leofernandesc/Open-source-sram-memory-compiler/docs/relatorio_validacao_bitcell_6t_sky130.md

# Relatório de desenvolvimento e validação da bitcell SRAM 6T

## Escopo

Este documento registra o desenvolvimento da célula SRAM 6T single-port para SKY130A, incluindo a preparação dos esquemáticos, a criação do testbench hierárquico no Xschem, os testes manuais em ngspice e a automação da varredura de leitura.

O relatório separa resultados executados daqueles que continuam pendentes. A presença de um resultado PASS neste documento não substitui netlist final, caracterização completa, DRC, LVS ou validação do layout.

## Ambiente utilizado

Os testes foram executados no container:

~~~text
isaiassh/unic-cass-tools:1.1.0
~~~

Configuração usada:

~~~text
PDK=sky130A
PDK_ROOT=/opt/pdks
ngspice=44.2
~~~

O projeto foi montado no container em:

~~~text
/home/designer/shared
~~~

O PDK SKY130A usado nos decks está em:

~~~text
/opt/pdks/sky130A
~~~

Biblioteca de modelos:

~~~text
/opt/pdks/sky130A/libs.tech/combined/continuous/sky130.lib.spice
~~~

## 1. Topologia definida

A bitcell possui uma porta de leitura/escrita e seis transistores:

- dois inversores CMOS cruzados, formando o biestável;
- dois NMOS de acesso conectados a BL e BLB;
- uma linha de palavra WL comum aos transistores de acesso;
- nós internos complementares Q e QB;
- alimentação VDD e VSS.

O contrato externo da bitcell é:

~~~text
BL BLB WL VDD VSS
~~~

O sizing de projeto definido inicialmente foi:

| Dispositivos | Função | W (um) | L (um) |
|---|---|---:|---:|
| PMOS pull-up | restauração lógica | 0,21 | 0,15 |
| NMOS pull-down | estabilidade de leitura | 0,42 | 0,15 |
| NMOS de acesso | leitura e escrita | 0,30 | 0,15 |

As razões previstas são:

~~~text
beta  = Wpull-down / Waccess = 0,42 / 0,30 = 1,40
gamma = Wpull-up   / Waccess = 0,21 / 0,30 = 0,70
~~~

Esses valores são requisitos de projeto. Eles ainda não foram validados no modelo contínuo usado nos testes, porque o runtime não encontrou bins válidos para W=0,21 um e W=0,30 um na forma de instância utilizada.

## 2. Captura manual dos esquemáticos

### Esquemático da bitcell 6T no Xschem

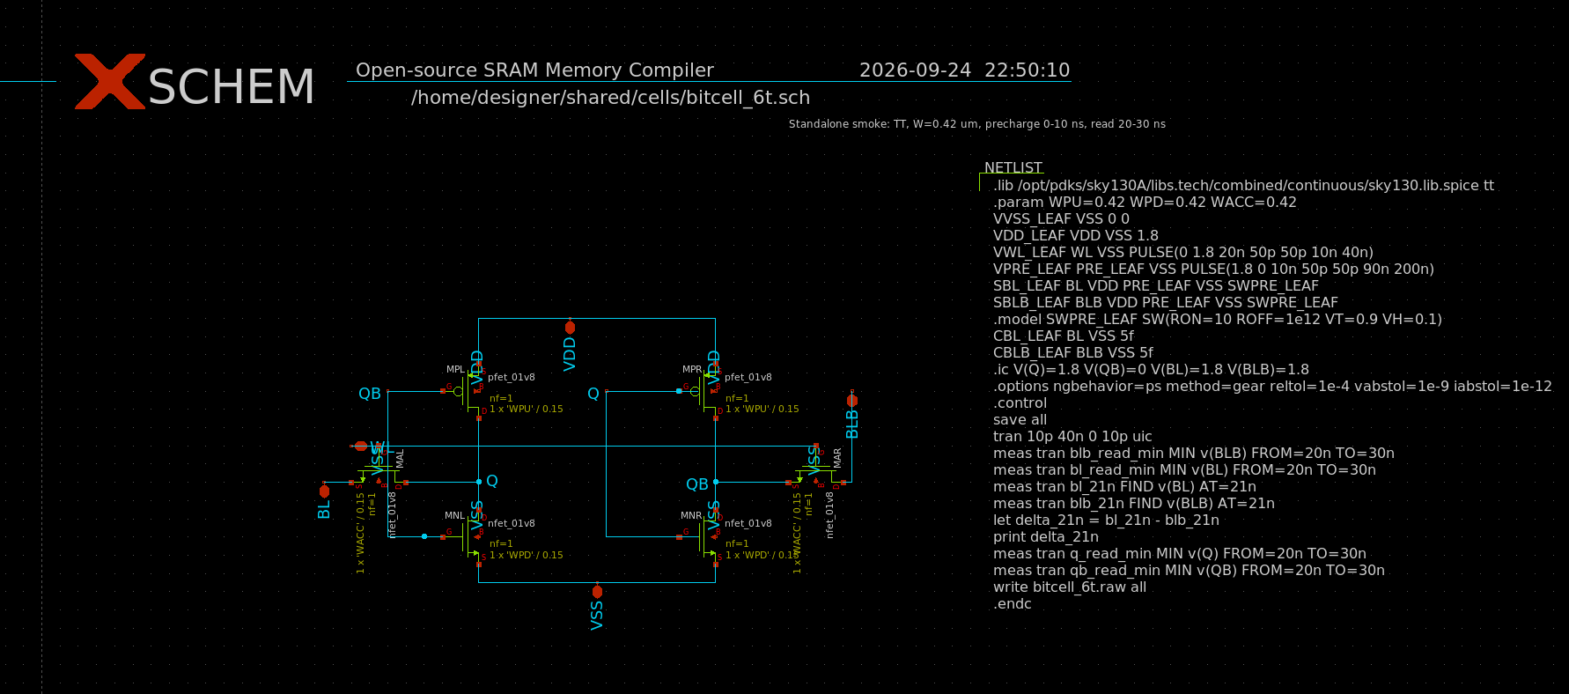
[picture p2: docs/assets/bitcell_6t_xschem.png]
Esquemático da bitcell SRAM 6T no Xschem


*Figura 1. Captura do esquemático da bitcell SRAM 6T com os nós Q, QB, BL, BLB, WL, VDD e VSS.*

### Testbench hierárquico de leitura no Xschem

Foi criado um símbolo hierárquico para a bitcell e um testbench visual de
leitura com a seguinte estrutura:

~~~text
sims/bitcell_6t/tb_bitcell_6t_read.sch
└── cells/bitcell_6t/bitcell_6t.sym
    └── cells/bitcell_6t/bitcell_6t.sch
~~~

O testbench contém a instância `XBITCELL`, fontes de `VDD`, `WL` e `PRE`,
chaves ideais de pré-carga em `BL` e `BLB`, capacitores de 5 fF nas bitlines e
um bloco de controle com as medições de leitura. A sequência representada é:

- pré-carga desligada após 10 ns;
- leitura com `WL` ativo de 20 ns a 30 ns;
- observação de `BL`, `BLB` e `Q`.

Testbench hierárquico da bitcell SRAM 6T no Xschem

*Figura 2. Testbench hierárquico de leitura com a bitcell, pré-carga, capacitâncias de bitline e bloco de controle SKY130A.*

Arquivos criados:

~~~text
cells/bitcell_6t/bitcell_6t.sym
sims/bitcell_6t/tb_bitcell_6t_read.sch
~~~

A geração e a simulação do netlist hierárquico foram verificadas no corner
`tt`. O símbolo expande a interface `VDD BL BLB VSS WL` e permite passar
`WPU`, `WPD` e `WACC`. A instância do testbench usa 0,42 µm nos seis
transistores; os valores alvo continuam como padrões do símbolo e ainda não
foram validados no conjunto de modelos contínuos instalado.

Foram preparados os seguintes arquivos em cells/:

| Arquivo | Função | Estado |
|---|---|---|
| cells/bitcell_6t/bitcell_6t.sch | bitcell SRAM 6T | netlist hierárquico e simulação `tt` verificados com sizing provisório |
| cells/sense_amp/sense_amp.sch | voltage-latch sense amplifier | rascunho estrutural |
| cells/precharge/precharge.sch | pré-carga e equalização | rascunho estrutural |
| cells/wordline_driver/wl_driver.sch | driver de WL | rascunho estrutural |
| cells/write_driver/write_driver.sch | driver diferencial de escrita | rascunho estrutural |
| cells/README.md | contrato de pinos | documentado |

Os nomes de sinais foram padronizados como:

~~~text
BL BLB WL SCLK PRECH DATA DATA_B WE VDD VSS SA_OUT SA_OUTB
~~~

O sense_amp foi definido como um latch diferencial habilitado por SCLK. Os
símbolos das células periféricas ainda dependem de inspeção de conectividade
e validação elétrica próprias.

## 3. Preparação do ambiente gráfico

Inicialmente foi tentado o modo VNC. A porta 80 já estava ocupada pelo container esafe-traefik, causando:

~~~text
Bind for :::80 failed: port is already allocated
~~~

O problema foi contornado usando portas alternativas durante a tentativa VNC:

~~~text
WEBSERVER_PORT=8081
VNC_PORT=5902
JUPYTER_PORT=8889
~~~

Em seguida foi escolhido o modo local, sem VNC, com DISPLAY=:0 e o socket X11 do host:

~~~bash
make \
  SHARED_DIR=/home/danilo_cunha/projetos/ueletronica/projeto-sram/Open-source-sram-memory-compiler \
  PDK=sky130A \
  DOCKER_TAG=1.1.0 \
  start
~~~

Dentro do container, o Xschem foi aberto com:

~~~bash
cd /home/designer/shared
export PDK=sky130A
export PDK_ROOT=/opt/pdks
xschem cells/bitcell_6t/bitcell_6t.sch
~~~

## 4. Dificuldades com o netlist e a simulação Xschem

Ao tentar simular diretamente bitcell_6t.sch, o Xschem gerou instâncias como:

~~~text
XMP1 ... sky130_fd_pr__pfet_01v8
~~~

O ngspice reportou:

~~~text
Unknown subckt: xmp1 ... sky130_fd_pr__pfet_01v8
~~~

Os símbolos `sky130_fd_pr` geram instâncias `X`. Ao netlistar a folha
isoladamente, a biblioteca contínua não estava incluída e o ngspice não
reconhecia `sky130_fd_pr__pfet_01v8` e `sky130_fd_pr__nfet_01v8`. Foi incluído
em `bitcell_6t.sch` um bloco `netlist.sym` marcado `only_toplevel=true`, com a
biblioteca SKY130A `tt` e parâmetros provisórios de 0,42 µm. Assim, o modelo
fica disponível ao netlist isolado; dentro da hierarquia esse bloco é omitido,
pois o testbench já carrega a biblioteca e fornece os parâmetros da instância.

A bitcell continua sendo uma leaf cell. Para que o botão **Simulate** também
seja útil quando `bitcell_6t.sch` estiver aberta diretamente, o bloco top-level
foi ampliado com um smoke test local: fontes de VDD, WL e PRE, duas chaves de
pré-carga, cargas de 5 fF, condições iniciais e análise transitória. Todo esse
conteúdo usa `only_toplevel=true`, portanto não entra no subcircuito quando a
bitcell é instanciada por outro esquemático.

Os avisos sobre arquivos OSDI ausentes, como `psp103_nqs.osdi`, são distintos
da falha `Unknown subckt`; eles não impedem essa simulação com a biblioteca
contínua.

### 4.1 Tentativa de simulação da bitcell isolada

O erro observado foi:

~~~text
Error: unknown subckt: xmpl q qb vdd vdd sky130_fd_pr__pfet_01v8 ...
~~~

O netlist gerado referenciava subcircuitos SKY130 sem carregar a biblioteca e
usava parâmetros de sizing sem valores no contexto top-level. O primeiro
ajuste carregou `sky130.lib.spice tt` e definiu
`WPU=WPD=WACC=0.42 µm`. Isso removeu `unknown subckt`, mas revelou a mensagem:

~~~text
Warning: No job (tran, ac, op etc.) defined:
run simulation not started
~~~

Essa segunda mensagem não indicava falha de modelo. Ela mostrava que a folha
não possuía uma análise. O bloco foi então convertido em `STANDALONE_TEST`,
com estímulos equivalentes aos do testbench hierárquico e o comando
`tran 10p 40n 0 10p uic`.

A simulação isolada passou a produzir:

~~~text
No. of Data Rows : 4038
blb_read_min = 3.727678e-08 V
bl_read_min  = 1.799997 V
bl_21n       = 1.835385 V
blb_21n      = 3.727678e-08 V
delta_21n    = 1.835385 V
q_read_min   = 1.778301 V
qb_read_min  = 3.060375e-08 V
binary raw file "bitcell_6t.raw"
~~~

Esse smoke test valida a leitura de Q=1/QB=0 no corner `tt`, com 5 fF e
sizing uniforme de 0,42 µm. Ele não substitui o sweep de corners, estados e
capacitâncias executado pelo deck externo.

### 4.2 Simulação hierárquica de leitura

O testbench hierárquico permite inspecionar as conexões e executar a leitura
no Xschem. A expansão foi confirmada com:

~~~spice
XBITCELL VDD BL BLB GND WL bitcell_6t WPU=0.42 WPD=0.42 WACC=0.42
.subckt bitcell_6t VDD BL BLB VSS WL WPU=0.21 WPD=0.42 WACC=0.30
~~~

O erro `could not find a valid modelname` ocorria porque as larguras alvo de
0,21 e 0,30 µm não selecionam bins válidos dos modelos contínuos instalados.
Com a instância provisória de 0,42 µm, `.lib .../sky130.lib.spice tt` e
condições iniciais nos nós `xbitcell.Q`/`xbitcell.QB`, o netlist hierárquico
foi simulado pelo ngspice sem esse erro. A diferença em 21 ns foi
`1,835385 V`; o mínimo de Q durante a leitura foi `1,778301 V`. O deck
externo produziu `1,83618 V` e `1,773700 V`, respectivamente. A pequena
diferença reflete detalhes distintos de parasitas das instâncias.

## 5. Testes manuais sem automação

### 5.1 Testbench manual de retenção, leitura inicial e escrita

Arquivo:

~~~text
sims/bitcell_6t/tb_bitcell_6t.spice
~~~

Execução:

~~~bash
cd /home/designer/shared/sims/bitcell_6t
ngspice -n -b tb_bitcell_6t.spice | tee tb_bitcell_6t_tt.log
~~~

Resultado obtido:

~~~text
q_hold              = 1.800000e+00
qb_hold             = 3.777216e-08
bl_read             = 1.800000e+00
blb_read            = 1.800000e+00
q_read_min          = 1.799998e+00
q_after_write       = 3.769092e-08
qb_after_write      = 1.800000e+00
ngspice-44.2 done
~~~

Interpretação:

| Verificação | Resultado |
|---|---|
| retenção de Q=1, QB=0 | passou |
| escrita para Q=0, QB=1 | passou |
| execução do ngspice | passou |
| diferencial real de leitura | não validado neste deck |

A leitura não foi validada nesse primeiro deck porque BL e BLB estavam presas a fontes ideais de 1,8 V.

Esse deck também usou, por limitação do modelo contínuo, o sizing provisório:

~~~text
WPU=WPD=WACC=0,42 um
~~~

### 5.2 Testbench manual de leitura com bitlines capacitivas

Arquivo:

~~~text
sims/bitcell_6t/tb_bitcell_6t_read.spice
~~~

O segundo deck acrescentou:

- chaves controladas para pré-carga;
- capacitâncias em BL e BLB;
- liberação das bitlines durante WL;
- medição de BLB mínimo para o estado Q=1, QB=0;
- medição de BL mínimo para o estado inverso Q=0, QB=1;
- medição do nó armazenado em nível alto para verificar read disturb.

Execução manual:

~~~bash
cd /home/designer/shared/sims/bitcell_6t
ngspice -n -b tb_bitcell_6t_read.spice | tee tb_bitcell_6t_read_5f.log
~~~

Para CBL=CBLB=5 fF, após corrigir o período de `PRE`, o resultado foi:

~~~text
bl_pre              = 1.800000 V
blb_pre             = 1.800000 V
bl_21n              = 1.836183 V
blb_21n             = 0.000000046 V
delta_21n           = 1.83618 V
q_read_min          = 1.773700 V
~~~

Na versão anterior, `PRE` voltava ao nível alto em 20 ns, junto com `WL`.
Por isso, o diferencial de `1,08432 mV` em 29 ns e a queda máxima de
`0,8468485 V` não mediam a leitura com a pré-carga desligada. Esses
resultados foram substituídos. A medição de `blb_read_min` continua útil para
acompanhar a descarga completa, mas o critério automatizado usa a diferença
entre `BL` e `BLB` em 21 ns:

~~~spice
.meas tran bl_21n FIND V(bl) AT=21n
.meas tran blb_21n FIND V(blb) AT=21n
.meas tran blb_read_min MIN V(blb) FROM=20n TO=30n
~~~

Uma diretiva .meas deve estar dentro do arquivo SPICE. Ela não pode ser digitada diretamente no Bash.

## 6. Automação da varredura

Foi criado o script:

~~~text
sims/bitcell_6t/run_bitcell_read_sweep.py
~~~

O script:

1. lê tb_bitcell_6t_read.spice como template;
2. troca a capacitância de BL e BLB;
3. testa os estados Q=1/QB=0 e Q=0/QB=1;
4. troca automaticamente o corner do .lib;
5. executa o ngspice em arquivos temporários;
6. extrai BL/BLB em 21 ns, os mínimos das bitlines e os mínimos de Q/QB;
7. calcula o diferencial em 21 ns com a polaridade esperada para cada estado;
8. verifica o nó armazenado em nível alto;
9. salva o resultado em CSV;
10. retorna código diferente de zero se algum caso falhar.

Critérios usados pelo script:

~~~text
delta_21n >= 50 mV
nó armazenado em nível alto >= 0,9 V
~~~

O segundo critério é selecionado corretamente para cada estado. Quando Q=0, Q próximo de zero é esperado; nesse caso, o script verifica QB.

### 6.1 Execução padrão

~~~bash
cd /home/designer/shared/sims/bitcell_6t
python3 run_bitcell_read_sweep.py
~~~

Essa execução usa o corner padrão tt e quatro capacitâncias:

~~~text
5 fF, 10 fF, 20 fF e 50 fF
~~~

### 6.2 Execução em todos os corners

~~~bash
python3 run_bitcell_read_sweep.py --corners tt ff ss fs sf
~~~

Essa execução cobre:

~~~text
5 corners × 4 capacitâncias × 2 estados = 40 simulações
~~~

Relatório gerado:

~~~text
sims/bitcell_6t/bitcell_read_sweep.csv
~~~

## 7. Resultado automatizado nos corners SKY130A

Todos os 40 casos executados retornaram PASS com os critérios provisórios do script.

O menor diferencial em 21 ns foi:

| Corner | Capacitância | Estado | Bitline descarregada | delta_21n |
|---|---:|---:|---|---:|
| ss | 50 fF | Q=1 ou Q=0 | BLB ou BL | 1,4258955 V |

Menores diferenciais por corner em 50 fF:

| Corner | delta_21n mínimo |
|---|---:|
| tt | 1,6381313 V |
| ff | 1,7337567 V |
| ss | 1,4258955 V |
| fs | 1,4886067 V |
| sf | 1,7171562 V |

Esses resultados mostram margem acima do critério automatizado de 50 mV para o modelo e o sizing provisório usados.

## 8. Limitações e interpretação dos resultados

Os resultados não constituem sign-off da bitcell. Permanecem as seguintes limitações:

1. O teste automatizado usa WPU=WPD=WACC=0,42 um, não o sizing alvo WPU=0,21 um, WPD=0,42 um e WACC=0,30 um.
2. O modelo contínuo disponível rejeitou os bins necessários para os valores menores de largura na forma de instância usada.
3. O critério automatizado usa `delta_21n >= 50 mV`. A janela de detecção real do sense amplifier e a capacitância de uma coluna completa ainda precisam ser definidos.
4. O testbench hierárquico foi validado no corner `tt` e estado Q=1/QB=0; o sweep de cinco corners e dois estados usa o deck externo.
5. sense_amp, precharge, wl_driver e write_driver ainda não possuem testbenches elétricos aprovados.
6. Não foram executados SNM de retenção, SNM de leitura, write margin, leakage, Monte Carlo de mismatch, DRC, LVS ou extração parasitária.
7. A bitline foi representada por um modelo simples de chave e capacitor. Esse modelo ainda não representa a coluna completa, a resistência dos drivers, o sense amplifier ou a distribuição real de parasitas.

## 9. Estado atual

| Item | Estado |
|---|---|
| topologia 6T | definida |
| contrato de pinos | definido |
| captura inicial Xschem | netlist e conectividade verificados |
| smoke isolado da bitcell | simulação `tt`, 4038 pontos e arquivo RAW gerado |
| retenção manual | passou no sizing provisório |
| escrita manual | passou no sizing provisório |
| leitura com bitlines ideais | não conclusiva |
| leitura com bitlines capacitivas | passou com critério de 50 mV |
| sweep de capacitância | automatizado |
| corners tt/ff/ss/fs/sf | 40 casos executados, todos PASS no critério de 50 mV |
| símbolo hierárquico da bitcell | criado e expandido no netlist Xschem |
| testbench hierárquico de leitura | simulado em `tt`; deck externo usado para sweep |
| sizing alvo 0,21/0,42/0,30 um | pendente |
| sense amplifier | pendente |
| drivers e pré-carga | pendentes |
| SNM, write margin e leakage | pendentes |
| layout, DRC e LVS | pendentes |

## 10. Próximos testes

A sequência recomendada é:

1. Obter modelos válidos para o sizing alvo e reexecutar a varredura.
2. Definir o instante de habilitação do sense amplifier e a carga real da coluna.
3. Automatizar retenção e escrita nos cinco corners.
4. Testar o precharge com equalização e desligamento correto.
5. Testar o write_driver com DATA, DATA_B e WE.
6. Testar o wl_driver, medindo amplitude e atraso de WL.
7. Criar o testbench do sense_amp com diferenças de entrada de 5 mV a 20 mV.
8. Integrar a sequência precharge -> write -> hold -> read -> SCLK.
9. Medir SNM, write margin, leakage e variação Monte Carlo.
10. Só depois iniciar layout, DRC, LVS e extração parasitária.
