leofernandesc/Open-source-sram-memory-compiler/layout/row_decoder/reports/lvs_connectivity.txt

Magic 8.3 revision 684 - Compiled on Thu Oct  8 05:07:09 PM CEST 2026.
Starting magic under Tcl interpreter
Using the terminal as the console.
Using NULL graphics device.
Processing system .magicrc file
Switching to WIRING tool.
Switching to NETLIST tool.
Switching to PICK tool.
Switching to BOX tool.
Sourcing design .magicrc for technology sky130A ...
2 Magic internal units = 1 Lambda
Input style sky130(): scaleFactor=2, multiplier=2
The following types are not handled by extraction and will be treated as non-electrical types:
    ubm
Scaled tech values by 2 / 1 to match internal grid scaling
Loading sky130A Device Generator Menu ...
Using technology "sky130A", version 1.0.493-0-g0fe599b
Cell row_decoder_flat read from current working directory
Extracting row_decoder_flat into row_decoder_flat.ext:
Processing row_decoder_flat
exttospice finished.
