leofernandesc/Open-source-sram-memory-compiler/docs/row_decoder_sizing.md

# Dynamic row decoder sizing record

Current-source update (2026-10-07): **B7 is now retained** after a complete
264-case qualification and finer numerical comparisons. The B0--B6 tables
below remain historical experiments. Use the
[current characterization record](row_decoder_contract_characterization.md)
for the 29-MOS buffered source, measured costs and remaining limits, and the
[Person 3 Phase 1 plan](person3_phase1_remaining_tasks.md) for subsequent work.

Status: sizing in progress. The measurements below define the loaded reference
candidate; they do not establish final transistor sizes or PVT robustness.

The [whole-circuit review and sizing campaign](row_decoder_sizing_plan.md)
extends this record. The repaired runner reproduces B5 timing and its output
logic passes, but its output-NMOS VGS screen detects dynamic-node peaks above
the published 1.95 V model envelope under the original 50 ps clock. Gear 10 ps,
Gear 5 ps, and trapezoidal 5 ps runs all report 16/16 excursions, so the finding
is not specific to the tested integration method or timestep. Historical
72/72 PASS entries below refer to sampled output voltages, not this envelope
check. Clock/model-envelope closure now precedes final sizing.

The current schematic is corrective candidate **B6**. Its measured precharge
and address-inverter widths remove the observed upper excursions under the
tested conditions. See [the feedthrough investigation](row_decoder_feedthrough_fix.md)
for cause isolation, alternatives, terminal extrema and PVT experiments.

## Baseline setup

| Item | Value |
|---|---|
| Candidate | `B0` — uniform baseline |
| Schematic | `cells/row_decoder/row_decoder.sch` |
| Testbench | `sims/row_decoder/tb_row_decoder_sizing.sch` |
| Process/model | SKY130A, TT |
| Supply/temperature | 1.80 V, 27 °C |
| Tools | Xschem 3.4.6, ngspice 44.2 |
| Wordline load | One 17.4 fF capacitor from each `WL` output to GND |
| Load implementation | Four hierarchical instances of `cells/wordline_driver/wl_driver.sch` |
| Decoder sizing | All 25 MOS: W=1.00 µm, L=0.15 µm, nf=1, mult=1 |
| Wordline driver sizing | Stage 1 W=0.42 µm; stage 2 W=0.84 µm; L=0.15 µm |

The 17.4 fF capacitor is the current pre-layout estimate for one complete
wordline. It is attached to each wordline-driver output; the decoder output
drives the input devices of that driver. The separate 50 fF stress load has not
been run in this decoder sizing series.

The copied testbench preserves the original functional bench. Its current
generated node mapping is `net5`=WL0, `net6`=WL1, `net7`=WL2, and `net8`=WL3.
The sizing bench was netlisted after correcting the WL1 output connection; all
four decoder outputs now feed distinct drivers and all four WL outputs have
separate loads.

## Measurement definitions

- Evaluation level checks: sample DEC and WL outputs at 15, 35, 55, and 75 ns
  for addresses 00, 01, 10, and 11.
- Precharge level checks: sample DEC and WL outputs at 5, 25, 45, 65, and 85 ns.
- Screening limits: selected output >= 0.9 VDD (1.62 V); inactive output <=
  0.1 VDD (0.18 V). These limits are used by this screen and are not numeric
  limits stated in the technical specification.
- Evaluation delay: PCLK rising through 0.5 VDD to the selected DEC or WL output
  rising through 0.5 VDD.
- Precharge delay: PCLK falling through 0.5 VDD to the selected DEC or WL output
  falling below 0.1 VDD.

Each run contains 36 DEC voltage samples and 36 WL voltage samples. Rise and
precharge delays are measured for each selected row. Keep these definitions and
the same input stimulus for every candidate.

## Candidate comparison

| Candidate | W address inverter | W precharge PFET | W evaluation NMOS | W footer NMOS | W output inverter P/N | Load | DEC eval max | WL eval max | DEC precharge max | WL precharge max | Voltage checks |
|---|---:|---:|---:|---:|---:|---:|---:|---:|---:|---:|---|
| B0 | 1.00 µm | 1.00 µm | 1.00 µm | 1.00 µm | 1.00 / 1.00 µm | 17.4 fF | 93.30 ps | 272.65 ps | 119.55 ps | 295.94 ps | 72/72 PASS |
| B1 | 1.00 µm | 1.00 µm | 1.50 µm | 1.00 µm | 1.00 / 1.00 µm | 17.4 fF | 95.04 ps | 274.60 ps | 151.92 ps | 326.98 ps | 72/72 PASS |
| B2 | 1.00 µm | 1.00 µm | 1.00 µm | 1.50 µm | 1.00 / 1.00 µm | 17.4 fF | 84.56 ps | 263.50 ps | 123.18 ps | 298.50 ps | 72/72 PASS |
| B3 | 1.00 µm | 1.00 µm | 1.00 µm | 1.25 µm | 1.00 / 1.00 µm | 17.4 fF | 87.93 ps | 267.03 ps | 121.60 ps | 297.23 ps | 72/72 PASS |
| B4 | 1.00 µm | 1.00 µm | 1.00 µm | 0.75 µm | 1.00 / 1.00 µm | 17.4 fF | 102.59 ps | 282.46 ps | 118.54 ps | 294.75 ps | 72/72 PASS |
| B5 | 1.00 µm | 1.00 µm | 1.00 µm | 0.50 µm | 1.00 / 1.00 µm | 17.4 fF | 121.92 ps | 302.94 ps | 117.35 ps | 292.90 ps | 72/72 PASS |
| B6 | 0.42 µm | 0.42 µm | 1.00 µm | 0.50 µm | 1.00 / 1.00 µm | 17.4 fF | 121.36 ps | 302.04 ps | 240.05 ps | 413.64 ps | 72/72 PASS; upper VGS screen PASS |

B6 is measured with Gear 5 ps; B0–B5 historical timing uses the original
10 ps reference. The feedthrough report compares B5 and B6 at the same 5 ps
setting. Its 54-condition B6 campaign is separate from the historical TT-only
footer experiments. B6 is a corrective baseline, not a final optimum.

All channels are L=0.15 µm for B0. Group membership is:

- Address inverters: M1–M4.
- Precharge PFETs: M5, M11, M16, M21.
- Evaluation NMOS network: M6, M7, M12, M13, M17, M18, M22, M23.
- Shared footer: M8.
- DEC output inverters: M9/M10, M14/M15, M19/M20, M24/M25 (PMOS/NMOS).

## B0 measured results

| Metric | Result |
|---|---:|
| Evaluation samples passing | 32/32 (16 DEC + 16 WL) |
| Precharge samples passing | 40/40 (20 DEC + 20 WL) |
| Selected DEC and WL levels | 1.800 V at all sample points |
| Largest absolute deselected DEC sample | 0.994 µV |
| Largest absolute deselected WL sample | 0.292 µV |
| Largest absolute DEC precharge sample | 0.434 µV |
| Largest absolute WL precharge sample | 0.292 µV |
| DEC evaluation delay range | 88.74–93.30 ps |
| WL evaluation delay range | 268.01–272.65 ps |
| DEC precharge delay range | 117.90–119.55 ps |
| WL precharge delay range | 293.70–295.94 ps |

## B1 measured results

B1 changes only the evaluation-network NMOS widths (M6, M7, M12, M13, M17,
M18, M22, and M23) from 1.00 µm to 1.50 µm. The shared footer M8 and all other
devices remain at B0 widths. Xschem generated the updated hierarchy without
structural errors; the generated SPICE netlist was checked to contain W=1.50 µm
on all eight changed devices. ngspice completed with return code 0.

| Metric | Result |
|---|---:|
| Evaluation samples passing | 32/32 (16 DEC + 16 WL) |
| Precharge samples passing | 40/40 (20 DEC + 20 WL) |
| Selected DEC and WL levels | 1.800 V at all sample points |
| Largest absolute deselected DEC sample | 1.311 µV |
| Largest absolute deselected WL sample | 0.291 µV |
| Largest absolute DEC precharge sample | 0.486 µV |
| Largest absolute WL precharge sample | 0.291 µV |
| DEC evaluation delay range | 90.44–95.04 ps |
| WL evaluation delay range | 270.03–274.60 ps |
| DEC precharge delay range | 147.97–151.92 ps |
| WL precharge delay range | 323.50–326.98 ps |

Relative to B0, B1's maximum measured delays increased by 1.74 ps for DEC
evaluation, 1.95 ps for WL evaluation, 32.37 ps for DEC precharge, and 31.04 ps
for WL precharge. Thus B1 passes the same nominal voltage screen but does not
improve the measured timing for this load. The larger evaluation devices add
capacitance to the dynamic nodes; that is a plausible contributor to the slower
precharge and is an engineering interpretation of the measurements, not a
separately isolated capacitance measurement.

## B2 measured results

B2 returns the eight evaluation-network NMOS devices to 1.00 µm and changes
only the shared footer M8 from 1.00 µm to 1.50 µm. Xschem generated the current
schematic hierarchy without structural errors; the generated netlist was checked
to contain the intended widths. ngspice completed with return code 0.

| Metric | Result |
|---|---:|
| Evaluation samples passing | 32/32 (16 DEC + 16 WL) |
| Precharge samples passing | 40/40 (20 DEC + 20 WL) |
| Selected DEC and WL levels | 1.800 V at all sample points |
| Largest absolute deselected DEC sample | 0.995 µV |
| Largest absolute deselected WL sample | 0.291 µV |
| Largest absolute DEC precharge sample | 0.439 µV |
| Largest absolute WL precharge sample | 0.291 µV |
| DEC evaluation delay range | 79.44–84.56 ps |
| WL evaluation delay range | 258.32–263.50 ps |
| DEC precharge delay range | 120.23–123.18 ps |
| WL precharge delay range | 296.28–298.50 ps |

Relative to B0, B2's maximum evaluation delays decreased by 8.74 ps for DEC
and 9.15 ps for WL. Its maximum precharge delays increased by 3.63 ps for DEC
and 2.56 ps for WL. B2 therefore improves evaluation timing in this nominal
loaded screen while slightly slowing precharge; both phases still pass the
screening voltage limits.

## B3 measured results

B3 changes only the shared footer M8 from 1.50 µm in B2 to 1.25 µm; all other
devices remain at B0 widths. The Xschem-generated netlist confirmed M8 at
W=1.25 µm and the eight evaluation-network NMOS devices at W=1.00 µm. Xschem
and ngspice completed without errors.

| Metric | Result |
|---|---:|
| Evaluation samples passing | 32/32 (16 DEC + 16 WL) |
| Precharge samples passing | 40/40 (20 DEC + 20 WL) |
| Selected DEC and WL levels | 1.800 V at all sample points |
| Largest absolute deselected DEC sample | 0.994 µV |
| Largest absolute deselected WL sample | 0.291 µV |
| Largest absolute DEC precharge sample | 0.436 µV |
| Largest absolute WL precharge sample | 0.291 µV |
| DEC evaluation delay range | 83.14–87.93 ps |
| WL evaluation delay range | 262.17–267.03 ps |
| DEC precharge delay range | 118.88–121.60 ps |
| WL precharge delay range | 295.15–297.23 ps |

Relative to B0, B3's maximum evaluation delays decreased by 5.37 ps for DEC
and 5.62 ps for WL. Its maximum precharge delays increased by 2.05 ps for DEC
and 1.29 ps for WL. B2 remains faster in evaluation, while B3 is slightly
faster in precharge.

## B4 measured results

B4 changes only the shared footer M8 from 1.00 µm in B0 to 0.75 µm; all other
devices remain at B0 widths. The Xschem-generated netlist confirmed the intended
widths, and Xschem and ngspice completed without errors.

| Metric | Result |
|---|---:|
| Evaluation samples passing | 32/32 (16 DEC + 16 WL) |
| Precharge samples passing | 40/40 (20 DEC + 20 WL) |
| Selected DEC and WL levels | 1.800 V at all sample points |
| Largest absolute deselected DEC sample | 0.994 µV |
| Largest absolute deselected WL sample | 0.291 µV |
| Largest absolute DEC precharge sample | 0.432 µV |
| Largest absolute WL precharge sample | 0.291 µV |
| DEC evaluation delay range | 98.62–102.59 ps |
| WL evaluation delay range | 278.41–282.46 ps |
| DEC precharge delay range | 116.66–118.54 ps |
| WL precharge delay range | 291.89–294.75 ps |

Relative to B0, B4's maximum evaluation delays increased by 9.29 ps for DEC
and 9.81 ps for WL, while maximum precharge delays decreased by 1.01 ps for
DEC and 1.19 ps for WL. B4 therefore trades evaluation speed for a small
precharge improvement.

## B5 measured results

B5 changes only the shared footer M8 from 0.75 µm in B4 to 0.50 µm; all other
devices remain at the B0 widths. The Xschem-generated netlist confirmed M8 at
W=0.50 µm and the eight evaluation-network NMOS devices at W=1.00 µm. The
loaded testbench contains the four wordline drivers and a 17.4 fF capacitor on
each wordline. Xschem and ngspice completed without errors.

| Metric | Result |
|---|---:|
| Evaluation samples passing | 32/32 (16 DEC + 16 WL) |
| Precharge samples passing | 40/40 (20 DEC + 20 WL) |
| Selected DEC and WL levels | 1.800 V at all sample points |
| Largest absolute deselected DEC sample | 0.995 µV |
| Largest absolute deselected WL sample | 0.291 µV |
| Largest absolute DEC precharge sample | 0.430 µV |
| Largest absolute WL precharge sample | 0.291 µV |
| DEC evaluation delay range | 118.60–121.92 ps |
| WL evaluation delay range | 299.58–302.94 ps |
| DEC precharge delay range | 114.53–117.35 ps |
| WL precharge delay range | 289.82–292.90 ps |

Relative to B0, B5's maximum evaluation delays increased by 28.62 ps for DEC
and 30.29 ps for WL, while maximum precharge delays decreased by 2.20 ps for
DEC and 3.04 ps for WL. Relative to B4, evaluation became 19.33 ps slower for
DEC and 20.48 ps slower for WL; precharge became 1.19 ps faster for DEC and
1.85 ps faster for WL. B5 passes the same nominal voltage screen and is the
fastest precharge candidate measured so far, with the slowest evaluation among
the tested footer widths. These results show a timing tradeoff; they do not
identify a single best width without a project-level priority between
evaluation and precharge.

## B6 corrective sizing results

B6 changes the four address-inverter and four precharge widths to 0.42 um,
while retaining M8 at 0.50 um and the other devices at 1.00 um. Fresh Xschem
netlisting matches the netlist used in its qualification campaign. At TT,
1.8 V, 27 C, 50 ps clock and 17.4 fF/WL, the loaded testbench passes 72/72
voltage samples and 252 non-model window/internal/timing checks. Maximum
output-NMOS VGS drops to 1.90111 V; there are no per-cycle upper excursions.
The bare decoder also passes all 36 voltage samples.

Relative to B5 with the same Gear 5 ps method, maximum WL evaluation changes
from 302.91 to 302.04 ps, while WL precharge completion increases from 292.39
to 413.64 ps. This longer recovery must be retained in the low-phase budget.
Mean VDD stimulus-cycle energy drops from 123.76 to 120.46 fJ; clock/address
source energy is excluded. Sum(W*L) drops from 3.675 to 2.979 um2, a channel
proxy rather than measured layout area.

## Interpretation and next work

B0 is a measured nominal-TT reference with the wordline drivers and estimated
wordline loads attached. B1 is functionally passing in the same nominal-TT
screen, but is slower than B0 in all four recorded maximum timing metrics. B2
is fastest in evaluation so far; reducing the footer toward B3, B4, and B5
trades evaluation speed for faster precharge. B5 is fastest in precharge so
far within that historical footer series. B0–B5 were measured at nominal TT
without the later terminal-envelope criteria. B6 adds a PVT/slew experiment;
none of these results establish decoder layout, DRC, LVS or extracted timing.

Continue with the address-history, captured-address setup and phase-duration
experiments from B6, retaining both timing and terminal-voltage checks. Further
family sizing, including a possible 0.42 um footer, must preserve the measured
voltage margins and precharge budget rather than ranking candidates only by
their evaluation delay.

Before selecting that combined candidate, follow the clock/model-envelope,
address-history, family/interactions, load, PVT and extracted-netlist campaign
in the linked review. At the historical B5 sizes, 250 ps clock edges pass the
tested upper-VGS screen while 50 ps edges do not; this diagnostic does not
approve a new macro clock-slew limit.

## 2026-10-07: expanded address-history qualification supersedes the sizing inference

The earlier B6 results remain measurements for their archived stimulus. They
do not qualify every address history: simultaneous two-bit changes with
Gear 1 ps and CHGTOL=1e-18 C expose an M2 VDS maximum of **1.974458 V**
at SS/1.8 V/-40 C. B6 remains the source schematic, not a final robust sizing.

Leonardo selected greater electrical margin and robustness as the decoder
selection priority. The implemented contract executor now measures all ordered
histories, address arrival, phase lengths, finite retention, edge asymmetry,
charge perturbations, signed external MOS terminal extrema and family
interactions. Failed comparisons are retained. The new
[characterization record](row_decoder_contract_characterization.md) contains
the current evidence, numerical-breakpoint investigation and reproducible
commands. Physical closure and full signed model-domain review remain open.
