leofernandesc/Open-source-sram-memory-compiler/docs/cwl_pre_layout_estimate.md

# Orçamento pré-layout da capacitância de wordline

Status em 05/10/2026: **baseline pré-layout congelada; G6 físico concluído e
G7/PEX aberto**. A bitcell e o `wl_driver` já possuem layout com Magic DRC `0`
e Netgen LVS único. Os valores deste documento permanecem como referência do
screening esquemático e **não** devem ser tratados como capacitâncias PEX.

Fonte dos resultados: documentação e CSVs importados da branch de Danilo
`feat/sram-6t-cell`, commit `8c16199`. Esses resultados não foram reexecutados
nesta branch.

Fonte dos resultados: documentação e CSVs importados da branch do Danilo
`feat/sram-6t-cell`, commit `8c16199`. Esses resultados não foram reexecutados
nesta branch.

Este documento fecha um bound de engenharia para a carga da wordline antes do
layout. O objetivo é substituir o antigo smoke arbitrário de `50 fF` por uma
carga derivada dos gates das oito bitcells da linha e de uma restrição física
de roteamento. O valor continua sendo pré-layout e deve ser substituído pelo
PEX no G7 após o fechamento físico G6.

## Capacitância dos gates de acesso

`sims/run_wordline_capacitance.py` mede por AC pequena-sinal a capacitância de
gate do NMOS de acesso da bitcell 6T, com `WACC=0,60 µm` e `WL=0`, nos cinco corners,
`1,62/1,80 V`, `-40/27/125 °C`, dois estados de Q e as duas orientações
source/drain.

- `120/120 PASS`;
- `Cgate,max = 0,541868469 fF`;
- pior ponto: `ff/1,80 V/-40 °C`, Q=0;
- uma linha de 8 bits contém 16 gates de acesso:
  `Cgate,row,max = 16 × 0,541868469 = 8,669895504 fF`.

No bench integrado, os dois gates da célula selecionada já estão presentes no
netlist. Logo, a parcela adicional das outras sete células é:

```text
Cgate,extra = 14 × 0,541868469
            = 7,586158566 fF
```

## Bound pré-layout do fio

Para schematic freeze, a WL é orçada em `metal1`, largura mínima `0,14 µm`,
com até `5,0 µm` de extensão horizontal por bit e oito bits por linha. O corner
de capacitância máxima do `sky130A.tech` fornece:

- `defaultareacap(metal1) = 35,7 aF/µm²`;
- `defaultperimeter(metal1) = 49,59 aF/µm`;
- `defaultsidewall(metal1) = 37,6 aF/µm`;
- `metal1 -> metal2 defaultoverlap = 313 aF/µm²`;
- dois vizinhos laterais;
- 16 cruzamentos M1–M2, pois a WL cruza `BL` e `BLB` dos oito bits;
- margem adicional de engenharia de 20%.

O bound é:

```text
Cwire_per_um = (35,7×0,14 + 2×49,59 + 2×37,6) aF/µm
             = 0,179378 fF/µm

Ccross_M1_M2 = 313×0,14×0,14 aF
             = 0,0061348 fF por cruzamento

CWL_wire = 1,20 × (40×0,179378 + 16×0,0061348)
          = 8,727932160 fF
```

## Bound e ponto de screening

```text
CWL,row,max = Cgate,row,max + CWL_wire
            = 8,669895504 + 8,727932160
            = 17,397827664 fF

CWL,extra,max = Cgate,extra + CWL_wire
              = 7,586158566 + 8,727932160
              = 16,314090726 fF
```

Os benches integrados usam a bitcell selecionada explicitamente. Por isso o
capacitor lumped adicional adotado é **17 fF**, acima do bound
`CWL,extra,max=16,314090726 fF`. O antigo smoke de `50 fF` continua válido
apenas como stress test conservador e não como estimativa física da linha.

O bound `CWL,row,max=17,397827664 fF` e o capacitor lumped adicional de `17 fF`
ficam preservados como baseline pré-layout. Com o layout das leafs já fechado
em G6 e a extração RC das leafs iniciada no G7, a etapa pendente é obter a carga
física representativa da wordline na integração de coluna/array e substituir a
baseline lumped pelo valor pós-layout correspondente. Em seguida, requalificar
slew, atraso, largura efetiva de WL e read-disturb. Se o PEX alterar o contrato
usado no screening, o gate de timing da WL deve ser reaberto.
