leofernandesc/Open-source-sram-memory-compiler/memory/memory-ip/run_state.md

run_id:      memory-ip_20260921_165204
design_name: sram_6t_cell
tool:        xschem
start_time:  2026-09-21T16:52:04-04:00
last_stage:  schematic_capture
