leofernandesc/Open-source-sram-memory-compiler/docs/assets/capture_to_pclk_margin.png

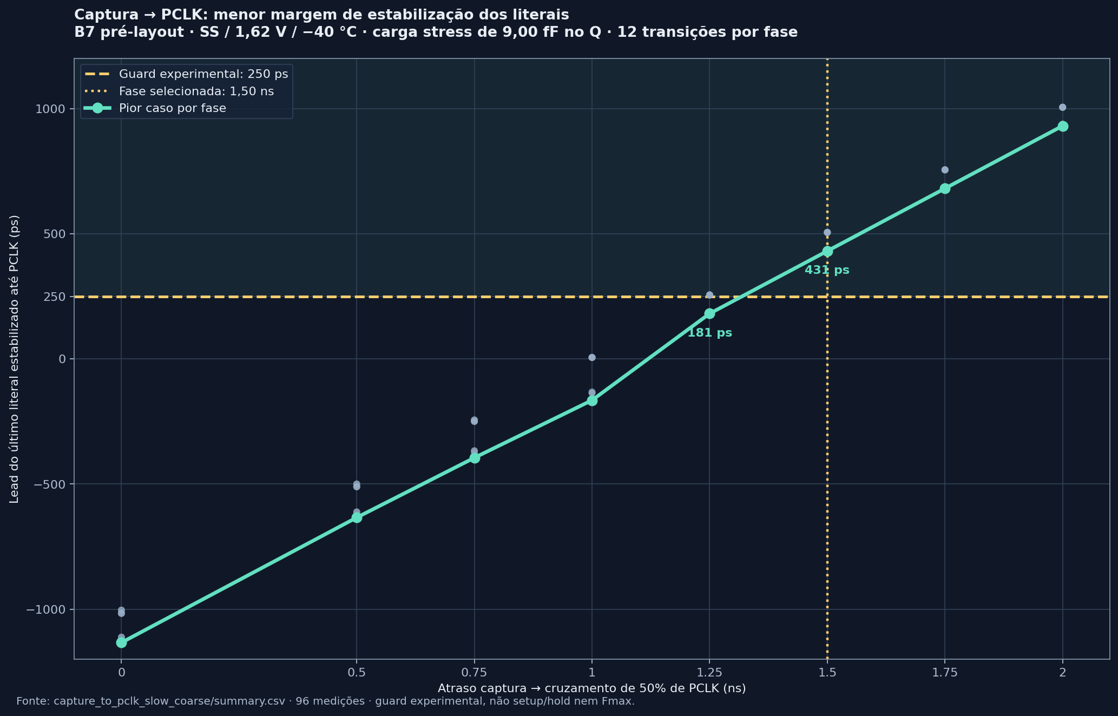
docs/assets/capture_to_pclk_margin.png
