leofernandesc/Open-source-sram-memory-compiler/docs/assets/row_decoder_b7.png

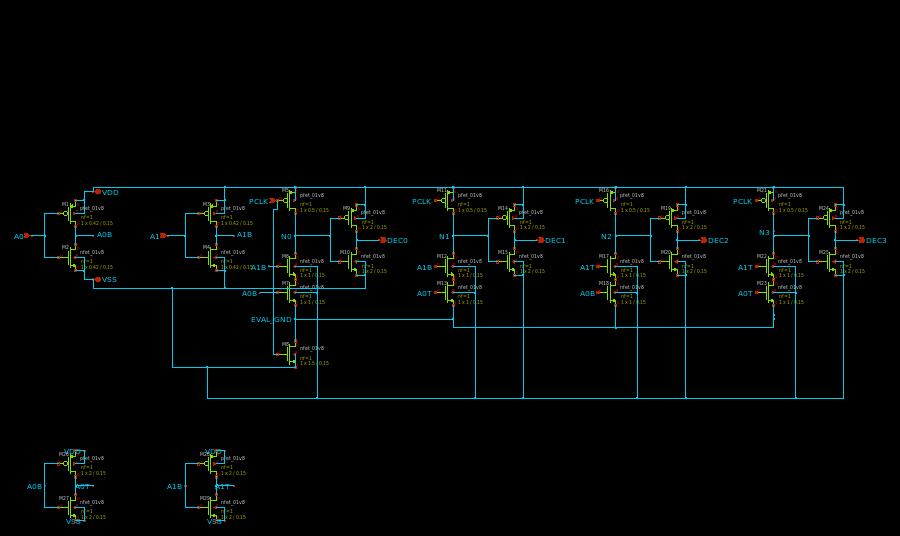
docs/assets/row_decoder_b7.png
