leofernandesc/Open-source-sram-memory-compiler/layout/row_decoder/reports/compaction/build.txt

Xschem MOS: 29 (12 PFET, 17 NFET)
Magic DRC hierarchical/top: 0
Magic DRC flattened: 0
Logs: /work/layout/row_decoder/reports
DRC PASS
Magic connectivity extraction: 29 MOS devices; no RC PEX requested
Netgen LVS: Circuits match uniquely
Logs: /work/layout/row_decoder/reports/lvs_extract.log and /work/layout/row_decoder/reports/lvs.log
RC PEX is stale/pending; no extresist was run.
