leofernandesc/Open-source-sram-memory-compiler/sims/row_decoder/results/row_decoder_pex_precharge_refinement_20261008/waveforms.pdf

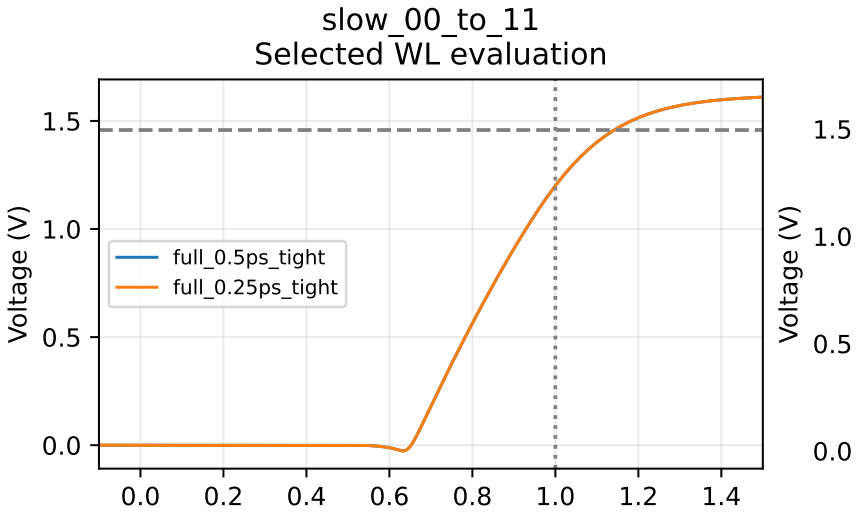
[picture p21: figure]
Voltage (V); slow_00_to_11 Selected WL evaluation; full_0.5ps_tight; full_0.25ps_tight

Time from PCLK 50% edge (ns)

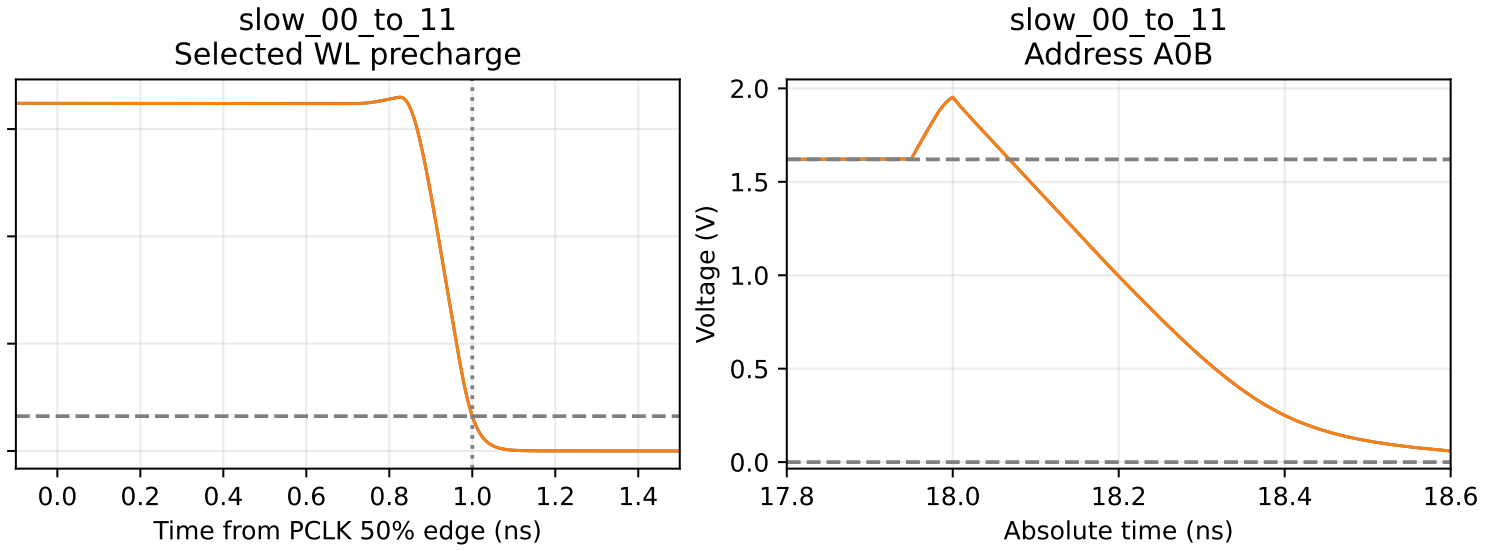
[picture p22: figure]
slow_00_to_11 Selected WL precharge; Absolute time (ns); Voltage (V); slow_00_to_11 Address A0B

Time from PCLK 50% edge (ns)

Existing decoder PEX: convergence and artificial R/C isolation No R / no C curves are diagnostic only; WL buffers remain schematic

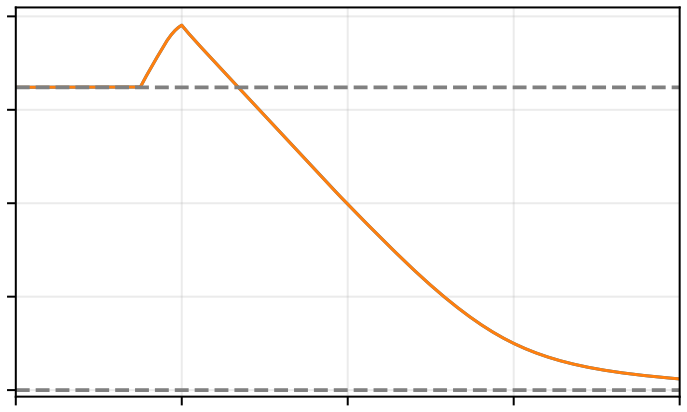
[picture p23: figure]
