leofernandesc/Open-source-sram-memory-compiler/layout/row_decoder/reports/closure_unit_tests.txt

.....................................
----------------------------------------------------------------------
Ran 37 tests in 0.267s

OK
