leofernandesc/Open-source-sram-memory-compiler/layout/row_decoder/reports/compaction/routing_provenance_tests.txt

test_local_tracks_are_finite_and_separate_on_shared_layers (test_compact_routing.CompactRoutingTests.test_local_tracks_are_finite_and_separate_on_shared_layers) ... ok
test_nine_public_pins_preserve_logical_interface (test_compact_routing.CompactRoutingTests.test_nine_public_pins_preserve_logical_interface) ... ok
test_shared_precharge_stack_columns_escape_to_different_nets (test_compact_routing.CompactRoutingTests.test_shared_precharge_stack_columns_escape_to_different_nets) ... ok
test_short_shared_via_islands_have_metal3_minimum_area (test_compact_routing.CompactRoutingTests.test_short_shared_via_islands_have_metal3_minimum_area) ... ok
test_changed_layout_is_rejected (test_compact_routing.ProvenanceTests.test_changed_layout_is_rejected) ... ok
test_changed_schematic_is_rejected (test_compact_routing.ProvenanceTests.test_changed_schematic_is_rejected) ... ok
test_drc_or_lvs_failure_prevents_binding (test_compact_routing.ProvenanceTests.test_drc_or_lvs_failure_prevents_binding) ... ok
test_eol_and_nonphysical_timestamp_changes_are_portable (test_compact_routing.ProvenanceTests.test_eol_and_nonphysical_timestamp_changes_are_portable) ... ok
test_lvs_only_never_qualifies_historical_pex (test_compact_routing.ProvenanceTests.test_lvs_only_never_qualifies_historical_pex) ... ok
test_replaced_pex_is_rejected (test_compact_routing.ProvenanceTests.test_replaced_pex_is_rejected) ... ok

----------------------------------------------------------------------
Ran 10 tests in 0.010s

OK
