leofernandesc/Open-source-sram-memory-compiler/sims/row_decoder/results/b5_review_tt_clock250_samples.csv

bench | candidate | corner | vdd_v | temperature_c | phase | address | sample_time_ns | output | voltage_v | expected_logic | criterion | result | xschem_returncode | xschem_structural_status | ngspice_returncode
sizing | B5_clock_diagnostic | tt | 1.8 | 27 | evaluate | 00 | 15 | DEC0 | 1.8 | 1 | 1.62 <= V <= 1.98 | PASS | 0 | PASS | 0
sizing | B5_clock_diagnostic | tt | 1.8 | 27 | evaluate | 00 | 15 | DEC1 | -7.327063e-07 | 0 | -0.18 <= V <= 0.18 | PASS | 0 | PASS | 0
sizing | B5_clock_diagnostic | tt | 1.8 | 27 | evaluate | 00 | 15 | DEC2 | 3.109817e-08 | 0 | -0.18 <= V <= 0.18 | PASS | 0 | PASS | 0
sizing | B5_clock_diagnostic | tt | 1.8 | 27 | evaluate | 00 | 15 | DEC3 | 3.12349e-08 | 0 | -0.18 <= V <= 0.18 | PASS | 0 | PASS | 0
sizing | B5_clock_diagnostic | tt | 1.8 | 27 | evaluate | 00 | 15 | WL0 | 1.8 | 1 | 1.62 <= V <= 1.98 | PASS | 0 | PASS | 0
sizing | B5_clock_diagnostic | tt | 1.8 | 27 | evaluate | 00 | 15 | WL1 | 2.914771e-07 | 0 | -0.18 <= V <= 0.18 | PASS | 0 | PASS | 0
sizing | B5_clock_diagnostic | tt | 1.8 | 27 | evaluate | 00 | 15 | WL2 | 2.914772e-07 | 0 | -0.18 <= V <= 0.18 | PASS | 0 | PASS | 0
sizing | B5_clock_diagnostic | tt | 1.8 | 27 | evaluate | 00 | 15 | WL3 | 2.914772e-07 | 0 | -0.18 <= V <= 0.18 | PASS | 0 | PASS | 0
sizing | B5_clock_diagnostic | tt | 1.8 | 27 | evaluate | 01 | 35 | DEC0 | -8.513844e-07 | 0 | -0.18 <= V <= 0.18 | PASS | 0 | PASS | 0
sizing | B5_clock_diagnostic | tt | 1.8 | 27 | evaluate | 01 | 35 | DEC1 | 1.8 | 1 | 1.62 <= V <= 1.98 | PASS | 0 | PASS | 0
sizing | B5_clock_diagnostic | tt | 1.8 | 27 | evaluate | 01 | 35 | DEC2 | 3.129161e-08 | 0 | -0.18 <= V <= 0.18 | PASS | 0 | PASS | 0
sizing | B5_clock_diagnostic | tt | 1.8 | 27 | evaluate | 01 | 35 | DEC3 | 3.109817e-08 | 0 | -0.18 <= V <= 0.18 | PASS | 0 | PASS | 0
sizing | B5_clock_diagnostic | tt | 1.8 | 27 | evaluate | 01 | 35 | WL0 | 2.914771e-07 | 0 | -0.18 <= V <= 0.18 | PASS | 0 | PASS | 0
sizing | B5_clock_diagnostic | tt | 1.8 | 27 | evaluate | 01 | 35 | WL1 | 1.8 | 1 | 1.62 <= V <= 1.98 | PASS | 0 | PASS | 0
sizing | B5_clock_diagnostic | tt | 1.8 | 27 | evaluate | 01 | 35 | WL2 | 2.914772e-07 | 0 | -0.18 <= V <= 0.18 | PASS | 0 | PASS | 0
sizing | B5_clock_diagnostic | tt | 1.8 | 27 | evaluate | 01 | 35 | WL3 | 2.914772e-07 | 0 | -0.18 <= V <= 0.18 | PASS | 0 | PASS | 0
sizing | B5_clock_diagnostic | tt | 1.8 | 27 | evaluate | 10 | 55 | DEC0 | 3.110621e-08 | 0 | -0.18 <= V <= 0.18 | PASS | 0 | PASS | 0
sizing | B5_clock_diagnostic | tt | 1.8 | 27 | evaluate | 10 | 55 | DEC1 | 3.129961e-08 | 0 | -0.18 <= V <= 0.18 | PASS | 0 | PASS | 0
sizing | B5_clock_diagnostic | tt | 1.8 | 27 | evaluate | 10 | 55 | DEC2 | 1.8 | 1 | 1.62 <= V <= 1.98 | PASS | 0 | PASS | 0
sizing | B5_clock_diagnostic | tt | 1.8 | 27 | evaluate | 10 | 55 | DEC3 | -8.417949e-07 | 0 | -0.18 <= V <= 0.18 | PASS | 0 | PASS | 0
sizing | B5_clock_diagnostic | tt | 1.8 | 27 | evaluate | 10 | 55 | WL0 | 2.914772e-07 | 0 | -0.18 <= V <= 0.18 | PASS | 0 | PASS | 0
sizing | B5_clock_diagnostic | tt | 1.8 | 27 | evaluate | 10 | 55 | WL1 | 2.914772e-07 | 0 | -0.18 <= V <= 0.18 | PASS | 0 | PASS | 0
sizing | B5_clock_diagnostic | tt | 1.8 | 27 | evaluate | 10 | 55 | WL2 | 1.8 | 1 | 1.62 <= V <= 1.98 | PASS | 0 | PASS | 0
sizing | B5_clock_diagnostic | tt | 1.8 | 27 | evaluate | 10 | 55 | WL3 | 2.914771e-07 | 0 | -0.18 <= V <= 0.18 | PASS | 0 | PASS | 0
sizing | B5_clock_diagnostic | tt | 1.8 | 27 | evaluate | 11 | 75 | DEC0 | 3.129862e-08 | 0 | -0.18 <= V <= 0.18 | PASS | 0 | PASS | 0
sizing | B5_clock_diagnostic | tt | 1.8 | 27 | evaluate | 11 | 75 | DEC1 | 3.11052e-08 | 0 | -0.18 <= V <= 0.18 | PASS | 0 | PASS | 0
sizing | B5_clock_diagnostic | tt | 1.8 | 27 | evaluate | 11 | 75 | DEC2 | -8.433072e-07 | 0 | -0.18 <= V <= 0.18 | PASS | 0 | PASS | 0
sizing | B5_clock_diagnostic | tt | 1.8 | 27 | evaluate | 11 | 75 | DEC3 | 1.8 | 1 | 1.62 <= V <= 1.98 | PASS | 0 | PASS | 0
sizing | B5_clock_diagnostic | tt | 1.8 | 27 | evaluate | 11 | 75 | WL0 | 2.914772e-07 | 0 | -0.18 <= V <= 0.18 | PASS | 0 | PASS | 0
sizing | B5_clock_diagnostic | tt | 1.8 | 27 | evaluate | 11 | 75 | WL1 | 2.914772e-07 | 0 | -0.18 <= V <= 0.18 | PASS | 0 | PASS | 0
sizing | B5_clock_diagnostic | tt | 1.8 | 27 | evaluate | 11 | 75 | WL2 | 2.914771e-07 | 0 | -0.18 <= V <= 0.18 | PASS | 0 | PASS | 0
sizing | B5_clock_diagnostic | tt | 1.8 | 27 | evaluate | 11 | 75 | WL3 | 1.8 | 1 | 1.62 <= V <= 1.98 | PASS | 0 | PASS | 0
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
sizing | B5_clock_diagnostic | tt | 1.8 | 27 | precharge | x | 65 | WL3 | 2.914772e-07 | 0 | -0.18 <= V <= 0.18 | PASS | 0 | PASS | 0
sizing | B5_clock_diagnostic | tt | 1.8 | 27 | precharge | x | 85 | DEC0 | 3.067219e-07 | 0 | -0.18 <= V <= 0.18 | PASS | 0 | PASS | 0
sizing | B5_clock_diagnostic | tt | 1.8 | 27 | precharge | x | 85 | DEC1 | 3.355159e-07 | 0 | -0.18 <= V <= 0.18 | PASS | 0 | PASS | 0
sizing | B5_clock_diagnostic | tt | 1.8 | 27 | precharge | x | 85 | DEC2 | 3.1174e-07 | 0 | -0.18 <= V <= 0.18 | PASS | 0 | PASS | 0
sizing | B5_clock_diagnostic | tt | 1.8 | 27 | precharge | x | 85 | DEC3 | 3.1174e-07 | 0 | -0.18 <= V <= 0.18 | PASS | 0 | PASS | 0
sizing | B5_clock_diagnostic | tt | 1.8 | 27 | precharge | x | 85 | WL0 | 2.914772e-07 | 0 | -0.18 <= V <= 0.18 | PASS | 0 | PASS | 0
sizing | B5_clock_diagnostic | tt | 1.8 | 27 | precharge | x | 85 | WL1 | 2.914772e-07 | 0 | -0.18 <= V <= 0.18 | PASS | 0 | PASS | 0
sizing | B5_clock_diagnostic | tt | 1.8 | 27 | precharge | x | 85 | WL2 | 2.914772e-07 | 0 | -0.18 <= V <= 0.18 | PASS | 0 | PASS | 0
sizing | B5_clock_diagnostic | tt | 1.8 | 27 | precharge | x | 85 | WL3 | 2.914772e-07 | 0 | -0.18 <= V <= 0.18 | PASS | 0 | PASS | 0
