leofernandesc/Open-source-sram-memory-compiler/sims/row_decoder/results/b5_review_tt_clock250_samples_metrics.csv

bench | candidate | corner | vdd_v | temperature_c | category | address | output | measurement | value | unit | low_limit | high_limit | result
sizing | B5_clock_diagnostic | tt | 1.8 | 27 | evaluate_window | 00 | DEC0 | win_00_dec0_min | 1.8 | V | 1.62 |  | PASS
sizing | B5_clock_diagnostic | tt | 1.8 | 27 | evaluate_window | 00 | DEC0 | win_00_dec0_max | 1.8 | V |  | 1.9800000000000002 | PASS
sizing | B5_clock_diagnostic | tt | 1.8 | 27 | evaluate_window | 00 | DEC1 | win_00_dec1_min | -7.086262e-05 | V | -0.18000000000000002 |  | PASS
sizing | B5_clock_diagnostic | tt | 1.8 | 27 | evaluate_window | 00 | DEC1 | win_00_dec1_max | 0.0007909013 | V |  | 0.18000000000000002 | PASS
sizing | B5_clock_diagnostic | tt | 1.8 | 27 | evaluate_window | 00 | DEC2 | win_00_dec2_min | -1.31037e-05 | V | -0.18000000000000002 |  | PASS
sizing | B5_clock_diagnostic | tt | 1.8 | 27 | evaluate_window | 00 | DEC2 | win_00_dec2_max | 0.0007858786 | V |  | 0.18000000000000002 | PASS
sizing | B5_clock_diagnostic | tt | 1.8 | 27 | evaluate_window | 00 | DEC3 | win_00_dec3_min | -1.321735e-05 | V | -0.18000000000000002 |  | PASS
sizing | B5_clock_diagnostic | tt | 1.8 | 27 | evaluate_window | 00 | DEC3 | win_00_dec3_max | 0.000785886 | V |  | 0.18000000000000002 | PASS
sizing | B5_clock_diagnostic | tt | 1.8 | 27 | evaluate_window | 00 | WL0 | win_00_wl0_min | 1.799652 | V | 1.62 |  | PASS
sizing | B5_clock_diagnostic | tt | 1.8 | 27 | evaluate_window | 00 | WL0 | win_00_wl0_max | 1.8 | V |  | 1.9800000000000002 | PASS
sizing | B5_clock_diagnostic | tt | 1.8 | 27 | evaluate_window | 00 | WL1 | win_00_wl1_min | -1.205696e-06 | V | -0.18000000000000002 |  | PASS
sizing | B5_clock_diagnostic | tt | 1.8 | 27 | evaluate_window | 00 | WL1 | win_00_wl1_max | 3.478671e-06 | V |  | 0.18000000000000002 | PASS
sizing | B5_clock_diagnostic | tt | 1.8 | 27 | evaluate_window | 00 | WL2 | win_00_wl2_min | -1.196516e-06 | V | -0.18000000000000002 |  | PASS
sizing | B5_clock_diagnostic | tt | 1.8 | 27 | evaluate_window | 00 | WL2 | win_00_wl2_max | 3.457378e-06 | V |  | 0.18000000000000002 | PASS
sizing | B5_clock_diagnostic | tt | 1.8 | 27 | evaluate_window | 00 | WL3 | win_00_wl3_min | -1.196532e-06 | V | -0.18000000000000002 |  | PASS
sizing | B5_clock_diagnostic | tt | 1.8 | 27 | evaluate_window | 00 | WL3 | win_00_wl3_max | 3.457408e-06 | V |  | 0.18000000000000002 | PASS
sizing | B5_clock_diagnostic | tt | 1.8 | 27 | crossing | 00 | PCLK | clk_0_rise | 1.0125e-08 | s | 9.999999e-09 | 1.0250001000000001e-08 | PASS
sizing | B5_clock_diagnostic | tt | 1.8 | 27 | crossing | 00 | DEC0 | t_00_dec0_rise10 | 1.02627e-08 | s | 1e-08 | 2.025e-08 | PASS
sizing | B5_clock_diagnostic | tt | 1.8 | 27 | crossing | 00 | DEC0 | t_00_dec0_rise50 | 1.0286e-08 | s | 1e-08 | 2.025e-08 | PASS
sizing | B5_clock_diagnostic | tt | 1.8 | 27 | crossing | 00 | DEC0 | t_00_dec0_rise90 | 1.0317e-08 | s | 1e-08 | 2.025e-08 | PASS
sizing | B5_clock_diagnostic | tt | 1.8 | 27 | evaluation_delay | 00 | DEC0 | delay_00_dec0_rise | 1.61005e-10 | s | 0 |  | PASS
sizing | B5_clock_diagnostic | tt | 1.8 | 27 | output_slew | 00 | DEC0 | slew_00_dec0_rise | 5.43936e-11 | s | 0 |  | PASS
sizing | B5_clock_diagnostic | tt | 1.8 | 27 | crossing | 00 | WL0 | t_00_wl0_rise10 | 1.03609e-08 | s | 1e-08 | 2.025e-08 | PASS
sizing | B5_clock_diagnostic | tt | 1.8 | 27 | crossing | 00 | WL0 | t_00_wl0_rise50 | 1.0467e-08 | s | 1e-08 | 2.025e-08 | PASS
sizing | B5_clock_diagnostic | tt | 1.8 | 27 | crossing | 00 | WL0 | t_00_wl0_rise90 | 1.06556e-08 | s | 1e-08 | 2.025e-08 | PASS
sizing | B5_clock_diagnostic | tt | 1.8 | 27 | evaluation_delay | 00 | WL0 | delay_00_wl0_rise | 3.42046e-10 | s | 0 |  | PASS
sizing | B5_clock_diagnostic | tt | 1.8 | 27 | output_slew | 00 | WL0 | slew_00_wl0_rise | 2.94718e-10 | s | 0 |  | PASS
sizing | B5_clock_diagnostic | tt | 1.8 | 27 | crossing | 00 | PCLK | clk_0_fall | 2.0375e-08 | s | 2.0249999e-08 | 2.0500001e-08 | PASS
sizing | B5_clock_diagnostic | tt | 1.8 | 27 | crossing | 00 | DEC0 | t_00_dec0_fall10 | 2.05385e-08 | s | 2.025e-08 | 3.0000000000000004e-08 | PASS
sizing | B5_clock_diagnostic | tt | 1.8 | 27 | crossing | 00 | DEC0 | t_00_dec0_fall50 | 2.05245e-08 | s | 2.025e-08 | 3.0000000000000004e-08 | PASS
sizing | B5_clock_diagnostic | tt | 1.8 | 27 | crossing | 00 | DEC0 | t_00_dec0_fall90 | 2.05095e-08 | s | 2.025e-08 | 3.0000000000000004e-08 | PASS
sizing | B5_clock_diagnostic | tt | 1.8 | 27 | precharge_delay | 00 | DEC0 | delay_00_dec0_fall | 1.63536e-10 | s | 0 |  | PASS
sizing | B5_clock_diagnostic | tt | 1.8 | 27 | output_slew | 00 | DEC0 | slew_00_dec0_fall | 2.90606e-11 | s | 0 |  | PASS
sizing | B5_clock_diagnostic | tt | 1.8 | 27 | crossing | 00 | WL0 | t_00_wl0_fall10 | 2.07141e-08 | s | 2.025e-08 | 3.0000000000000004e-08 | PASS
sizing | B5_clock_diagnostic | tt | 1.8 | 27 | crossing | 00 | WL0 | t_00_wl0_fall50 | 2.06575e-08 | s | 2.025e-08 | 3.0000000000000004e-08 | PASS
sizing | B5_clock_diagnostic | tt | 1.8 | 27 | crossing | 00 | WL0 | t_00_wl0_fall90 | 2.06073e-08 | s | 2.025e-08 | 3.0000000000000004e-08 | PASS
sizing | B5_clock_diagnostic | tt | 1.8 | 27 | precharge_delay | 00 | WL0 | delay_00_wl0_fall | 3.39097e-10 | s | 0 |  | PASS
sizing | B5_clock_diagnostic | tt | 1.8 | 27 | output_slew | 00 | WL0 | slew_00_wl0_fall | 1.06846e-10 | s | 0 |  | PASS
sizing | B5_clock_diagnostic | tt | 1.8 | 27 | dynamic_node_sample | 00 | N0 | internal_00_n0 | 1.364951e-06 | V |  |  | MEASURED
sizing | B5_clock_diagnostic | tt | 1.8 | 27 | output_nmos_vgs_upper | 00 | M10 | vgs_peak_00_m10 | 1.872144 | V |  | 1.95 | PASS
sizing | B5_clock_diagnostic | tt | 1.8 | 27 | dynamic_node_sample | 00 | N1 | internal_00_n1 | 1.891633 | V |  |  | MEASURED
sizing | B5_clock_diagnostic | tt | 1.8 | 27 | output_nmos_vgs_upper | 00 | M15 | vgs_peak_00_m15 | 1.897131 | V |  | 1.95 | PASS
sizing | B5_clock_diagnostic | tt | 1.8 | 27 | dynamic_node_min | 00 | N1 | internal_min_00_n1 | 1.79998 | V |  |  | MEASURED
sizing | B5_clock_diagnostic | tt | 1.8 | 27 | dynamic_node_sample | 00 | N2 | internal_00_n2 | 1.89764 | V |  |  | MEASURED
sizing | B5_clock_diagnostic | tt | 1.8 | 27 | output_nmos_vgs_upper | 00 | M20 | vgs_peak_00_m20 | 1.897719 | V |  | 1.95 | PASS
sizing | B5_clock_diagnostic | tt | 1.8 | 27 | dynamic_node_min | 00 | N2 | internal_min_00_n2 | 1.8 | V |  |  | MEASURED
sizing | B5_clock_diagnostic | tt | 1.8 | 27 | dynamic_node_sample | 00 | N3 | internal_00_n3 | 1.89754 | V |  |  | MEASURED
sizing | B5_clock_diagnostic | tt | 1.8 | 27 | output_nmos_vgs_upper | 00 | M25 | vgs_peak_00_m25 | 1.89764 | V |  | 1.95 | PASS
sizing | B5_clock_diagnostic | tt | 1.8 | 27 | dynamic_node_min | 00 | N3 | internal_min_00_n3 | 1.8 | V |  |  | MEASURED
sizing | B5_clock_diagnostic | tt | 1.8 | 27 | footer_voltage | 00 | EVAL_GND | footer_00 | 7.419171e-07 | V |  |  | MEASURED
sizing | B5_clock_diagnostic | tt | 1.8 | 27 | supply_charge | 00 |  | charge_00_evaluate | -5.15918e-14 | C |  |  | MEASURED
sizing | B5_clock_diagnostic | tt | 1.8 | 27 | supply_energy | 00 |  | energy_00_evaluate | 9.28652e-14 | J |  |  | MEASURED
sizing | B5_clock_diagnostic | tt | 1.8 | 27 | supply_charge | 00 |  | charge_00_precharge | -1.26073e-14 | C |  |  | MEASURED
sizing | B5_clock_diagnostic | tt | 1.8 | 27 | supply_energy | 00 |  | energy_00_precharge | 2.26932e-14 | J |  |  | MEASURED
sizing | B5_clock_diagnostic | tt | 1.8 | 27 | settled_supply_current | 00 |  | supply_00 | -1.798735e-09 | A |  |  | MEASURED
sizing | B5_clock_diagnostic | tt | 1.8 | 27 | evaluate_window | 01 | DEC0 | win_01_dec0_min | -7.112833e-05 | V | -0.18000000000000002 |  | PASS
sizing | B5_clock_diagnostic | tt | 1.8 | 27 | evaluate_window | 01 | DEC0 | win_01_dec0_max | 0.0007908815 | V |  | 0.18000000000000002 | PASS
sizing | B5_clock_diagnostic | tt | 1.8 | 27 | evaluate_window | 01 | DEC1 | win_01_dec1_min | 1.8 | V | 1.62 |  | PASS
sizing | B5_clock_diagnostic | tt | 1.8 | 27 | evaluate_window | 01 | DEC1 | win_01_dec1_max | 1.8 | V |  | 1.9800000000000002 | PASS
sizing | B5_clock_diagnostic | tt | 1.8 | 27 | evaluate_window | 01 | DEC2 | win_01_dec2_min | -1.110852e-05 | V | -0.18000000000000002 |  | PASS
sizing | B5_clock_diagnostic | tt | 1.8 | 27 | evaluate_window | 01 | DEC2 | win_01_dec2_max | 0.0007858786 | V |  | 0.18000000000000002 | PASS
sizing | B5_clock_diagnostic | tt | 1.8 | 27 | evaluate_window | 01 | DEC3 | win_01_dec3_min | -1.100306e-05 | V | -0.18000000000000002 |  | PASS
sizing | B5_clock_diagnostic | tt | 1.8 | 27 | evaluate_window | 01 | DEC3 | win_01_dec3_max | 0.0007858791 | V |  | 0.18000000000000002 | PASS
sizing | B5_clock_diagnostic | tt | 1.8 | 27 | evaluate_window | 01 | WL0 | win_01_wl0_min | -1.20572e-06 | V | -0.18000000000000002 |  | PASS
sizing | B5_clock_diagnostic | tt | 1.8 | 27 | evaluate_window | 01 | WL0 | win_01_wl0_max | 3.478563e-06 | V |  | 0.18000000000000002 | PASS
sizing | B5_clock_diagnostic | tt | 1.8 | 27 | evaluate_window | 01 | WL1 | win_01_wl1_min | 1.799659 | V | 1.62 |  | PASS
sizing | B5_clock_diagnostic | tt | 1.8 | 27 | evaluate_window | 01 | WL1 | win_01_wl1_max | 1.8 | V |  | 1.9800000000000002 | PASS
sizing | B5_clock_diagnostic | tt | 1.8 | 27 | evaluate_window | 01 | WL2 | win_01_wl2_min | -1.196516e-06 | V | -0.18000000000000002 |  | PASS
sizing | B5_clock_diagnostic | tt | 1.8 | 27 | evaluate_window | 01 | WL2 | win_01_wl2_max | 3.457378e-06 | V |  | 0.18000000000000002 | PASS
sizing | B5_clock_diagnostic | tt | 1.8 | 27 | evaluate_window | 01 | WL3 | win_01_wl3_min | -1.196517e-06 | V | -0.18000000000000002 |  | PASS
sizing | B5_clock_diagnostic | tt | 1.8 | 27 | evaluate_window | 01 | WL3 | win_01_wl3_max | 3.45738e-06 | V |  | 0.18000000000000002 | PASS
sizing | B5_clock_diagnostic | tt | 1.8 | 27 | crossing | 01 | PCLK | clk_1_rise | 3.0125e-08 | s | 2.999999900000001e-08 | 3.0250001e-08 | PASS
sizing | B5_clock_diagnostic | tt | 1.8 | 27 | crossing | 01 | DEC1 | t_01_dec1_rise10 | 3.02621e-08 | s | 3.0000000000000004e-08 | 4.0250000000000006e-08 | PASS
sizing | B5_clock_diagnostic | tt | 1.8 | 27 | crossing | 01 | DEC1 | t_01_dec1_rise50 | 3.02852e-08 | s | 3.0000000000000004e-08 | 4.0250000000000006e-08 | PASS
sizing | B5_clock_diagnostic | tt | 1.8 | 27 | crossing | 01 | DEC1 | t_01_dec1_rise90 | 3.03165e-08 | s | 3.0000000000000004e-08 | 4.0250000000000006e-08 | PASS
sizing | B5_clock_diagnostic | tt | 1.8 | 27 | evaluation_delay | 01 | DEC1 | delay_01_dec1_rise | 1.60213e-10 | s | 0 |  | PASS
sizing | B5_clock_diagnostic | tt | 1.8 | 27 | output_slew | 01 | DEC1 | slew_01_dec1_rise | 5.44887e-11 | s | 0 |  | PASS
sizing | B5_clock_diagnostic | tt | 1.8 | 27 | crossing | 01 | WL1 | t_01_wl1_rise10 | 3.03601e-08 | s | 3.0000000000000004e-08 | 4.0250000000000006e-08 | PASS
sizing | B5_clock_diagnostic | tt | 1.8 | 27 | crossing | 01 | WL1 | t_01_wl1_rise50 | 3.04662e-08 | s | 3.0000000000000004e-08 | 4.0250000000000006e-08 | PASS
sizing | B5_clock_diagnostic | tt | 1.8 | 27 | crossing | 01 | WL1 | t_01_wl1_rise90 | 3.06548e-08 | s | 3.0000000000000004e-08 | 4.0250000000000006e-08 | PASS
sizing | B5_clock_diagnostic | tt | 1.8 | 27 | evaluation_delay | 01 | WL1 | delay_01_wl1_rise | 3.41242e-10 | s | 0 |  | PASS
sizing | B5_clock_diagnostic | tt | 1.8 | 27 | output_slew | 01 | WL1 | slew_01_wl1_rise | 2.94669e-10 | s | 0 |  | PASS
sizing | B5_clock_diagnostic | tt | 1.8 | 27 | crossing | 01 | PCLK | clk_1_fall | 4.0375e-08 | s | 4.024999900000001e-08 | 4.0500001e-08 | PASS
sizing | B5_clock_diagnostic | tt | 1.8 | 27 | crossing | 01 | DEC1 | t_01_dec1_fall10 | 4.05391e-08 | s | 4.0250000000000006e-08 | 5.0000000000000004e-08 | PASS
sizing | B5_clock_diagnostic | tt | 1.8 | 27 | crossing | 01 | DEC1 | t_01_dec1_fall50 | 4.05251e-08 | s | 4.0250000000000006e-08 | 5.0000000000000004e-08 | PASS
sizing | B5_clock_diagnostic | tt | 1.8 | 27 | crossing | 01 | DEC1 | t_01_dec1_fall90 | 4.05102e-08 | s | 4.0250000000000006e-08 | 5.0000000000000004e-08 | PASS
sizing | B5_clock_diagnostic | tt | 1.8 | 27 | precharge_delay | 01 | DEC1 | delay_01_dec1_fall | 1.64147e-10 | s | 0 |  | PASS
sizing | B5_clock_diagnostic | tt | 1.8 | 27 | output_slew | 01 | DEC1 | slew_01_dec1_fall | 2.89935e-11 | s | 0 |  | PASS
sizing | B5_clock_diagnostic | tt | 1.8 | 27 | crossing | 01 | WL1 | t_01_wl1_fall10 | 4.0715e-08 | s | 4.0250000000000006e-08 | 5.0000000000000004e-08 | PASS
sizing | B5_clock_diagnostic | tt | 1.8 | 27 | crossing | 01 | WL1 | t_01_wl1_fall50 | 4.06584e-08 | s | 4.0250000000000006e-08 | 5.0000000000000004e-08 | PASS
sizing | B5_clock_diagnostic | tt | 1.8 | 27 | crossing | 01 | WL1 | t_01_wl1_fall90 | 4.06083e-08 | s | 4.0250000000000006e-08 | 5.0000000000000004e-08 | PASS
sizing | B5_clock_diagnostic | tt | 1.8 | 27 | precharge_delay | 01 | WL1 | delay_01_wl1_fall | 3.40034e-10 | s | 0 |  | PASS
sizing | B5_clock_diagnostic | tt | 1.8 | 27 | output_slew | 01 | WL1 | slew_01_wl1_fall | 1.06756e-10 | s | 0 |  | PASS
sizing | B5_clock_diagnostic | tt | 1.8 | 27 | dynamic_node_sample | 01 | N0 | internal_01_n0 | 1.890416 | V |  |  | MEASURED
sizing | B5_clock_diagnostic | tt | 1.8 | 27 | output_nmos_vgs_upper | 01 | M10 | vgs_peak_01_m10 | 1.897028 | V |  | 1.95 | PASS
sizing | B5_clock_diagnostic | tt | 1.8 | 27 | dynamic_node_min | 01 | N0 | internal_min_01_n0 | 1.799974 | V |  |  | MEASURED
sizing | B5_clock_diagnostic | tt | 1.8 | 27 | dynamic_node_sample | 01 | N1 | internal_01_n1 | 1.364709e-06 | V |  |  | MEASURED
sizing | B5_clock_diagnostic | tt | 1.8 | 27 | output_nmos_vgs_upper | 01 | M15 | vgs_peak_01_m15 | 1.869871 | V |  | 1.95 | PASS
sizing | B5_clock_diagnostic | tt | 1.8 | 27 | dynamic_node_sample | 01 | N2 | internal_01_n2 | 1.89754 | V |  |  | MEASURED
sizing | B5_clock_diagnostic | tt | 1.8 | 27 | output_nmos_vgs_upper | 01 | M20 | vgs_peak_01_m20 | 1.897639 | V |  | 1.95 | PASS
sizing | B5_clock_diagnostic | tt | 1.8 | 27 | dynamic_node_min | 01 | N2 | internal_min_01_n2 | 1.8 | V |  |  | MEASURED
sizing | B5_clock_diagnostic | tt | 1.8 | 27 | dynamic_node_sample | 01 | N3 | internal_01_n3 | 1.89764 | V |  |  | MEASURED
sizing | B5_clock_diagnostic | tt | 1.8 | 27 | output_nmos_vgs_upper | 01 | M25 | vgs_peak_01_m25 | 1.897719 | V |  | 1.95 | PASS
sizing | B5_clock_diagnostic | tt | 1.8 | 27 | dynamic_node_min | 01 | N3 | internal_min_01_n3 | 1.8 | V |  |  | MEASURED
sizing | B5_clock_diagnostic | tt | 1.8 | 27 | footer_voltage | 01 | EVAL_GND | footer_01 | 7.418276e-07 | V |  |  | MEASURED
sizing | B5_clock_diagnostic | tt | 1.8 | 27 | supply_charge | 01 |  | charge_01_evaluate | -5.0065e-14 | C |  |  | MEASURED
sizing | B5_clock_diagnostic | tt | 1.8 | 27 | supply_energy | 01 |  | energy_01_evaluate | 9.0117e-14 | J |  |  | MEASURED
sizing | B5_clock_diagnostic | tt | 1.8 | 27 | supply_charge | 01 |  | charge_01_precharge | -1.89861e-14 | C |  |  | MEASURED
sizing | B5_clock_diagnostic | tt | 1.8 | 27 | supply_energy | 01 |  | energy_01_precharge | 3.41749e-14 | J |  |  | MEASURED
sizing | B5_clock_diagnostic | tt | 1.8 | 27 | settled_supply_current | 01 |  | supply_01 | -2.217502e-09 | A |  |  | MEASURED
sizing | B5_clock_diagnostic | tt | 1.8 | 27 | evaluate_window | 10 | DEC0 | win_10_dec0_min | -1.431885e-05 | V | -0.18000000000000002 |  | PASS
sizing | B5_clock_diagnostic | tt | 1.8 | 27 | evaluate_window | 10 | DEC0 | win_10_dec0_max | 0.000787436 | V |  | 0.18000000000000002 | PASS
sizing | B5_clock_diagnostic | tt | 1.8 | 27 | evaluate_window | 10 | DEC1 | win_10_dec1_min | -1.441891e-05 | V | -0.18000000000000002 |  | PASS
sizing | B5_clock_diagnostic | tt | 1.8 | 27 | evaluate_window | 10 | DEC1 | win_10_dec1_max | 0.0007874364 | V |  | 0.18000000000000002 | PASS
sizing | B5_clock_diagnostic | tt | 1.8 | 27 | evaluate_window | 10 | DEC2 | win_10_dec2_min | 1.8 | V | 1.62 |  | PASS
sizing | B5_clock_diagnostic | tt | 1.8 | 27 | evaluate_window | 10 | DEC2 | win_10_dec2_max | 1.8 | V |  | 1.9800000000000002 | PASS
sizing | B5_clock_diagnostic | tt | 1.8 | 27 | evaluate_window | 10 | DEC3 | win_10_dec3_min | -1.478528e-05 | V | -0.18000000000000002 |  | PASS
sizing | B5_clock_diagnostic | tt | 1.8 | 27 | evaluate_window | 10 | DEC3 | win_10_dec3_max | 0.0007860707 | V |  | 0.18000000000000002 | PASS
sizing | B5_clock_diagnostic | tt | 1.8 | 27 | evaluate_window | 10 | WL0 | win_10_wl0_min | -1.196369e-06 | V | -0.18000000000000002 |  | PASS
sizing | B5_clock_diagnostic | tt | 1.8 | 27 | evaluate_window | 10 | WL0 | win_10_wl0_max | 3.464598e-06 | V |  | 0.18000000000000002 | PASS
sizing | B5_clock_diagnostic | tt | 1.8 | 27 | evaluate_window | 10 | WL1 | win_10_wl1_min | -1.19637e-06 | V | -0.18000000000000002 |  | PASS
sizing | B5_clock_diagnostic | tt | 1.8 | 27 | evaluate_window | 10 | WL1 | win_10_wl1_max | 3.4646e-06 | V |  | 0.18000000000000002 | PASS
sizing | B5_clock_diagnostic | tt | 1.8 | 27 | evaluate_window | 10 | WL2 | win_10_wl2_min | 1.799652 | V | 1.62 |  | PASS
sizing | B5_clock_diagnostic | tt | 1.8 | 27 | evaluate_window | 10 | WL2 | win_10_wl2_max | 1.8 | V |  | 1.9800000000000002 | PASS
sizing | B5_clock_diagnostic | tt | 1.8 | 27 | evaluate_window | 10 | WL3 | win_10_wl3_min | -1.197125e-06 | V | -0.18000000000000002 |  | PASS
sizing | B5_clock_diagnostic | tt | 1.8 | 27 | evaluate_window | 10 | WL3 | win_10_wl3_max | 3.458108e-06 | V |  | 0.18000000000000002 | PASS
sizing | B5_clock_diagnostic | tt | 1.8 | 27 | crossing | 10 | PCLK | clk_2_rise | 5.0125e-08 | s | 4.999999900000001e-08 | 5.0250001e-08 | PASS
sizing | B5_clock_diagnostic | tt | 1.8 | 27 | crossing | 10 | DEC2 | t_10_dec2_rise10 | 5.02629e-08 | s | 5.0000000000000004e-08 | 6.025e-08 | PASS
sizing | B5_clock_diagnostic | tt | 1.8 | 27 | crossing | 10 | DEC2 | t_10_dec2_rise50 | 5.02864e-08 | s | 5.0000000000000004e-08 | 6.025e-08 | PASS
sizing | B5_clock_diagnostic | tt | 1.8 | 27 | crossing | 10 | DEC2 | t_10_dec2_rise90 | 5.03176e-08 | s | 5.0000000000000004e-08 | 6.025e-08 | PASS
sizing | B5_clock_diagnostic | tt | 1.8 | 27 | evaluation_delay | 10 | DEC2 | delay_10_dec2_rise | 1.61437e-10 | s | 0 |  | PASS
sizing | B5_clock_diagnostic | tt | 1.8 | 27 | output_slew | 10 | DEC2 | slew_10_dec2_rise | 5.47069e-11 | s | 0 |  | PASS
sizing | B5_clock_diagnostic | tt | 1.8 | 27 | crossing | 10 | WL2 | t_10_wl2_rise10 | 5.03614e-08 | s | 5.0000000000000004e-08 | 6.025e-08 | PASS
sizing | B5_clock_diagnostic | tt | 1.8 | 27 | crossing | 10 | WL2 | t_10_wl2_rise50 | 5.04675e-08 | s | 5.0000000000000004e-08 | 6.025e-08 | PASS
sizing | B5_clock_diagnostic | tt | 1.8 | 27 | crossing | 10 | WL2 | t_10_wl2_rise90 | 5.06561e-08 | s | 5.0000000000000004e-08 | 6.025e-08 | PASS
sizing | B5_clock_diagnostic | tt | 1.8 | 27 | evaluation_delay | 10 | WL2 | delay_10_wl2_rise | 3.42511e-10 | s | 0 |  | PASS
sizing | B5_clock_diagnostic | tt | 1.8 | 27 | output_slew | 10 | WL2 | slew_10_wl2_rise | 2.94721e-10 | s | 0 |  | PASS
sizing | B5_clock_diagnostic | tt | 1.8 | 27 | crossing | 10 | PCLK | clk_2_fall | 6.0375e-08 | s | 6.0249999e-08 | 6.050000100000001e-08 | PASS
sizing | B5_clock_diagnostic | tt | 1.8 | 27 | crossing | 10 | DEC2 | t_10_dec2_fall10 | 6.0537e-08 | s | 6.025e-08 | 7e-08 | PASS
sizing | B5_clock_diagnostic | tt | 1.8 | 27 | crossing | 10 | DEC2 | t_10_dec2_fall50 | 6.05231e-08 | s | 6.025e-08 | 7e-08 | PASS
sizing | B5_clock_diagnostic | tt | 1.8 | 27 | crossing | 10 | DEC2 | t_10_dec2_fall90 | 6.05087e-08 | s | 6.025e-08 | 7e-08 | PASS
sizing | B5_clock_diagnostic | tt | 1.8 | 27 | precharge_delay | 10 | DEC2 | delay_10_dec2_fall | 1.62029e-10 | s | 0 |  | PASS
sizing | B5_clock_diagnostic | tt | 1.8 | 27 | output_slew | 10 | DEC2 | slew_10_dec2_fall | 2.8369e-11 | s | 0 |  | PASS
sizing | B5_clock_diagnostic | tt | 1.8 | 27 | crossing | 10 | WL2 | t_10_wl2_fall10 | 6.0713e-08 | s | 6.025e-08 | 7e-08 | PASS
sizing | B5_clock_diagnostic | tt | 1.8 | 27 | crossing | 10 | WL2 | t_10_wl2_fall50 | 6.06566e-08 | s | 6.025e-08 | 7e-08 | PASS
sizing | B5_clock_diagnostic | tt | 1.8 | 27 | crossing | 10 | WL2 | t_10_wl2_fall90 | 6.06063e-08 | s | 6.025e-08 | 7e-08 | PASS
sizing | B5_clock_diagnostic | tt | 1.8 | 27 | precharge_delay | 10 | WL2 | delay_10_wl2_fall | 3.37987e-10 | s | 0 |  | PASS
sizing | B5_clock_diagnostic | tt | 1.8 | 27 | output_slew | 10 | WL2 | slew_10_wl2_fall | 1.06672e-10 | s | 0 |  | PASS
sizing | B5_clock_diagnostic | tt | 1.8 | 27 | dynamic_node_sample | 10 | N0 | internal_10_n0 | 1.897634 | V |  |  | MEASURED
sizing | B5_clock_diagnostic | tt | 1.8 | 27 | output_nmos_vgs_upper | 10 | M10 | vgs_peak_10_m10 | 1.897712 | V |  | 1.95 | PASS
sizing | B5_clock_diagnostic | tt | 1.8 | 27 | dynamic_node_min | 10 | N0 | internal_min_10_n0 | 1.8 | V |  |  | MEASURED
sizing | B5_clock_diagnostic | tt | 1.8 | 27 | dynamic_node_sample | 10 | N1 | internal_10_n1 | 1.897534 | V |  |  | MEASURED
sizing | B5_clock_diagnostic | tt | 1.8 | 27 | output_nmos_vgs_upper | 10 | M15 | vgs_peak_10_m15 | 1.897612 | V |  | 1.95 | PASS
sizing | B5_clock_diagnostic | tt | 1.8 | 27 | dynamic_node_min | 10 | N1 | internal_min_10_n1 | 1.8 | V |  |  | MEASURED
sizing | B5_clock_diagnostic | tt | 1.8 | 27 | dynamic_node_sample | 10 | N2 | internal_10_n2 | 1.366275e-06 | V |  |  | MEASURED
sizing | B5_clock_diagnostic | tt | 1.8 | 27 | output_nmos_vgs_upper | 10 | M20 | vgs_peak_10_m20 | 1.875527 | V |  | 1.95 | PASS
sizing | B5_clock_diagnostic | tt | 1.8 | 27 | dynamic_node_sample | 10 | N3 | internal_10_n3 | 1.890336 | V |  |  | MEASURED
sizing | B5_clock_diagnostic | tt | 1.8 | 27 | output_nmos_vgs_upper | 10 | M25 | vgs_peak_10_m25 | 1.897385 | V |  | 1.95 | PASS
sizing | B5_clock_diagnostic | tt | 1.8 | 27 | dynamic_node_min | 10 | N3 | internal_min_10_n3 | 1.799974 | V |  |  | MEASURED
sizing | B5_clock_diagnostic | tt | 1.8 | 27 | footer_voltage | 10 | EVAL_GND | footer_10 | 7.427958e-07 | V |  |  | MEASURED
sizing | B5_clock_diagnostic | tt | 1.8 | 27 | supply_charge | 10 |  | charge_10_evaluate | -5.09336e-14 | C |  |  | MEASURED
sizing | B5_clock_diagnostic | tt | 1.8 | 27 | supply_energy | 10 |  | energy_10_evaluate | 9.16805e-14 | J |  |  | MEASURED
sizing | B5_clock_diagnostic | tt | 1.8 | 27 | supply_charge | 10 |  | charge_10_precharge | -1.259e-14 | C |  |  | MEASURED
sizing | B5_clock_diagnostic | tt | 1.8 | 27 | supply_energy | 10 |  | energy_10_precharge | 2.26619e-14 | J |  |  | MEASURED
sizing | B5_clock_diagnostic | tt | 1.8 | 27 | settled_supply_current | 10 |  | supply_10 | -2.864538e-09 | A |  |  | MEASURED
sizing | B5_clock_diagnostic | tt | 1.8 | 27 | evaluate_window | 11 | DEC0 | win_11_dec0_min | -1.434839e-05 | V | -0.18000000000000002 |  | PASS
sizing | B5_clock_diagnostic | tt | 1.8 | 27 | evaluate_window | 11 | DEC0 | win_11_dec0_max | 0.0007874291 | V |  | 0.18000000000000002 | PASS
sizing | B5_clock_diagnostic | tt | 1.8 | 27 | evaluate_window | 11 | DEC1 | win_11_dec1_min | -1.423661e-05 | V | -0.18000000000000002 |  | PASS
sizing | B5_clock_diagnostic | tt | 1.8 | 27 | evaluate_window | 11 | DEC1 | win_11_dec1_max | 0.0007874296 | V |  | 0.18000000000000002 | PASS
sizing | B5_clock_diagnostic | tt | 1.8 | 27 | evaluate_window | 11 | DEC2 | win_11_dec2_min | -1.472108e-05 | V | -0.18000000000000002 |  | PASS
sizing | B5_clock_diagnostic | tt | 1.8 | 27 | evaluate_window | 11 | DEC2 | win_11_dec2_max | 0.0007860559 | V |  | 0.18000000000000002 | PASS
sizing | B5_clock_diagnostic | tt | 1.8 | 27 | evaluate_window | 11 | DEC3 | win_11_dec3_min | 1.8 | V | 1.62 |  | PASS
sizing | B5_clock_diagnostic | tt | 1.8 | 27 | evaluate_window | 11 | DEC3 | win_11_dec3_max | 1.8 | V |  | 1.9800000000000002 | PASS
sizing | B5_clock_diagnostic | tt | 1.8 | 27 | evaluate_window | 11 | WL0 | win_11_wl0_min | -1.196371e-06 | V | -0.18000000000000002 |  | PASS
sizing | B5_clock_diagnostic | tt | 1.8 | 27 | evaluate_window | 11 | WL0 | win_11_wl0_max | 3.464565e-06 | V |  | 0.18000000000000002 | PASS
sizing | B5_clock_diagnostic | tt | 1.8 | 27 | evaluate_window | 11 | WL1 | win_11_wl1_min | -1.196372e-06 | V | -0.18000000000000002 |  | PASS
sizing | B5_clock_diagnostic | tt | 1.8 | 27 | evaluate_window | 11 | WL1 | win_11_wl1_max | 3.464567e-06 | V |  | 0.18000000000000002 | PASS
sizing | B5_clock_diagnostic | tt | 1.8 | 27 | evaluate_window | 11 | WL2 | win_11_wl2_min | -1.197111e-06 | V | -0.18000000000000002 |  | PASS
sizing | B5_clock_diagnostic | tt | 1.8 | 27 | evaluate_window | 11 | WL2 | win_11_wl2_max | 3.458041e-06 | V |  | 0.18000000000000002 | PASS
sizing | B5_clock_diagnostic | tt | 1.8 | 27 | evaluate_window | 11 | WL3 | win_11_wl3_min | 1.799656 | V | 1.62 |  | PASS
sizing | B5_clock_diagnostic | tt | 1.8 | 27 | evaluate_window | 11 | WL3 | win_11_wl3_max | 1.8 | V |  | 1.9800000000000002 | PASS
sizing | B5_clock_diagnostic | tt | 1.8 | 27 | crossing | 11 | PCLK | clk_3_rise | 7.0125e-08 | s | 6.9999999e-08 | 7.025000100000001e-08 | PASS
sizing | B5_clock_diagnostic | tt | 1.8 | 27 | crossing | 11 | DEC3 | t_11_dec3_rise10 | 7.02609e-08 | s | 7e-08 | 8.025000000000001e-08 | PASS
sizing | B5_clock_diagnostic | tt | 1.8 | 27 | crossing | 11 | DEC3 | t_11_dec3_rise50 | 7.02845e-08 | s | 7e-08 | 8.025000000000001e-08 | PASS
sizing | B5_clock_diagnostic | tt | 1.8 | 27 | crossing | 11 | DEC3 | t_11_dec3_rise90 | 7.03154e-08 | s | 7e-08 | 8.025000000000001e-08 | PASS
sizing | B5_clock_diagnostic | tt | 1.8 | 27 | evaluation_delay | 11 | DEC3 | delay_11_dec3_rise | 1.59477e-10 | s | 0 |  | PASS
sizing | B5_clock_diagnostic | tt | 1.8 | 27 | output_slew | 11 | DEC3 | slew_11_dec3_rise | 5.45139e-11 | s | 0 |  | PASS
sizing | B5_clock_diagnostic | tt | 1.8 | 27 | crossing | 11 | WL3 | t_11_wl3_rise10 | 7.03594e-08 | s | 7e-08 | 8.025000000000001e-08 | PASS
sizing | B5_clock_diagnostic | tt | 1.8 | 27 | crossing | 11 | WL3 | t_11_wl3_rise50 | 7.04656e-08 | s | 7e-08 | 8.025000000000001e-08 | PASS
sizing | B5_clock_diagnostic | tt | 1.8 | 27 | crossing | 11 | WL3 | t_11_wl3_rise90 | 7.06541e-08 | s | 7e-08 | 8.025000000000001e-08 | PASS
sizing | B5_clock_diagnostic | tt | 1.8 | 27 | evaluation_delay | 11 | WL3 | delay_11_wl3_rise | 3.40572e-10 | s | 0 |  | PASS
sizing | B5_clock_diagnostic | tt | 1.8 | 27 | output_slew | 11 | WL3 | slew_11_wl3_rise | 2.94686e-10 | s | 0 |  | PASS
sizing | B5_clock_diagnostic | tt | 1.8 | 27 | crossing | 11 | PCLK | clk_3_fall | 8.0375e-08 | s | 8.0249999e-08 | 8.050000100000002e-08 | PASS
sizing | B5_clock_diagnostic | tt | 1.8 | 27 | crossing | 11 | DEC3 | t_11_dec3_fall10 | 8.05378e-08 | s | 8.025000000000001e-08 | 9.000000000000001e-08 | PASS
sizing | B5_clock_diagnostic | tt | 1.8 | 27 | crossing | 11 | DEC3 | t_11_dec3_fall50 | 8.0524e-08 | s | 8.025000000000001e-08 | 9.000000000000001e-08 | PASS
sizing | B5_clock_diagnostic | tt | 1.8 | 27 | crossing | 11 | DEC3 | t_11_dec3_fall90 | 8.05094e-08 | s | 8.025000000000001e-08 | 9.000000000000001e-08 | PASS
sizing | B5_clock_diagnostic | tt | 1.8 | 27 | precharge_delay | 11 | DEC3 | delay_11_dec3_fall | 1.62796e-10 | s | 0 |  | PASS
sizing | B5_clock_diagnostic | tt | 1.8 | 27 | output_slew | 11 | DEC3 | slew_11_dec3_fall | 2.83828e-11 | s | 0 |  | PASS
sizing | B5_clock_diagnostic | tt | 1.8 | 27 | crossing | 11 | WL3 | t_11_wl3_fall10 | 8.07136e-08 | s | 8.025000000000001e-08 | 9.000000000000001e-08 | PASS
sizing | B5_clock_diagnostic | tt | 1.8 | 27 | crossing | 11 | WL3 | t_11_wl3_fall50 | 8.0657e-08 | s | 8.025000000000001e-08 | 9.000000000000001e-08 | PASS
sizing | B5_clock_diagnostic | tt | 1.8 | 27 | crossing | 11 | WL3 | t_11_wl3_fall90 | 8.06067e-08 | s | 8.025000000000001e-08 | 9.000000000000001e-08 | PASS
sizing | B5_clock_diagnostic | tt | 1.8 | 27 | precharge_delay | 11 | WL3 | delay_11_wl3_fall | 3.38598e-10 | s | 0 |  | PASS
sizing | B5_clock_diagnostic | tt | 1.8 | 27 | output_slew | 11 | WL3 | slew_11_wl3_fall | 1.06855e-10 | s | 0 |  | PASS
sizing | B5_clock_diagnostic | tt | 1.8 | 27 | dynamic_node_sample | 11 | N0 | internal_11_n0 | 1.897534 | V |  |  | MEASURED
sizing | B5_clock_diagnostic | tt | 1.8 | 27 | output_nmos_vgs_upper | 11 | M10 | vgs_peak_11_m10 | 1.897613 | V |  | 1.95 | PASS
sizing | B5_clock_diagnostic | tt | 1.8 | 27 | dynamic_node_min | 11 | N0 | internal_min_11_n0 | 1.800837 | V |  |  | MEASURED
sizing | B5_clock_diagnostic | tt | 1.8 | 27 | dynamic_node_sample | 11 | N1 | internal_11_n1 | 1.897635 | V |  |  | MEASURED
sizing | B5_clock_diagnostic | tt | 1.8 | 27 | output_nmos_vgs_upper | 11 | M15 | vgs_peak_11_m15 | 1.897713 | V |  | 1.95 | PASS
sizing | B5_clock_diagnostic | tt | 1.8 | 27 | dynamic_node_min | 11 | N1 | internal_min_11_n1 | 1.800837 | V |  |  | MEASURED
sizing | B5_clock_diagnostic | tt | 1.8 | 27 | dynamic_node_sample | 11 | N2 | internal_11_n2 | 1.89031 | V |  |  | MEASURED
sizing | B5_clock_diagnostic | tt | 1.8 | 27 | output_nmos_vgs_upper | 11 | M20 | vgs_peak_11_m20 | 1.897382 | V |  | 1.95 | PASS
sizing | B5_clock_diagnostic | tt | 1.8 | 27 | dynamic_node_min | 11 | N2 | internal_min_11_n2 | 1.800804 | V |  |  | MEASURED
sizing | B5_clock_diagnostic | tt | 1.8 | 27 | dynamic_node_sample | 11 | N3 | internal_11_n3 | 1.366255e-06 | V |  |  | MEASURED
sizing | B5_clock_diagnostic | tt | 1.8 | 27 | output_nmos_vgs_upper | 11 | M25 | vgs_peak_11_m25 | 1.871627 | V |  | 1.95 | PASS
sizing | B5_clock_diagnostic | tt | 1.8 | 27 | footer_voltage | 11 | EVAL_GND | footer_11 | 7.427757e-07 | V |  |  | MEASURED
sizing | B5_clock_diagnostic | tt | 1.8 | 27 | supply_charge | 11 |  | charge_11_evaluate | -4.93899e-14 | C |  |  | MEASURED
sizing | B5_clock_diagnostic | tt | 1.8 | 27 | supply_energy | 11 |  | energy_11_evaluate | 8.89018e-14 | J |  |  | MEASURED
sizing | B5_clock_diagnostic | tt | 1.8 | 27 | supply_charge | 11 |  | charge_11_precharge | -2.65832e-14 | C |  |  | MEASURED
sizing | B5_clock_diagnostic | tt | 1.8 | 27 | supply_energy | 11 |  | energy_11_precharge | 4.78497e-14 | J |  |  | MEASURED
sizing | B5_clock_diagnostic | tt | 1.8 | 27 | settled_supply_current | 11 |  | supply_11 | -3.184954e-09 | A |  |  | MEASURED
sizing | B5_clock_diagnostic | tt | 1.8 | 27 | precharge_window | x | DEC0 | prewin_0_dec0_min | 3.219827e-07 | V | -0.18000000000000002 |  | PASS
sizing | B5_clock_diagnostic | tt | 1.8 | 27 | precharge_window | x | DEC0 | prewin_0_dec0_max | 2.10247e-06 | V |  | 0.18000000000000002 | PASS
sizing | B5_clock_diagnostic | tt | 1.8 | 27 | precharge_window | x | DEC1 | prewin_0_dec1_min | 3.136349e-07 | V | -0.18000000000000002 |  | PASS
sizing | B5_clock_diagnostic | tt | 1.8 | 27 | precharge_window | x | DEC1 | prewin_0_dec1_max | 5.616818e-07 | V |  | 0.18000000000000002 | PASS
sizing | B5_clock_diagnostic | tt | 1.8 | 27 | precharge_window | x | DEC2 | prewin_0_dec2_min | 3.1174e-07 | V | -0.18000000000000002 |  | PASS
sizing | B5_clock_diagnostic | tt | 1.8 | 27 | precharge_window | x | DEC2 | prewin_0_dec2_max | 3.117407e-07 | V |  | 0.18000000000000002 | PASS
sizing | B5_clock_diagnostic | tt | 1.8 | 27 | precharge_window | x | DEC3 | prewin_0_dec3_min | 3.1174e-07 | V | -0.18000000000000002 |  | PASS
sizing | B5_clock_diagnostic | tt | 1.8 | 27 | precharge_window | x | DEC3 | prewin_0_dec3_max | 3.1174e-07 | V |  | 0.18000000000000002 | PASS
sizing | B5_clock_diagnostic | tt | 1.8 | 27 | precharge_window | x | WL0 | prewin_0_wl0_min | 2.914772e-07 | V | -0.18000000000000002 |  | PASS
sizing | B5_clock_diagnostic | tt | 1.8 | 27 | precharge_window | x | WL0 | prewin_0_wl0_max | 2.915505e-07 | V |  | 0.18000000000000002 | PASS
sizing | B5_clock_diagnostic | tt | 1.8 | 27 | precharge_window | x | WL1 | prewin_0_wl1_min | 2.914772e-07 | V | -0.18000000000000002 |  | PASS
sizing | B5_clock_diagnostic | tt | 1.8 | 27 | precharge_window | x | WL1 | prewin_0_wl1_max | 2.914857e-07 | V |  | 0.18000000000000002 | PASS
sizing | B5_clock_diagnostic | tt | 1.8 | 27 | precharge_window | x | WL2 | prewin_0_wl2_min | 2.914772e-07 | V | -0.18000000000000002 |  | PASS
sizing | B5_clock_diagnostic | tt | 1.8 | 27 | precharge_window | x | WL2 | prewin_0_wl2_max | 2.914772e-07 | V |  | 0.18000000000000002 | PASS
sizing | B5_clock_diagnostic | tt | 1.8 | 27 | precharge_window | x | WL3 | prewin_0_wl3_min | 2.914772e-07 | V | -0.18000000000000002 |  | PASS
sizing | B5_clock_diagnostic | tt | 1.8 | 27 | precharge_window | x | WL3 | prewin_0_wl3_max | 2.914772e-07 | V |  | 0.18000000000000002 | PASS
sizing | B5_clock_diagnostic | tt | 1.8 | 27 | internal_precharge | x | N0 | prenode_0_n0 | 1.79977 | V | 1.62 | 1.9800000000000002 | PASS
sizing | B5_clock_diagnostic | tt | 1.8 | 27 | internal_precharge | x | N1 | prenode_0_n1 | 1.799957 | V | 1.62 | 1.9800000000000002 | PASS
sizing | B5_clock_diagnostic | tt | 1.8 | 27 | internal_precharge | x | N2 | prenode_0_n2 | 1.8 | V | 1.62 | 1.9800000000000002 | PASS
sizing | B5_clock_diagnostic | tt | 1.8 | 27 | internal_precharge | x | N3 | prenode_0_n3 | 1.8 | V | 1.62 | 1.9800000000000002 | PASS
sizing | B5_clock_diagnostic | tt | 1.8 | 27 | precharge_window | x | DEC0 | prewin_1_dec0_min | -0.001218667 | V | -0.18000000000000002 |  | PASS
sizing | B5_clock_diagnostic | tt | 1.8 | 27 | precharge_window | x | DEC0 | prewin_1_dec0_max | 0.0004167622 | V |  | 0.18000000000000002 | PASS
sizing | B5_clock_diagnostic | tt | 1.8 | 27 | precharge_window | x | DEC1 | prewin_1_dec1_min | -3.212963e-05 | V | -0.18000000000000002 |  | PASS
sizing | B5_clock_diagnostic | tt | 1.8 | 27 | precharge_window | x | DEC1 | prewin_1_dec1_max | 4.980498e-05 | V |  | 0.18000000000000002 | PASS
sizing | B5_clock_diagnostic | tt | 1.8 | 27 | precharge_window | x | DEC2 | prewin_1_dec2_min | 1.008315e-07 | V | -0.18000000000000002 |  | PASS
sizing | B5_clock_diagnostic | tt | 1.8 | 27 | precharge_window | x | DEC2 | prewin_1_dec2_max | 7.450291e-07 | V |  | 0.18000000000000002 | PASS
sizing | B5_clock_diagnostic | tt | 1.8 | 27 | precharge_window | x | DEC3 | prewin_1_dec3_min | -1.832953e-06 | V | -0.18000000000000002 |  | PASS
sizing | B5_clock_diagnostic | tt | 1.8 | 27 | precharge_window | x | DEC3 | prewin_1_dec3_max | 1.356075e-06 | V |  | 0.18000000000000002 | PASS
sizing | B5_clock_diagnostic | tt | 1.8 | 27 | precharge_window | x | WL0 | prewin_1_wl0_min | -3.593777e-06 | V | -0.18000000000000002 |  | PASS
sizing | B5_clock_diagnostic | tt | 1.8 | 27 | precharge_window | x | WL0 | prewin_1_wl0_max | 4.352359e-06 | V |  | 0.18000000000000002 | PASS
sizing | B5_clock_diagnostic | tt | 1.8 | 27 | precharge_window | x | WL1 | prewin_1_wl1_min | 1.766597e-07 | V | -0.18000000000000002 |  | PASS
sizing | B5_clock_diagnostic | tt | 1.8 | 27 | precharge_window | x | WL1 | prewin_1_wl1_max | 5.257369e-07 | V |  | 0.18000000000000002 | PASS
sizing | B5_clock_diagnostic | tt | 1.8 | 27 | precharge_window | x | WL2 | prewin_1_wl2_min | 2.902983e-07 | V | -0.18000000000000002 |  | PASS
sizing | B5_clock_diagnostic | tt | 1.8 | 27 | precharge_window | x | WL2 | prewin_1_wl2_max | 2.93402e-07 | V |  | 0.18000000000000002 | PASS
sizing | B5_clock_diagnostic | tt | 1.8 | 27 | precharge_window | x | WL3 | prewin_1_wl3_min | 2.828953e-07 | V | -0.18000000000000002 |  | PASS
sizing | B5_clock_diagnostic | tt | 1.8 | 27 | precharge_window | x | WL3 | prewin_1_wl3_max | 2.971672e-07 | V |  | 0.18000000000000002 | PASS
sizing | B5_clock_diagnostic | tt | 1.8 | 27 | internal_precharge | x | N0 | prenode_1_n0 | 1.799924 | V | 1.62 | 1.9800000000000002 | PASS
sizing | B5_clock_diagnostic | tt | 1.8 | 27 | internal_precharge | x | N1 | prenode_1_n1 | 1.799613 | V | 1.62 | 1.9800000000000002 | PASS
sizing | B5_clock_diagnostic | tt | 1.8 | 27 | internal_precharge | x | N2 | prenode_1_n2 | 1.8 | V | 1.62 | 1.9800000000000002 | PASS
sizing | B5_clock_diagnostic | tt | 1.8 | 27 | internal_precharge | x | N3 | prenode_1_n3 | 1.8 | V | 1.62 | 1.9800000000000002 | PASS
sizing | B5_clock_diagnostic | tt | 1.8 | 27 | precharge_window | x | DEC0 | prewin_2_dec0_min | -0.002784198 | V | -0.18000000000000002 |  | PASS
sizing | B5_clock_diagnostic | tt | 1.8 | 27 | precharge_window | x | DEC0 | prewin_2_dec0_max | 0.001912252 | V |  | 0.18000000000000002 | PASS
sizing | B5_clock_diagnostic | tt | 1.8 | 27 | precharge_window | x | DEC1 | prewin_2_dec1_min | -0.002774565 | V | -0.18000000000000002 |  | PASS
sizing | B5_clock_diagnostic | tt | 1.8 | 27 | precharge_window | x | DEC1 | prewin_2_dec1_max | 0.001969753 | V |  | 0.18000000000000002 | PASS
sizing | B5_clock_diagnostic | tt | 1.8 | 27 | precharge_window | x | DEC2 | prewin_2_dec2_min | -0.001645132 | V | -0.18000000000000002 |  | PASS
sizing | B5_clock_diagnostic | tt | 1.8 | 27 | precharge_window | x | DEC2 | prewin_2_dec2_max | 0.001396975 | V |  | 0.18000000000000002 | PASS
sizing | B5_clock_diagnostic | tt | 1.8 | 27 | precharge_window | x | DEC3 | prewin_2_dec3_min | -0.001387286 | V | -0.18000000000000002 |  | PASS
sizing | B5_clock_diagnostic | tt | 1.8 | 27 | precharge_window | x | DEC3 | prewin_2_dec3_max | 0.001396954 | V |  | 0.18000000000000002 | PASS
sizing | B5_clock_diagnostic | tt | 1.8 | 27 | precharge_window | x | WL0 | prewin_2_wl0_min | -7.284597e-06 | V | -0.18000000000000002 |  | PASS
sizing | B5_clock_diagnostic | tt | 1.8 | 27 | precharge_window | x | WL0 | prewin_2_wl0_max | 1.504808e-05 | V |  | 0.18000000000000002 | PASS
sizing | B5_clock_diagnostic | tt | 1.8 | 27 | precharge_window | x | WL1 | prewin_2_wl1_min | -6.848456e-06 | V | -0.18000000000000002 |  | PASS
sizing | B5_clock_diagnostic | tt | 1.8 | 27 | precharge_window | x | WL1 | prewin_2_wl1_max | 1.514384e-05 | V |  | 0.18000000000000002 | PASS
sizing | B5_clock_diagnostic | tt | 1.8 | 27 | precharge_window | x | WL2 | prewin_2_wl2_min | -8.074909e-06 | V | -0.18000000000000002 |  | PASS
sizing | B5_clock_diagnostic | tt | 1.8 | 27 | precharge_window | x | WL2 | prewin_2_wl2_max | 6.203773e-06 | V |  | 0.18000000000000002 | PASS
sizing | B5_clock_diagnostic | tt | 1.8 | 27 | precharge_window | x | WL3 | prewin_2_wl3_min | -6.577433e-06 | V | -0.18000000000000002 |  | PASS
sizing | B5_clock_diagnostic | tt | 1.8 | 27 | precharge_window | x | WL3 | prewin_2_wl3_max | 6.20362e-06 | V |  | 0.18000000000000002 | PASS
sizing | B5_clock_diagnostic | tt | 1.8 | 27 | internal_precharge | x | N0 | prenode_2_n0 | 1.8 | V | 1.62 | 1.9800000000000002 | PASS
sizing | B5_clock_diagnostic | tt | 1.8 | 27 | internal_precharge | x | N1 | prenode_2_n1 | 1.8 | V | 1.62 | 1.9800000000000002 | PASS
sizing | B5_clock_diagnostic | tt | 1.8 | 27 | internal_precharge | x | N2 | prenode_2_n2 | 1.799989 | V | 1.62 | 1.9800000000000002 | PASS
sizing | B5_clock_diagnostic | tt | 1.8 | 27 | internal_precharge | x | N3 | prenode_2_n3 | 1.799925 | V | 1.62 | 1.9800000000000002 | PASS
sizing | B5_clock_diagnostic | tt | 1.8 | 27 | precharge_window | x | DEC0 | prewin_3_dec0_min | -9.908544e-06 | V | -0.18000000000000002 |  | PASS
sizing | B5_clock_diagnostic | tt | 1.8 | 27 | precharge_window | x | DEC0 | prewin_3_dec0_max | 1.224362e-05 | V |  | 0.18000000000000002 | PASS
sizing | B5_clock_diagnostic | tt | 1.8 | 27 | precharge_window | x | DEC1 | prewin_3_dec1_min | -9.691575e-06 | V | -0.18000000000000002 |  | PASS
sizing | B5_clock_diagnostic | tt | 1.8 | 27 | precharge_window | x | DEC1 | prewin_3_dec1_max | 1.211944e-05 | V |  | 0.18000000000000002 | PASS
sizing | B5_clock_diagnostic | tt | 1.8 | 27 | precharge_window | x | DEC2 | prewin_3_dec2_min | -0.001305853 | V | -0.18000000000000002 |  | PASS
sizing | B5_clock_diagnostic | tt | 1.8 | 27 | precharge_window | x | DEC2 | prewin_3_dec2_max | 0.0004542637 | V |  | 0.18000000000000002 | PASS
sizing | B5_clock_diagnostic | tt | 1.8 | 27 | precharge_window | x | DEC3 | prewin_3_dec3_min | -3.183085e-05 | V | -0.18000000000000002 |  | PASS
sizing | B5_clock_diagnostic | tt | 1.8 | 27 | precharge_window | x | DEC3 | prewin_3_dec3_max | 1.060833e-05 | V |  | 0.18000000000000002 | PASS
sizing | B5_clock_diagnostic | tt | 1.8 | 27 | precharge_window | x | WL0 | prewin_3_wl0_min | 2.564531e-07 | V | -0.18000000000000002 |  | PASS
sizing | B5_clock_diagnostic | tt | 1.8 | 27 | precharge_window | x | WL0 | prewin_3_wl0_max | 3.574275e-07 | V |  | 0.18000000000000002 | PASS
sizing | B5_clock_diagnostic | tt | 1.8 | 27 | precharge_window | x | WL1 | prewin_3_wl1_min | 2.56527e-07 | V | -0.18000000000000002 |  | PASS
sizing | B5_clock_diagnostic | tt | 1.8 | 27 | precharge_window | x | WL1 | prewin_3_wl1_max | 3.565409e-07 | V |  | 0.18000000000000002 | PASS
sizing | B5_clock_diagnostic | tt | 1.8 | 27 | precharge_window | x | WL2 | prewin_3_wl2_min | -4.006308e-06 | V | -0.18000000000000002 |  | PASS
sizing | B5_clock_diagnostic | tt | 1.8 | 27 | precharge_window | x | WL2 | prewin_3_wl2_max | 4.680465e-06 | V |  | 0.18000000000000002 | PASS
sizing | B5_clock_diagnostic | tt | 1.8 | 27 | precharge_window | x | WL3 | prewin_3_wl3_min | 1.623892e-07 | V | -0.18000000000000002 |  | PASS
sizing | B5_clock_diagnostic | tt | 1.8 | 27 | precharge_window | x | WL3 | prewin_3_wl3_max | 3.846055e-07 | V |  | 0.18000000000000002 | PASS
sizing | B5_clock_diagnostic | tt | 1.8 | 27 | internal_precharge | x | N0 | prenode_3_n0 | 1.8 | V | 1.62 | 1.9800000000000002 | PASS
sizing | B5_clock_diagnostic | tt | 1.8 | 27 | internal_precharge | x | N1 | prenode_3_n1 | 1.8 | V | 1.62 | 1.9800000000000002 | PASS
sizing | B5_clock_diagnostic | tt | 1.8 | 27 | internal_precharge | x | N2 | prenode_3_n2 | 1.799924 | V | 1.62 | 1.9800000000000002 | PASS
sizing | B5_clock_diagnostic | tt | 1.8 | 27 | internal_precharge | x | N3 | prenode_3_n3 | 1.799882 | V | 1.62 | 1.9800000000000002 | PASS
sizing | B5_clock_diagnostic | tt | 1.8 | 27 | precharge_window | x | DEC0 | prewin_4_dec0_min | -0.0008514938 | V | -0.18000000000000002 |  | PASS
sizing | B5_clock_diagnostic | tt | 1.8 | 27 | precharge_window | x | DEC0 | prewin_4_dec0_max | 0.00146893 | V |  | 0.18000000000000002 | PASS
sizing | B5_clock_diagnostic | tt | 1.8 | 27 | precharge_window | x | DEC1 | prewin_4_dec1_min | -0.0007793427 | V | -0.18000000000000002 |  | PASS
sizing | B5_clock_diagnostic | tt | 1.8 | 27 | precharge_window | x | DEC1 | prewin_4_dec1_max | 0.001469718 | V |  | 0.18000000000000002 | PASS
sizing | B5_clock_diagnostic | tt | 1.8 | 27 | precharge_window | x | DEC2 | prewin_4_dec2_min | -0.001441114 | V | -0.18000000000000002 |  | PASS
sizing | B5_clock_diagnostic | tt | 1.8 | 27 | precharge_window | x | DEC2 | prewin_4_dec2_max | 0.00134308 | V |  | 0.18000000000000002 | PASS
sizing | B5_clock_diagnostic | tt | 1.8 | 27 | precharge_window | x | DEC3 | prewin_4_dec3_min | -0.00156057 | V | -0.18000000000000002 |  | PASS
sizing | B5_clock_diagnostic | tt | 1.8 | 27 | precharge_window | x | DEC3 | prewin_4_dec3_max | 0.001356473 | V |  | 0.18000000000000002 | PASS
sizing | B5_clock_diagnostic | tt | 1.8 | 27 | precharge_window | x | WL0 | prewin_4_wl0_min | -5.616633e-06 | V | -0.18000000000000002 |  | PASS
sizing | B5_clock_diagnostic | tt | 1.8 | 27 | precharge_window | x | WL0 | prewin_4_wl0_max | 3.486283e-06 | V |  | 0.18000000000000002 | PASS
sizing | B5_clock_diagnostic | tt | 1.8 | 27 | precharge_window | x | WL1 | prewin_4_wl1_min | -5.436022e-06 | V | -0.18000000000000002 |  | PASS
sizing | B5_clock_diagnostic | tt | 1.8 | 27 | precharge_window | x | WL1 | prewin_4_wl1_max | 3.489625e-06 | V |  | 0.18000000000000002 | PASS
sizing | B5_clock_diagnostic | tt | 1.8 | 27 | precharge_window | x | WL2 | prewin_4_wl2_min | -5.984677e-06 | V | -0.18000000000000002 |  | PASS
sizing | B5_clock_diagnostic | tt | 1.8 | 27 | precharge_window | x | WL2 | prewin_4_wl2_max | 6.910294e-06 | V |  | 0.18000000000000002 | PASS
sizing | B5_clock_diagnostic | tt | 1.8 | 27 | precharge_window | x | WL3 | prewin_4_wl3_min | -6.513794e-06 | V | -0.18000000000000002 |  | PASS
sizing | B5_clock_diagnostic | tt | 1.8 | 27 | precharge_window | x | WL3 | prewin_4_wl3_max | 6.799594e-06 | V |  | 0.18000000000000002 | PASS
sizing | B5_clock_diagnostic | tt | 1.8 | 27 | internal_precharge | x | N0 | prenode_4_n0 | 1.799988 | V | 1.62 | 1.9800000000000002 | PASS
sizing | B5_clock_diagnostic | tt | 1.8 | 27 | internal_precharge | x | N1 | prenode_4_n1 | 1.799924 | V | 1.62 | 1.9800000000000002 | PASS
sizing | B5_clock_diagnostic | tt | 1.8 | 27 | internal_precharge | x | N2 | prenode_4_n2 | 1.8 | V | 1.62 | 1.9800000000000002 | PASS
sizing | B5_clock_diagnostic | tt | 1.8 | 27 | internal_precharge | x | N3 | prenode_4_n3 | 1.8 | V | 1.62 | 1.9800000000000002 | PASS
