leofernandesc/Open-source-sram-memory-compiler/sims/row_decoder/results/b5_review_tt_gear5_samples_metrics.csv

bench | candidate | corner | vdd_v | temperature_c | category | address | output | measurement | value | unit | low_limit | high_limit | result
sizing | B5 | tt | 1.8 | 27.0 | evaluate_window | 00 | DEC0 | win_00_dec0_min | 1.8 | V | 1.62 |  | PASS
sizing | B5 | tt | 1.8 | 27.0 | evaluate_window | 00 | DEC0 | win_00_dec0_max | 1.8 | V |  | 1.9800000000000002 | PASS
sizing | B5 | tt | 1.8 | 27.0 | evaluate_window | 00 | DEC1 | win_00_dec1_min | -0.0002577404 | V | -0.18000000000000002 |  | PASS
sizing | B5 | tt | 1.8 | 27.0 | evaluate_window | 00 | DEC1 | win_00_dec1_max | 0.003822462 | V |  | 0.18000000000000002 | PASS
sizing | B5 | tt | 1.8 | 27.0 | evaluate_window | 00 | DEC2 | win_00_dec2_min | -5.845791e-05 | V | -0.18000000000000002 |  | PASS
sizing | B5 | tt | 1.8 | 27.0 | evaluate_window | 00 | DEC2 | win_00_dec2_max | 0.003810373 | V |  | 0.18000000000000002 | PASS
sizing | B5 | tt | 1.8 | 27.0 | evaluate_window | 00 | DEC3 | win_00_dec3_min | -5.895253e-05 | V | -0.18000000000000002 |  | PASS
sizing | B5 | tt | 1.8 | 27.0 | evaluate_window | 00 | DEC3 | win_00_dec3_max | 0.003810401 | V |  | 0.18000000000000002 | PASS
sizing | B5 | tt | 1.8 | 27.0 | evaluate_window | 00 | WL0 | win_00_wl0_min | 1.799318 | V | 1.62 |  | PASS
sizing | B5 | tt | 1.8 | 27.0 | evaluate_window | 00 | WL0 | win_00_wl0_max | 1.8 | V |  | 1.9800000000000002 | PASS
sizing | B5 | tt | 1.8 | 27.0 | evaluate_window | 00 | WL1 | win_00_wl1_min | -1.026372e-05 | V | -0.18000000000000002 |  | PASS
sizing | B5 | tt | 1.8 | 27.0 | evaluate_window | 00 | WL1 | win_00_wl1_max | 1.637361e-05 | V |  | 0.18000000000000002 | PASS
sizing | B5 | tt | 1.8 | 27.0 | evaluate_window | 00 | WL2 | win_00_wl2_min | -9.618236e-06 | V | -0.18000000000000002 |  | PASS
sizing | B5 | tt | 1.8 | 27.0 | evaluate_window | 00 | WL2 | win_00_wl2_max | 1.623872e-05 | V |  | 0.18000000000000002 | PASS
sizing | B5 | tt | 1.8 | 27.0 | evaluate_window | 00 | WL3 | win_00_wl3_min | -9.615953e-06 | V | -0.18000000000000002 |  | PASS
sizing | B5 | tt | 1.8 | 27.0 | evaluate_window | 00 | WL3 | win_00_wl3_max | 1.623889e-05 | V |  | 0.18000000000000002 | PASS
sizing | B5 | tt | 1.8 | 27.0 | crossing | 00 | PCLK | clk_0_rise | 1.0025e-08 | s | 9.999999e-09 | 1.0050001000000001e-08 | PASS
sizing | B5 | tt | 1.8 | 27.0 | crossing | 00 | DEC0 | t_00_dec0_rise10 | 1.01248e-08 | s | 1e-08 | 2.005e-08 | PASS
sizing | B5 | tt | 1.8 | 27.0 | crossing | 00 | DEC0 | t_00_dec0_rise50 | 1.0147e-08 | s | 1e-08 | 2.005e-08 | PASS
sizing | B5 | tt | 1.8 | 27.0 | crossing | 00 | DEC0 | t_00_dec0_rise90 | 1.01769e-08 | s | 1e-08 | 2.005e-08 | PASS
sizing | B5 | tt | 1.8 | 27.0 | evaluation_delay | 00 | DEC0 | delay_00_dec0_rise | 1.21958e-10 | s | 0 |  | PASS
sizing | B5 | tt | 1.8 | 27.0 | output_slew | 00 | DEC0 | slew_00_dec0_rise | 5.21225e-11 | s | 0 |  | PASS
sizing | B5 | tt | 1.8 | 27.0 | crossing | 00 | WL0 | t_00_wl0_rise10 | 1.02216e-08 | s | 1e-08 | 2.005e-08 | PASS
sizing | B5 | tt | 1.8 | 27.0 | crossing | 00 | WL0 | t_00_wl0_rise50 | 1.03278e-08 | s | 1e-08 | 2.005e-08 | PASS
sizing | B5 | tt | 1.8 | 27.0 | crossing | 00 | WL0 | t_00_wl0_rise90 | 1.05164e-08 | s | 1e-08 | 2.005e-08 | PASS
sizing | B5 | tt | 1.8 | 27.0 | evaluation_delay | 00 | WL0 | delay_00_wl0_rise | 3.02766e-10 | s | 0 |  | PASS
sizing | B5 | tt | 1.8 | 27.0 | output_slew | 00 | WL0 | slew_00_wl0_rise | 2.94759e-10 | s | 0 |  | PASS
sizing | B5 | tt | 1.8 | 27.0 | crossing | 00 | PCLK | clk_0_fall | 2.0075e-08 | s | 2.0049999e-08 | 2.0100001e-08 | PASS
sizing | B5 | tt | 1.8 | 27.0 | crossing | 00 | DEC0 | t_00_dec0_fall10 | 2.01903e-08 | s | 2.005e-08 | 3.0000000000000004e-08 | PASS
sizing | B5 | tt | 1.8 | 27.0 | crossing | 00 | DEC0 | t_00_dec0_fall50 | 2.01777e-08 | s | 2.005e-08 | 3.0000000000000004e-08 | PASS
sizing | B5 | tt | 1.8 | 27.0 | crossing | 00 | DEC0 | t_00_dec0_fall90 | 2.0163e-08 | s | 2.005e-08 | 3.0000000000000004e-08 | PASS
sizing | B5 | tt | 1.8 | 27.0 | precharge_delay | 00 | DEC0 | delay_00_dec0_fall | 1.15294e-10 | s | 0 |  | PASS
sizing | B5 | tt | 1.8 | 27.0 | output_slew | 00 | DEC0 | slew_00_dec0_fall | 2.73383e-11 | s | 0 |  | PASS
sizing | B5 | tt | 1.8 | 27.0 | crossing | 00 | WL0 | t_00_wl0_fall10 | 2.03664e-08 | s | 2.005e-08 | 3.0000000000000004e-08 | PASS
sizing | B5 | tt | 1.8 | 27.0 | crossing | 00 | WL0 | t_00_wl0_fall50 | 2.03105e-08 | s | 2.005e-08 | 3.0000000000000004e-08 | PASS
sizing | B5 | tt | 1.8 | 27.0 | crossing | 00 | WL0 | t_00_wl0_fall90 | 2.02609e-08 | s | 2.005e-08 | 3.0000000000000004e-08 | PASS
sizing | B5 | tt | 1.8 | 27.0 | precharge_delay | 00 | WL0 | delay_00_wl0_fall | 2.91449e-10 | s | 0 |  | PASS
sizing | B5 | tt | 1.8 | 27.0 | output_slew | 00 | WL0 | slew_00_wl0_fall | 1.05513e-10 | s | 0 |  | PASS
sizing | B5 | tt | 1.8 | 27.0 | dynamic_node_sample | 00 | N0 | internal_00_n0 | 1.364835e-06 | V |  |  | MEASURED
sizing | B5 | tt | 1.8 | 27.0 | output_nmos_vgs_upper | 00 | M10 | vgs_peak_00_m10 | 1.972916 | V |  | 1.95 | OUTSIDE_MODEL_RANGE
sizing | B5 | tt | 1.8 | 27.0 | dynamic_node_sample | 00 | N1 | internal_00_n1 | 1.962931 | V |  |  | MEASURED
sizing | B5 | tt | 1.8 | 27.0 | output_nmos_vgs_upper | 00 | M15 | vgs_peak_00_m15 | 1.969631 | V |  | 1.95 | OUTSIDE_MODEL_RANGE
sizing | B5 | tt | 1.8 | 27.0 | dynamic_node_min | 00 | N1 | internal_min_00_n1 | 1.79998 | V |  |  | MEASURED
sizing | B5 | tt | 1.8 | 27.0 | dynamic_node_sample | 00 | N2 | internal_00_n2 | 1.96979 | V |  |  | MEASURED
sizing | B5 | tt | 1.8 | 27.0 | output_nmos_vgs_upper | 00 | M20 | vgs_peak_00_m20 | 1.970546 | V |  | 1.95 | OUTSIDE_MODEL_RANGE
sizing | B5 | tt | 1.8 | 27.0 | dynamic_node_min | 00 | N2 | internal_min_00_n2 | 1.8 | V |  |  | MEASURED
sizing | B5 | tt | 1.8 | 27.0 | dynamic_node_sample | 00 | N3 | internal_00_n3 | 1.969693 | V |  |  | MEASURED
sizing | B5 | tt | 1.8 | 27.0 | output_nmos_vgs_upper | 00 | M25 | vgs_peak_00_m25 | 1.970556 | V |  | 1.95 | OUTSIDE_MODEL_RANGE
sizing | B5 | tt | 1.8 | 27.0 | dynamic_node_min | 00 | N3 | internal_min_00_n3 | 1.8 | V |  |  | MEASURED
sizing | B5 | tt | 1.8 | 27.0 | footer_voltage | 00 | EVAL_GND | footer_00 | 7.418631e-07 | V |  |  | MEASURED
sizing | B5 | tt | 1.8 | 27.0 | supply_charge | 00 |  | charge_00_evaluate | -4.68349e-14 | C |  |  | MEASURED
sizing | B5 | tt | 1.8 | 27.0 | supply_energy | 00 |  | energy_00_evaluate | 8.43028e-14 | J |  |  | MEASURED
sizing | B5 | tt | 1.8 | 27.0 | supply_charge | 00 |  | charge_00_precharge | -1.77701e-14 | C |  |  | MEASURED
sizing | B5 | tt | 1.8 | 27.0 | supply_energy | 00 |  | energy_00_precharge | 3.19862e-14 | J |  |  | MEASURED
sizing | B5 | tt | 1.8 | 27.0 | settled_supply_current | 00 |  | supply_00 | -9.295943e-10 | A |  |  | MEASURED
sizing | B5 | tt | 1.8 | 27.0 | evaluate_window | 01 | DEC0 | win_01_dec0_min | -0.0002457579 | V | -0.18000000000000002 |  | PASS
sizing | B5 | tt | 1.8 | 27.0 | evaluate_window | 01 | DEC0 | win_01_dec0_max | 0.00407725 | V |  | 0.18000000000000002 | PASS
sizing | B5 | tt | 1.8 | 27.0 | evaluate_window | 01 | DEC1 | win_01_dec1_min | 1.8 | V | 1.62 |  | PASS
sizing | B5 | tt | 1.8 | 27.0 | evaluate_window | 01 | DEC1 | win_01_dec1_max | 1.8 | V |  | 1.9800000000000002 | PASS
sizing | B5 | tt | 1.8 | 27.0 | evaluate_window | 01 | DEC2 | win_01_dec2_min | -5.99228e-05 | V | -0.18000000000000002 |  | PASS
sizing | B5 | tt | 1.8 | 27.0 | evaluate_window | 01 | DEC2 | win_01_dec2_max | 0.004053288 | V |  | 0.18000000000000002 | PASS
sizing | B5 | tt | 1.8 | 27.0 | evaluate_window | 01 | DEC3 | win_01_dec3_min | -5.937564e-05 | V | -0.18000000000000002 |  | PASS
sizing | B5 | tt | 1.8 | 27.0 | evaluate_window | 01 | DEC3 | win_01_dec3_max | 0.004053292 | V |  | 0.18000000000000002 | PASS
sizing | B5 | tt | 1.8 | 27.0 | evaluate_window | 01 | WL0 | win_01_wl0_min | -1.032861e-05 | V | -0.18000000000000002 |  | PASS
sizing | B5 | tt | 1.8 | 27.0 | evaluate_window | 01 | WL0 | win_01_wl0_max | 1.691052e-05 | V |  | 0.18000000000000002 | PASS
sizing | B5 | tt | 1.8 | 27.0 | evaluate_window | 01 | WL1 | win_01_wl1_min | 1.799332 | V | 1.62 |  | PASS
sizing | B5 | tt | 1.8 | 27.0 | evaluate_window | 01 | WL1 | win_01_wl1_max | 1.8 | V |  | 1.9800000000000002 | PASS
sizing | B5 | tt | 1.8 | 27.0 | evaluate_window | 01 | WL2 | win_01_wl2_min | -9.567573e-06 | V | -0.18000000000000002 |  | PASS
sizing | B5 | tt | 1.8 | 27.0 | evaluate_window | 01 | WL2 | win_01_wl2_max | 1.680699e-05 | V |  | 0.18000000000000002 | PASS
sizing | B5 | tt | 1.8 | 27.0 | evaluate_window | 01 | WL3 | win_01_wl3_min | -9.568846e-06 | V | -0.18000000000000002 |  | PASS
sizing | B5 | tt | 1.8 | 27.0 | evaluate_window | 01 | WL3 | win_01_wl3_max | 1.680701e-05 | V |  | 0.18000000000000002 | PASS
sizing | B5 | tt | 1.8 | 27.0 | crossing | 01 | PCLK | clk_1_rise | 3.0025e-08 | s | 2.999999900000001e-08 | 3.0050001e-08 | PASS
sizing | B5 | tt | 1.8 | 27.0 | crossing | 01 | DEC1 | t_01_dec1_rise10 | 3.0123e-08 | s | 3.0000000000000004e-08 | 4.0050000000000005e-08 | PASS
sizing | B5 | tt | 1.8 | 27.0 | crossing | 01 | DEC1 | t_01_dec1_rise50 | 3.01449e-08 | s | 3.0000000000000004e-08 | 4.0050000000000005e-08 | PASS
sizing | B5 | tt | 1.8 | 27.0 | crossing | 01 | DEC1 | t_01_dec1_rise90 | 3.0175e-08 | s | 3.0000000000000004e-08 | 4.0050000000000005e-08 | PASS
sizing | B5 | tt | 1.8 | 27.0 | evaluation_delay | 01 | DEC1 | delay_01_dec1_rise | 1.1994e-10 | s | 0 |  | PASS
sizing | B5 | tt | 1.8 | 27.0 | output_slew | 01 | DEC1 | slew_01_dec1_rise | 5.20434e-11 | s | 0 |  | PASS
sizing | B5 | tt | 1.8 | 27.0 | crossing | 01 | WL1 | t_01_wl1_rise10 | 3.02196e-08 | s | 3.0000000000000004e-08 | 4.0050000000000005e-08 | PASS
sizing | B5 | tt | 1.8 | 27.0 | crossing | 01 | WL1 | t_01_wl1_rise50 | 3.03257e-08 | s | 3.0000000000000004e-08 | 4.0050000000000005e-08 | PASS
sizing | B5 | tt | 1.8 | 27.0 | crossing | 01 | WL1 | t_01_wl1_rise90 | 3.05144e-08 | s | 3.0000000000000004e-08 | 4.0050000000000005e-08 | PASS
sizing | B5 | tt | 1.8 | 27.0 | evaluation_delay | 01 | WL1 | delay_01_wl1_rise | 3.00745e-10 | s | 0 |  | PASS
sizing | B5 | tt | 1.8 | 27.0 | output_slew | 01 | WL1 | slew_01_wl1_rise | 2.94765e-10 | s | 0 |  | PASS
sizing | B5 | tt | 1.8 | 27.0 | crossing | 01 | PCLK | clk_1_fall | 4.0075e-08 | s | 4.004999900000001e-08 | 4.0100001e-08 | PASS
sizing | B5 | tt | 1.8 | 27.0 | crossing | 01 | DEC1 | t_01_dec1_fall10 | 4.01912e-08 | s | 4.0050000000000005e-08 | 5.0000000000000004e-08 | PASS
sizing | B5 | tt | 1.8 | 27.0 | crossing | 01 | DEC1 | t_01_dec1_fall50 | 4.01787e-08 | s | 4.0050000000000005e-08 | 5.0000000000000004e-08 | PASS
sizing | B5 | tt | 1.8 | 27.0 | crossing | 01 | DEC1 | t_01_dec1_fall90 | 4.01641e-08 | s | 4.0050000000000005e-08 | 5.0000000000000004e-08 | PASS
sizing | B5 | tt | 1.8 | 27.0 | precharge_delay | 01 | DEC1 | delay_01_dec1_fall | 1.16159e-10 | s | 0 |  | PASS
sizing | B5 | tt | 1.8 | 27.0 | output_slew | 01 | DEC1 | slew_01_dec1_fall | 2.71004e-11 | s | 0 |  | PASS
sizing | B5 | tt | 1.8 | 27.0 | crossing | 01 | WL1 | t_01_wl1_fall10 | 4.03674e-08 | s | 4.0050000000000005e-08 | 5.0000000000000004e-08 | PASS
sizing | B5 | tt | 1.8 | 27.0 | crossing | 01 | WL1 | t_01_wl1_fall50 | 4.03115e-08 | s | 4.0050000000000005e-08 | 5.0000000000000004e-08 | PASS
sizing | B5 | tt | 1.8 | 27.0 | crossing | 01 | WL1 | t_01_wl1_fall90 | 4.0262e-08 | s | 4.0050000000000005e-08 | 5.0000000000000004e-08 | PASS
sizing | B5 | tt | 1.8 | 27.0 | precharge_delay | 01 | WL1 | delay_01_wl1_fall | 2.92393e-10 | s | 0 |  | PASS
sizing | B5 | tt | 1.8 | 27.0 | output_slew | 01 | WL1 | slew_01_wl1_fall | 1.05419e-10 | s | 0 |  | PASS
sizing | B5 | tt | 1.8 | 27.0 | dynamic_node_sample | 01 | N0 | internal_01_n0 | 1.96166 | V |  |  | MEASURED
sizing | B5 | tt | 1.8 | 27.0 | output_nmos_vgs_upper | 01 | M10 | vgs_peak_01_m10 | 1.96957 | V |  | 1.95 | OUTSIDE_MODEL_RANGE
sizing | B5 | tt | 1.8 | 27.0 | dynamic_node_min | 01 | N0 | internal_min_01_n0 | 1.799974 | V |  |  | MEASURED
sizing | B5 | tt | 1.8 | 27.0 | dynamic_node_sample | 01 | N1 | internal_01_n1 | 1.364557e-06 | V |  |  | MEASURED
sizing | B5 | tt | 1.8 | 27.0 | output_nmos_vgs_upper | 01 | M15 | vgs_peak_01_m15 | 1.972771 | V |  | 1.95 | OUTSIDE_MODEL_RANGE
sizing | B5 | tt | 1.8 | 27.0 | dynamic_node_sample | 01 | N2 | internal_01_n2 | 1.969728 | V |  |  | MEASURED
sizing | B5 | tt | 1.8 | 27.0 | output_nmos_vgs_upper | 01 | M20 | vgs_peak_01_m20 | 1.970593 | V |  | 1.95 | OUTSIDE_MODEL_RANGE
sizing | B5 | tt | 1.8 | 27.0 | dynamic_node_min | 01 | N2 | internal_min_01_n2 | 1.8 | V |  |  | MEASURED
sizing | B5 | tt | 1.8 | 27.0 | dynamic_node_sample | 01 | N3 | internal_01_n3 | 1.969826 | V |  |  | MEASURED
sizing | B5 | tt | 1.8 | 27.0 | output_nmos_vgs_upper | 01 | M25 | vgs_peak_01_m25 | 1.970583 | V |  | 1.95 | OUTSIDE_MODEL_RANGE
sizing | B5 | tt | 1.8 | 27.0 | dynamic_node_min | 01 | N3 | internal_min_01_n3 | 1.8 | V |  |  | MEASURED
sizing | B5 | tt | 1.8 | 27.0 | footer_voltage | 01 | EVAL_GND | footer_01 | 7.417492e-07 | V |  |  | MEASURED
sizing | B5 | tt | 1.8 | 27.0 | supply_charge | 01 |  | charge_01_evaluate | -4.40995e-14 | C |  |  | MEASURED
sizing | B5 | tt | 1.8 | 27.0 | supply_energy | 01 |  | energy_01_evaluate | 7.9379e-14 | J |  |  | MEASURED
sizing | B5 | tt | 1.8 | 27.0 | supply_charge | 01 |  | charge_01_precharge | -2.56859e-14 | C |  |  | MEASURED
sizing | B5 | tt | 1.8 | 27.0 | supply_energy | 01 |  | energy_01_precharge | 4.62346e-14 | J |  |  | MEASURED
sizing | B5 | tt | 1.8 | 27.0 | settled_supply_current | 01 |  | supply_01 | -1.357009e-09 | A |  |  | MEASURED
sizing | B5 | tt | 1.8 | 27.0 | evaluate_window | 10 | DEC0 | win_10_dec0_min | -6.52006e-05 | V | -0.18000000000000002 |  | PASS
sizing | B5 | tt | 1.8 | 27.0 | evaluate_window | 10 | DEC0 | win_10_dec0_max | 0.004059652 | V |  | 0.18000000000000002 | PASS
sizing | B5 | tt | 1.8 | 27.0 | evaluate_window | 10 | DEC1 | win_10_dec1_min | -6.469246e-05 | V | -0.18000000000000002 |  | PASS
sizing | B5 | tt | 1.8 | 27.0 | evaluate_window | 10 | DEC1 | win_10_dec1_max | 0.004059653 | V |  | 0.18000000000000002 | PASS
sizing | B5 | tt | 1.8 | 27.0 | evaluate_window | 10 | DEC2 | win_10_dec2_min | 1.8 | V | 1.62 |  | PASS
sizing | B5 | tt | 1.8 | 27.0 | evaluate_window | 10 | DEC2 | win_10_dec2_max | 1.8 | V |  | 1.9800000000000002 | PASS
sizing | B5 | tt | 1.8 | 27.0 | evaluate_window | 10 | DEC3 | win_10_dec3_min | -6.164716e-05 | V | -0.18000000000000002 |  | PASS
sizing | B5 | tt | 1.8 | 27.0 | evaluate_window | 10 | DEC3 | win_10_dec3_max | 0.004054389 | V |  | 0.18000000000000002 | PASS
sizing | B5 | tt | 1.8 | 27.0 | evaluate_window | 10 | WL0 | win_10_wl0_min | -9.712526e-06 | V | -0.18000000000000002 |  | PASS
sizing | B5 | tt | 1.8 | 27.0 | evaluate_window | 10 | WL0 | win_10_wl0_max | 1.683791e-05 | V |  | 0.18000000000000002 | PASS
sizing | B5 | tt | 1.8 | 27.0 | evaluate_window | 10 | WL1 | win_10_wl1_min | -9.70988e-06 | V | -0.18000000000000002 |  | PASS
sizing | B5 | tt | 1.8 | 27.0 | evaluate_window | 10 | WL1 | win_10_wl1_max | 1.683792e-05 | V |  | 0.18000000000000002 | PASS
sizing | B5 | tt | 1.8 | 27.0 | evaluate_window | 10 | WL2 | win_10_wl2_min | 1.799317 | V | 1.62 |  | PASS
sizing | B5 | tt | 1.8 | 27.0 | evaluate_window | 10 | WL2 | win_10_wl2_max | 1.8 | V |  | 1.9800000000000002 | PASS
sizing | B5 | tt | 1.8 | 27.0 | evaluate_window | 10 | WL3 | win_10_wl3_min | -9.570708e-06 | V | -0.18000000000000002 |  | PASS
sizing | B5 | tt | 1.8 | 27.0 | evaluate_window | 10 | WL3 | win_10_wl3_max | 1.681168e-05 | V |  | 0.18000000000000002 | PASS
sizing | B5 | tt | 1.8 | 27.0 | crossing | 10 | PCLK | clk_2_rise | 5.0025e-08 | s | 4.999999900000001e-08 | 5.0050001e-08 | PASS
sizing | B5 | tt | 1.8 | 27.0 | crossing | 10 | DEC2 | t_10_dec2_rise10 | 5.01247e-08 | s | 5.0000000000000004e-08 | 6.005e-08 | PASS
sizing | B5 | tt | 1.8 | 27.0 | crossing | 10 | DEC2 | t_10_dec2_rise50 | 5.01471e-08 | s | 5.0000000000000004e-08 | 6.005e-08 | PASS
sizing | B5 | tt | 1.8 | 27.0 | crossing | 10 | DEC2 | t_10_dec2_rise90 | 5.01771e-08 | s | 5.0000000000000004e-08 | 6.005e-08 | PASS
sizing | B5 | tt | 1.8 | 27.0 | evaluation_delay | 10 | DEC2 | delay_10_dec2_rise | 1.22062e-10 | s | 0 |  | PASS
sizing | B5 | tt | 1.8 | 27.0 | output_slew | 10 | DEC2 | slew_10_dec2_rise | 5.23881e-11 | s | 0 |  | PASS
sizing | B5 | tt | 1.8 | 27.0 | crossing | 10 | WL2 | t_10_wl2_rise10 | 5.02218e-08 | s | 5.0000000000000004e-08 | 6.005e-08 | PASS
sizing | B5 | tt | 1.8 | 27.0 | crossing | 10 | WL2 | t_10_wl2_rise50 | 5.03279e-08 | s | 5.0000000000000004e-08 | 6.005e-08 | PASS
sizing | B5 | tt | 1.8 | 27.0 | crossing | 10 | WL2 | t_10_wl2_rise90 | 5.05165e-08 | s | 5.0000000000000004e-08 | 6.005e-08 | PASS
sizing | B5 | tt | 1.8 | 27.0 | evaluation_delay | 10 | WL2 | delay_10_wl2_rise | 3.02906e-10 | s | 0 |  | PASS
sizing | B5 | tt | 1.8 | 27.0 | output_slew | 10 | WL2 | slew_10_wl2_rise | 2.94758e-10 | s | 0 |  | PASS
sizing | B5 | tt | 1.8 | 27.0 | crossing | 10 | PCLK | clk_2_fall | 6.0075e-08 | s | 6.0049999e-08 | 6.0100001e-08 | PASS
sizing | B5 | tt | 1.8 | 27.0 | crossing | 10 | DEC2 | t_10_dec2_fall10 | 6.01886e-08 | s | 6.005e-08 | 7e-08 | PASS
sizing | B5 | tt | 1.8 | 27.0 | crossing | 10 | DEC2 | t_10_dec2_fall50 | 6.01762e-08 | s | 6.005e-08 | 7e-08 | PASS
sizing | B5 | tt | 1.8 | 27.0 | crossing | 10 | DEC2 | t_10_dec2_fall90 | 6.01617e-08 | s | 6.005e-08 | 7e-08 | PASS
sizing | B5 | tt | 1.8 | 27.0 | precharge_delay | 10 | DEC2 | delay_10_dec2_fall | 1.13586e-10 | s | 0 |  | PASS
sizing | B5 | tt | 1.8 | 27.0 | output_slew | 10 | DEC2 | slew_10_dec2_fall | 2.68865e-11 | s | 0 |  | PASS
sizing | B5 | tt | 1.8 | 27.0 | crossing | 10 | WL2 | t_10_wl2_fall10 | 6.0365e-08 | s | 6.005e-08 | 7e-08 | PASS
sizing | B5 | tt | 1.8 | 27.0 | crossing | 10 | WL2 | t_10_wl2_fall50 | 6.0309e-08 | s | 6.005e-08 | 7e-08 | PASS
sizing | B5 | tt | 1.8 | 27.0 | crossing | 10 | WL2 | t_10_wl2_fall90 | 6.02594e-08 | s | 6.005e-08 | 7e-08 | PASS
sizing | B5 | tt | 1.8 | 27.0 | precharge_delay | 10 | WL2 | delay_10_wl2_fall | 2.89961e-10 | s | 0 |  | PASS
sizing | B5 | tt | 1.8 | 27.0 | output_slew | 10 | WL2 | slew_10_wl2_fall | 1.05551e-10 | s | 0 |  | PASS
sizing | B5 | tt | 1.8 | 27.0 | dynamic_node_sample | 10 | N0 | internal_10_n0 | 1.969741 | V |  |  | MEASURED
sizing | B5 | tt | 1.8 | 27.0 | output_nmos_vgs_upper | 10 | M10 | vgs_peak_10_m10 | 1.970419 | V |  | 1.95 | OUTSIDE_MODEL_RANGE
sizing | B5 | tt | 1.8 | 27.0 | dynamic_node_min | 10 | N0 | internal_min_10_n0 | 1.8 | V |  |  | MEASURED
sizing | B5 | tt | 1.8 | 27.0 | dynamic_node_sample | 10 | N1 | internal_10_n1 | 1.969643 | V |  |  | MEASURED
sizing | B5 | tt | 1.8 | 27.0 | output_nmos_vgs_upper | 10 | M15 | vgs_peak_10_m15 | 1.970335 | V |  | 1.95 | OUTSIDE_MODEL_RANGE
sizing | B5 | tt | 1.8 | 27.0 | dynamic_node_min | 10 | N1 | internal_min_10_n1 | 1.8 | V |  |  | MEASURED
sizing | B5 | tt | 1.8 | 27.0 | dynamic_node_sample | 10 | N2 | internal_10_n2 | 1.36632e-06 | V |  |  | MEASURED
sizing | B5 | tt | 1.8 | 27.0 | output_nmos_vgs_upper | 10 | M20 | vgs_peak_10_m20 | 1.974727 | V |  | 1.95 | OUTSIDE_MODEL_RANGE
sizing | B5 | tt | 1.8 | 27.0 | dynamic_node_sample | 10 | N3 | internal_10_n3 | 1.961875 | V |  |  | MEASURED
sizing | B5 | tt | 1.8 | 27.0 | output_nmos_vgs_upper | 10 | M25 | vgs_peak_10_m25 | 1.970545 | V |  | 1.95 | OUTSIDE_MODEL_RANGE
sizing | B5 | tt | 1.8 | 27.0 | dynamic_node_min | 10 | N3 | internal_min_10_n3 | 1.799974 | V |  |  | MEASURED
sizing | B5 | tt | 1.8 | 27.0 | footer_voltage | 10 | EVAL_GND | footer_10 | 7.428411e-07 | V |  |  | MEASURED
sizing | B5 | tt | 1.8 | 27.0 | supply_charge | 10 |  | charge_10_evaluate | -4.54183e-14 | C |  |  | MEASURED
sizing | B5 | tt | 1.8 | 27.0 | supply_energy | 10 |  | energy_10_evaluate | 8.17529e-14 | J |  |  | MEASURED
sizing | B5 | tt | 1.8 | 27.0 | supply_charge | 10 |  | charge_10_precharge | -1.84572e-14 | C |  |  | MEASURED
sizing | B5 | tt | 1.8 | 27.0 | supply_energy | 10 |  | energy_10_precharge | 3.3223e-14 | J |  |  | MEASURED
sizing | B5 | tt | 1.8 | 27.0 | settled_supply_current | 10 |  | supply_10 | -2.023434e-09 | A |  |  | MEASURED
sizing | B5 | tt | 1.8 | 27.0 | evaluate_window | 11 | DEC0 | win_11_dec0_min | -4.440796e-05 | V | -0.18000000000000002 |  | PASS
sizing | B5 | tt | 1.8 | 27.0 | evaluate_window | 11 | DEC0 | win_11_dec0_max | 0.004059489 | V |  | 0.18000000000000002 | PASS
sizing | B5 | tt | 1.8 | 27.0 | evaluate_window | 11 | DEC1 | win_11_dec1_min | -4.382604e-05 | V | -0.18000000000000002 |  | PASS
sizing | B5 | tt | 1.8 | 27.0 | evaluate_window | 11 | DEC1 | win_11_dec1_max | 0.004059493 | V |  | 0.18000000000000002 | PASS
sizing | B5 | tt | 1.8 | 27.0 | evaluate_window | 11 | DEC2 | win_11_dec2_min | -6.227977e-05 | V | -0.18000000000000002 |  | PASS
sizing | B5 | tt | 1.8 | 27.0 | evaluate_window | 11 | DEC2 | win_11_dec2_max | 0.004054183 | V |  | 0.18000000000000002 | PASS
sizing | B5 | tt | 1.8 | 27.0 | evaluate_window | 11 | DEC3 | win_11_dec3_min | 1.8 | V | 1.62 |  | PASS
sizing | B5 | tt | 1.8 | 27.0 | evaluate_window | 11 | DEC3 | win_11_dec3_max | 1.8 | V |  | 1.9800000000000002 | PASS
sizing | B5 | tt | 1.8 | 27.0 | evaluate_window | 11 | WL0 | win_11_wl0_min | -9.692694e-06 | V | -0.18000000000000002 |  | PASS
sizing | B5 | tt | 1.8 | 27.0 | evaluate_window | 11 | WL0 | win_11_wl0_max | 1.683716e-05 | V |  | 0.18000000000000002 | PASS
sizing | B5 | tt | 1.8 | 27.0 | evaluate_window | 11 | WL1 | win_11_wl1_min | -9.694219e-06 | V | -0.18000000000000002 |  | PASS
sizing | B5 | tt | 1.8 | 27.0 | evaluate_window | 11 | WL1 | win_11_wl1_max | 1.683718e-05 | V |  | 0.18000000000000002 | PASS
sizing | B5 | tt | 1.8 | 27.0 | evaluate_window | 11 | WL2 | win_11_wl2_min | -9.577979e-06 | V | -0.18000000000000002 |  | PASS
sizing | B5 | tt | 1.8 | 27.0 | evaluate_window | 11 | WL2 | win_11_wl2_max | 1.681074e-05 | V |  | 0.18000000000000002 | PASS
sizing | B5 | tt | 1.8 | 27.0 | evaluate_window | 11 | WL3 | win_11_wl3_min | 1.79934 | V | 1.62 |  | PASS
sizing | B5 | tt | 1.8 | 27.0 | evaluate_window | 11 | WL3 | win_11_wl3_max | 1.8 | V |  | 1.9800000000000002 | PASS
sizing | B5 | tt | 1.8 | 27.0 | crossing | 11 | PCLK | clk_3_rise | 7.0025e-08 | s | 6.9999999e-08 | 7.005000100000001e-08 | PASS
sizing | B5 | tt | 1.8 | 27.0 | crossing | 11 | DEC3 | t_11_dec3_rise10 | 7.01215e-08 | s | 7e-08 | 8.005e-08 | PASS
sizing | B5 | tt | 1.8 | 27.0 | crossing | 11 | DEC3 | t_11_dec3_rise50 | 7.01438e-08 | s | 7e-08 | 8.005e-08 | PASS
sizing | B5 | tt | 1.8 | 27.0 | crossing | 11 | DEC3 | t_11_dec3_rise90 | 7.01739e-08 | s | 7e-08 | 8.005e-08 | PASS
sizing | B5 | tt | 1.8 | 27.0 | evaluation_delay | 11 | DEC3 | delay_11_dec3_rise | 1.18774e-10 | s | 0 |  | PASS
sizing | B5 | tt | 1.8 | 27.0 | output_slew | 11 | DEC3 | slew_11_dec3_rise | 5.23945e-11 | s | 0 |  | PASS
sizing | B5 | tt | 1.8 | 27.0 | crossing | 11 | WL3 | t_11_wl3_rise10 | 7.02185e-08 | s | 7e-08 | 8.005e-08 | PASS
sizing | B5 | tt | 1.8 | 27.0 | crossing | 11 | WL3 | t_11_wl3_rise50 | 7.03246e-08 | s | 7e-08 | 8.005e-08 | PASS
sizing | B5 | tt | 1.8 | 27.0 | crossing | 11 | WL3 | t_11_wl3_rise90 | 7.05132e-08 | s | 7e-08 | 8.005e-08 | PASS
sizing | B5 | tt | 1.8 | 27.0 | evaluation_delay | 11 | WL3 | delay_11_wl3_rise | 2.99623e-10 | s | 0 |  | PASS
sizing | B5 | tt | 1.8 | 27.0 | output_slew | 11 | WL3 | slew_11_wl3_rise | 2.94753e-10 | s | 0 |  | PASS
sizing | B5 | tt | 1.8 | 27.0 | crossing | 11 | PCLK | clk_3_fall | 8.0075e-08 | s | 8.0049999e-08 | 8.010000100000001e-08 | PASS
sizing | B5 | tt | 1.8 | 27.0 | crossing | 11 | DEC3 | t_11_dec3_fall10 | 8.01898e-08 | s | 8.005e-08 | 9.000000000000001e-08 | PASS
sizing | B5 | tt | 1.8 | 27.0 | crossing | 11 | DEC3 | t_11_dec3_fall50 | 8.01774e-08 | s | 8.005e-08 | 9.000000000000001e-08 | PASS
sizing | B5 | tt | 1.8 | 27.0 | crossing | 11 | DEC3 | t_11_dec3_fall90 | 8.01631e-08 | s | 8.005e-08 | 9.000000000000001e-08 | PASS
sizing | B5 | tt | 1.8 | 27.0 | precharge_delay | 11 | DEC3 | delay_11_dec3_fall | 1.14771e-10 | s | 0 |  | PASS
sizing | B5 | tt | 1.8 | 27.0 | output_slew | 11 | DEC3 | slew_11_dec3_fall | 2.67056e-11 | s | 0 |  | PASS
sizing | B5 | tt | 1.8 | 27.0 | crossing | 11 | WL3 | t_11_wl3_fall10 | 8.0366e-08 | s | 8.005e-08 | 9.000000000000001e-08 | PASS
sizing | B5 | tt | 1.8 | 27.0 | crossing | 11 | WL3 | t_11_wl3_fall50 | 8.03101e-08 | s | 8.005e-08 | 9.000000000000001e-08 | PASS
sizing | B5 | tt | 1.8 | 27.0 | crossing | 11 | WL3 | t_11_wl3_fall90 | 8.02605e-08 | s | 8.005e-08 | 9.000000000000001e-08 | PASS
sizing | B5 | tt | 1.8 | 27.0 | precharge_delay | 11 | WL3 | delay_11_wl3_fall | 2.91026e-10 | s | 0 |  | PASS
sizing | B5 | tt | 1.8 | 27.0 | output_slew | 11 | WL3 | slew_11_wl3_fall | 1.05535e-10 | s | 0 |  | PASS
sizing | B5 | tt | 1.8 | 27.0 | dynamic_node_sample | 11 | N0 | internal_11_n0 | 1.969642 | V |  |  | MEASURED
sizing | B5 | tt | 1.8 | 27.0 | output_nmos_vgs_upper | 11 | M10 | vgs_peak_11_m10 | 1.970326 | V |  | 1.95 | OUTSIDE_MODEL_RANGE
sizing | B5 | tt | 1.8 | 27.0 | dynamic_node_min | 11 | N0 | internal_min_11_n0 | 1.801683 | V |  |  | MEASURED
sizing | B5 | tt | 1.8 | 27.0 | dynamic_node_sample | 11 | N1 | internal_11_n1 | 1.96974 | V |  |  | MEASURED
sizing | B5 | tt | 1.8 | 27.0 | output_nmos_vgs_upper | 11 | M15 | vgs_peak_11_m15 | 1.97042 | V |  | 1.95 | OUTSIDE_MODEL_RANGE
sizing | B5 | tt | 1.8 | 27.0 | dynamic_node_min | 11 | N1 | internal_min_11_n1 | 1.801683 | V |  |  | MEASURED
sizing | B5 | tt | 1.8 | 27.0 | dynamic_node_sample | 11 | N2 | internal_11_n2 | 1.961835 | V |  |  | MEASURED
sizing | B5 | tt | 1.8 | 27.0 | output_nmos_vgs_upper | 11 | M20 | vgs_peak_11_m20 | 1.970565 | V |  | 1.95 | OUTSIDE_MODEL_RANGE
sizing | B5 | tt | 1.8 | 27.0 | dynamic_node_min | 11 | N2 | internal_min_11_n2 | 1.801641 | V |  |  | MEASURED
sizing | B5 | tt | 1.8 | 27.0 | dynamic_node_sample | 11 | N3 | internal_11_n3 | 1.366294e-06 | V |  |  | MEASURED
sizing | B5 | tt | 1.8 | 27.0 | output_nmos_vgs_upper | 11 | M25 | vgs_peak_11_m25 | 1.975339 | V |  | 1.95 | OUTSIDE_MODEL_RANGE
sizing | B5 | tt | 1.8 | 27.0 | footer_voltage | 11 | EVAL_GND | footer_11 | 7.428146e-07 | V |  |  | MEASURED
sizing | B5 | tt | 1.8 | 27.0 | supply_charge | 11 |  | charge_11_evaluate | -4.26908e-14 | C |  |  | MEASURED
sizing | B5 | tt | 1.8 | 27.0 | supply_energy | 11 |  | energy_11_evaluate | 7.68434e-14 | J |  |  | MEASURED
sizing | B5 | tt | 1.8 | 27.0 | supply_charge | 11 |  | charge_11_precharge | -3.40547e-14 | C |  |  | MEASURED
sizing | B5 | tt | 1.8 | 27.0 | supply_energy | 11 |  | energy_11_precharge | 6.12984e-14 | J |  |  | MEASURED
sizing | B5 | tt | 1.8 | 27.0 | settled_supply_current | 11 |  | supply_11 | -2.34628e-09 | A |  |  | MEASURED
sizing | B5 | tt | 1.8 | 27.0 | precharge_window | x | DEC0 | prewin_0_dec0_min | 3.219884e-07 | V | -0.18000000000000002 |  | PASS
sizing | B5 | tt | 1.8 | 27.0 | precharge_window | x | DEC0 | prewin_0_dec0_max | 2.098425e-06 | V |  | 0.18000000000000002 | PASS
sizing | B5 | tt | 1.8 | 27.0 | precharge_window | x | DEC1 | prewin_0_dec1_min | 3.13639e-07 | V | -0.18000000000000002 |  | PASS
sizing | B5 | tt | 1.8 | 27.0 | precharge_window | x | DEC1 | prewin_0_dec1_max | 5.657299e-07 | V |  | 0.18000000000000002 | PASS
sizing | B5 | tt | 1.8 | 27.0 | precharge_window | x | DEC2 | prewin_0_dec2_min | 3.1174e-07 | V | -0.18000000000000002 |  | PASS
sizing | B5 | tt | 1.8 | 27.0 | precharge_window | x | DEC2 | prewin_0_dec2_max | 3.117407e-07 | V |  | 0.18000000000000002 | PASS
sizing | B5 | tt | 1.8 | 27.0 | precharge_window | x | DEC3 | prewin_0_dec3_min | 3.1174e-07 | V | -0.18000000000000002 |  | PASS
sizing | B5 | tt | 1.8 | 27.0 | precharge_window | x | DEC3 | prewin_0_dec3_max | 3.1174e-07 | V |  | 0.18000000000000002 | PASS
sizing | B5 | tt | 1.8 | 27.0 | precharge_window | x | WL0 | prewin_0_wl0_min | 2.914772e-07 | V | -0.18000000000000002 |  | PASS
sizing | B5 | tt | 1.8 | 27.0 | precharge_window | x | WL0 | prewin_0_wl0_max | 2.915504e-07 | V |  | 0.18000000000000002 | PASS
sizing | B5 | tt | 1.8 | 27.0 | precharge_window | x | WL1 | prewin_0_wl1_min | 2.914772e-07 | V | -0.18000000000000002 |  | PASS
sizing | B5 | tt | 1.8 | 27.0 | precharge_window | x | WL1 | prewin_0_wl1_max | 2.91486e-07 | V |  | 0.18000000000000002 | PASS
sizing | B5 | tt | 1.8 | 27.0 | precharge_window | x | WL2 | prewin_0_wl2_min | 2.914772e-07 | V | -0.18000000000000002 |  | PASS
sizing | B5 | tt | 1.8 | 27.0 | precharge_window | x | WL2 | prewin_0_wl2_max | 2.914772e-07 | V |  | 0.18000000000000002 | PASS
sizing | B5 | tt | 1.8 | 27.0 | precharge_window | x | WL3 | prewin_0_wl3_min | 2.914772e-07 | V | -0.18000000000000002 |  | PASS
sizing | B5 | tt | 1.8 | 27.0 | precharge_window | x | WL3 | prewin_0_wl3_max | 2.914772e-07 | V |  | 0.18000000000000002 | PASS
sizing | B5 | tt | 1.8 | 27.0 | internal_precharge | x | N0 | prenode_0_n0 | 1.799769 | V | 1.62 | 1.9800000000000002 | PASS
sizing | B5 | tt | 1.8 | 27.0 | internal_precharge | x | N1 | prenode_0_n1 | 1.799957 | V | 1.62 | 1.9800000000000002 | PASS
sizing | B5 | tt | 1.8 | 27.0 | internal_precharge | x | N2 | prenode_0_n2 | 1.8 | V | 1.62 | 1.9800000000000002 | PASS
sizing | B5 | tt | 1.8 | 27.0 | internal_precharge | x | N3 | prenode_0_n3 | 1.8 | V | 1.62 | 1.9800000000000002 | PASS
sizing | B5 | tt | 1.8 | 27.0 | precharge_window | x | DEC0 | prewin_1_dec0_min | -0.00137872 | V | -0.18000000000000002 |  | PASS
sizing | B5 | tt | 1.8 | 27.0 | precharge_window | x | DEC0 | prewin_1_dec0_max | 0.0003761128 | V |  | 0.18000000000000002 | PASS
sizing | B5 | tt | 1.8 | 27.0 | precharge_window | x | DEC1 | prewin_1_dec1_min | -4.001562e-05 | V | -0.18000000000000002 |  | PASS
sizing | B5 | tt | 1.8 | 27.0 | precharge_window | x | DEC1 | prewin_1_dec1_max | 5.572511e-05 | V |  | 0.18000000000000002 | PASS
sizing | B5 | tt | 1.8 | 27.0 | precharge_window | x | DEC2 | prewin_1_dec2_min | 1.013455e-07 | V | -0.18000000000000002 |  | PASS
sizing | B5 | tt | 1.8 | 27.0 | precharge_window | x | DEC2 | prewin_1_dec2_max | 7.743126e-07 | V |  | 0.18000000000000002 | PASS
sizing | B5 | tt | 1.8 | 27.0 | precharge_window | x | DEC3 | prewin_1_dec3_min | -1.769021e-06 | V | -0.18000000000000002 |  | PASS
sizing | B5 | tt | 1.8 | 27.0 | precharge_window | x | DEC3 | prewin_1_dec3_max | 1.207988e-06 | V |  | 0.18000000000000002 | PASS
sizing | B5 | tt | 1.8 | 27.0 | precharge_window | x | WL0 | prewin_1_wl0_min | -4.645297e-06 | V | -0.18000000000000002 |  | PASS
sizing | B5 | tt | 1.8 | 27.0 | precharge_window | x | WL0 | prewin_1_wl0_max | 4.363472e-06 | V |  | 0.18000000000000002 | PASS
sizing | B5 | tt | 1.8 | 27.0 | precharge_window | x | WL1 | prewin_1_wl1_min | 1.694068e-07 | V | -0.18000000000000002 |  | PASS
sizing | B5 | tt | 1.8 | 27.0 | precharge_window | x | WL1 | prewin_1_wl1_max | 5.632247e-07 | V |  | 0.18000000000000002 | PASS
sizing | B5 | tt | 1.8 | 27.0 | precharge_window | x | WL2 | prewin_1_wl2_min | 2.90198e-07 | V | -0.18000000000000002 |  | PASS
sizing | B5 | tt | 1.8 | 27.0 | precharge_window | x | WL2 | prewin_1_wl2_max | 2.934752e-07 | V |  | 0.18000000000000002 | PASS
sizing | B5 | tt | 1.8 | 27.0 | precharge_window | x | WL3 | prewin_1_wl3_min | 2.829108e-07 | V | -0.18000000000000002 |  | PASS
sizing | B5 | tt | 1.8 | 27.0 | precharge_window | x | WL3 | prewin_1_wl3_max | 2.964427e-07 | V |  | 0.18000000000000002 | PASS
sizing | B5 | tt | 1.8 | 27.0 | internal_precharge | x | N0 | prenode_1_n0 | 1.799924 | V | 1.62 | 1.9800000000000002 | PASS
sizing | B5 | tt | 1.8 | 27.0 | internal_precharge | x | N1 | prenode_1_n1 | 1.799615 | V | 1.62 | 1.9800000000000002 | PASS
sizing | B5 | tt | 1.8 | 27.0 | internal_precharge | x | N2 | prenode_1_n2 | 1.8 | V | 1.62 | 1.9800000000000002 | PASS
sizing | B5 | tt | 1.8 | 27.0 | internal_precharge | x | N3 | prenode_1_n3 | 1.8 | V | 1.62 | 1.9800000000000002 | PASS
sizing | B5 | tt | 1.8 | 27.0 | precharge_window | x | DEC0 | prewin_2_dec0_min | -0.00301576 | V | -0.18000000000000002 |  | PASS
sizing | B5 | tt | 1.8 | 27.0 | precharge_window | x | DEC0 | prewin_2_dec0_max | 0.002057287 | V |  | 0.18000000000000002 | PASS
sizing | B5 | tt | 1.8 | 27.0 | precharge_window | x | DEC1 | prewin_2_dec1_min | -0.002917953 | V | -0.18000000000000002 |  | PASS
sizing | B5 | tt | 1.8 | 27.0 | precharge_window | x | DEC1 | prewin_2_dec1_max | 0.002122563 | V |  | 0.18000000000000002 | PASS
sizing | B5 | tt | 1.8 | 27.0 | precharge_window | x | DEC2 | prewin_2_dec2_min | -0.001601717 | V | -0.18000000000000002 |  | PASS
sizing | B5 | tt | 1.8 | 27.0 | precharge_window | x | DEC2 | prewin_2_dec2_max | 0.00140738 | V |  | 0.18000000000000002 | PASS
sizing | B5 | tt | 1.8 | 27.0 | precharge_window | x | DEC3 | prewin_2_dec3_min | -0.001345201 | V | -0.18000000000000002 |  | PASS
sizing | B5 | tt | 1.8 | 27.0 | precharge_window | x | DEC3 | prewin_2_dec3_max | 0.001407371 | V |  | 0.18000000000000002 | PASS
sizing | B5 | tt | 1.8 | 27.0 | precharge_window | x | WL0 | prewin_2_wl0_min | -7.790541e-06 | V | -0.18000000000000002 |  | PASS
sizing | B5 | tt | 1.8 | 27.0 | precharge_window | x | WL0 | prewin_2_wl0_max | 1.558882e-05 | V |  | 0.18000000000000002 | PASS
sizing | B5 | tt | 1.8 | 27.0 | precharge_window | x | WL1 | prewin_2_wl1_min | -7.324821e-06 | V | -0.18000000000000002 |  | PASS
sizing | B5 | tt | 1.8 | 27.0 | precharge_window | x | WL1 | prewin_2_wl1_max | 1.57411e-05 | V |  | 0.18000000000000002 | PASS
sizing | B5 | tt | 1.8 | 27.0 | precharge_window | x | WL2 | prewin_2_wl2_min | -7.707265e-06 | V | -0.18000000000000002 |  | PASS
sizing | B5 | tt | 1.8 | 27.0 | precharge_window | x | WL2 | prewin_2_wl2_max | 6.03099e-06 | V |  | 0.18000000000000002 | PASS
sizing | B5 | tt | 1.8 | 27.0 | precharge_window | x | WL3 | prewin_2_wl3_min | -6.287925e-06 | V | -0.18000000000000002 |  | PASS
sizing | B5 | tt | 1.8 | 27.0 | precharge_window | x | WL3 | prewin_2_wl3_max | 6.030903e-06 | V |  | 0.18000000000000002 | PASS
sizing | B5 | tt | 1.8 | 27.0 | internal_precharge | x | N0 | prenode_2_n0 | 1.8 | V | 1.62 | 1.9800000000000002 | PASS
sizing | B5 | tt | 1.8 | 27.0 | internal_precharge | x | N1 | prenode_2_n1 | 1.8 | V | 1.62 | 1.9800000000000002 | PASS
sizing | B5 | tt | 1.8 | 27.0 | internal_precharge | x | N2 | prenode_2_n2 | 1.799995 | V | 1.62 | 1.9800000000000002 | PASS
sizing | B5 | tt | 1.8 | 27.0 | internal_precharge | x | N3 | prenode_2_n3 | 1.799926 | V | 1.62 | 1.9800000000000002 | PASS
sizing | B5 | tt | 1.8 | 27.0 | precharge_window | x | DEC0 | prewin_3_dec0_min | -9.353686e-06 | V | -0.18000000000000002 |  | PASS
sizing | B5 | tt | 1.8 | 27.0 | precharge_window | x | DEC0 | prewin_3_dec0_max | 1.53376e-05 | V |  | 0.18000000000000002 | PASS
sizing | B5 | tt | 1.8 | 27.0 | precharge_window | x | DEC1 | prewin_3_dec1_min | -9.138551e-06 | V | -0.18000000000000002 |  | PASS
sizing | B5 | tt | 1.8 | 27.0 | precharge_window | x | DEC1 | prewin_3_dec1_max | 1.507147e-05 | V |  | 0.18000000000000002 | PASS
sizing | B5 | tt | 1.8 | 27.0 | precharge_window | x | DEC2 | prewin_3_dec2_min | -0.001495458 | V | -0.18000000000000002 |  | PASS
sizing | B5 | tt | 1.8 | 27.0 | precharge_window | x | DEC2 | prewin_3_dec2_max | 0.0004077482 | V |  | 0.18000000000000002 | PASS
sizing | B5 | tt | 1.8 | 27.0 | precharge_window | x | DEC3 | prewin_3_dec3_min | -3.419067e-05 | V | -0.18000000000000002 |  | PASS
sizing | B5 | tt | 1.8 | 27.0 | precharge_window | x | DEC3 | prewin_3_dec3_max | 8.41297e-06 | V |  | 0.18000000000000002 | PASS
sizing | B5 | tt | 1.8 | 27.0 | precharge_window | x | WL0 | prewin_3_wl0_min | 2.586109e-07 | V | -0.18000000000000002 |  | PASS
sizing | B5 | tt | 1.8 | 27.0 | precharge_window | x | WL0 | prewin_3_wl0_max | 3.709905e-07 | V |  | 0.18000000000000002 | PASS
sizing | B5 | tt | 1.8 | 27.0 | precharge_window | x | WL1 | prewin_3_wl1_min | 2.583018e-07 | V | -0.18000000000000002 |  | PASS
sizing | B5 | tt | 1.8 | 27.0 | precharge_window | x | WL1 | prewin_3_wl1_max | 3.695546e-07 | V |  | 0.18000000000000002 | PASS
sizing | B5 | tt | 1.8 | 27.0 | precharge_window | x | WL2 | prewin_3_wl2_min | -5.185752e-06 | V | -0.18000000000000002 |  | PASS
sizing | B5 | tt | 1.8 | 27.0 | precharge_window | x | WL2 | prewin_3_wl2_max | 4.781446e-06 | V |  | 0.18000000000000002 | PASS
sizing | B5 | tt | 1.8 | 27.0 | precharge_window | x | WL3 | prewin_3_wl3_min | 1.501725e-07 | V | -0.18000000000000002 |  | PASS
sizing | B5 | tt | 1.8 | 27.0 | precharge_window | x | WL3 | prewin_3_wl3_max | 3.743411e-07 | V |  | 0.18000000000000002 | PASS
sizing | B5 | tt | 1.8 | 27.0 | internal_precharge | x | N0 | prenode_3_n0 | 1.8 | V | 1.62 | 1.9800000000000002 | PASS
sizing | B5 | tt | 1.8 | 27.0 | internal_precharge | x | N1 | prenode_3_n1 | 1.8 | V | 1.62 | 1.9800000000000002 | PASS
sizing | B5 | tt | 1.8 | 27.0 | internal_precharge | x | N2 | prenode_3_n2 | 1.799924 | V | 1.62 | 1.9800000000000002 | PASS
sizing | B5 | tt | 1.8 | 27.0 | internal_precharge | x | N3 | prenode_3_n3 | 1.799925 | V | 1.62 | 1.9800000000000002 | PASS
sizing | B5 | tt | 1.8 | 27.0 | precharge_window | x | DEC0 | prewin_4_dec0_min | -0.0007515641 | V | -0.18000000000000002 |  | PASS
sizing | B5 | tt | 1.8 | 27.0 | precharge_window | x | DEC0 | prewin_4_dec0_max | 0.001516872 | V |  | 0.18000000000000002 | PASS
sizing | B5 | tt | 1.8 | 27.0 | precharge_window | x | DEC1 | prewin_4_dec1_min | -0.0007031318 | V | -0.18000000000000002 |  | PASS
sizing | B5 | tt | 1.8 | 27.0 | precharge_window | x | DEC1 | prewin_4_dec1_max | 0.001517535 | V |  | 0.18000000000000002 | PASS
sizing | B5 | tt | 1.8 | 27.0 | precharge_window | x | DEC2 | prewin_4_dec2_min | -0.001435383 | V | -0.18000000000000002 |  | PASS
sizing | B5 | tt | 1.8 | 27.0 | precharge_window | x | DEC2 | prewin_4_dec2_max | 0.001320527 | V |  | 0.18000000000000002 | PASS
sizing | B5 | tt | 1.8 | 27.0 | precharge_window | x | DEC3 | prewin_4_dec3_min | -0.001547978 | V | -0.18000000000000002 |  | PASS
sizing | B5 | tt | 1.8 | 27.0 | precharge_window | x | DEC3 | prewin_4_dec3_max | 0.001331936 | V |  | 0.18000000000000002 | PASS
sizing | B5 | tt | 1.8 | 27.0 | precharge_window | x | WL0 | prewin_4_wl0_min | -5.531909e-06 | V | -0.18000000000000002 |  | PASS
sizing | B5 | tt | 1.8 | 27.0 | precharge_window | x | WL0 | prewin_4_wl0_max | 3.591426e-06 | V |  | 0.18000000000000002 | PASS
sizing | B5 | tt | 1.8 | 27.0 | precharge_window | x | WL1 | prewin_4_wl1_min | -5.368479e-06 | V | -0.18000000000000002 |  | PASS
sizing | B5 | tt | 1.8 | 27.0 | precharge_window | x | WL1 | prewin_4_wl1_max | 3.593895e-06 | V |  | 0.18000000000000002 | PASS
sizing | B5 | tt | 1.8 | 27.0 | precharge_window | x | WL2 | prewin_4_wl2_min | -5.685123e-06 | V | -0.18000000000000002 |  | PASS
sizing | B5 | tt | 1.8 | 27.0 | precharge_window | x | WL2 | prewin_4_wl2_max | 6.682364e-06 | V |  | 0.18000000000000002 | PASS
sizing | B5 | tt | 1.8 | 27.0 | precharge_window | x | WL3 | prewin_4_wl3_min | -6.170425e-06 | V | -0.18000000000000002 |  | PASS
sizing | B5 | tt | 1.8 | 27.0 | precharge_window | x | WL3 | prewin_4_wl3_max | 6.596506e-06 | V |  | 0.18000000000000002 | PASS
sizing | B5 | tt | 1.8 | 27.0 | internal_precharge | x | N0 | prenode_4_n0 | 1.799995 | V | 1.62 | 1.9800000000000002 | PASS
sizing | B5 | tt | 1.8 | 27.0 | internal_precharge | x | N1 | prenode_4_n1 | 1.799924 | V | 1.62 | 1.9800000000000002 | PASS
sizing | B5 | tt | 1.8 | 27.0 | internal_precharge | x | N2 | prenode_4_n2 | 1.8 | V | 1.62 | 1.9800000000000002 | PASS
sizing | B5 | tt | 1.8 | 27.0 | internal_precharge | x | N3 | prenode_4_n3 | 1.8 | V | 1.62 | 1.9800000000000002 | PASS
