leofernandesc/Open-source-sram-memory-compiler/sims/row_decoder/results/b5_review_tt_samples_metrics.csv

bench | candidate | corner | vdd_v | temperature_c | category | address | output | measurement | value | unit | low_limit | high_limit | result
sizing | B5 | tt | 1.8 | 27 | evaluate_window | 00 | DEC0 | win_00_dec0_min | 1.8 | V | 1.62 |  | PASS
sizing | B5 | tt | 1.8 | 27 | evaluate_window | 00 | DEC0 | win_00_dec0_max | 1.8 | V |  | 1.9800000000000002 | PASS
sizing | B5 | tt | 1.8 | 27 | evaluate_window | 00 | DEC1 | win_00_dec1_min | -0.0002133915 | V | -0.18000000000000002 |  | PASS
sizing | B5 | tt | 1.8 | 27 | evaluate_window | 00 | DEC1 | win_00_dec1_max | 0.003981708 | V |  | 0.18000000000000002 | PASS
sizing | B5 | tt | 1.8 | 27 | evaluate_window | 00 | DEC2 | win_00_dec2_min | -9.056235e-05 | V | -0.18000000000000002 |  | PASS
sizing | B5 | tt | 1.8 | 27 | evaluate_window | 00 | DEC2 | win_00_dec2_max | 0.003956041 | V |  | 0.18000000000000002 | PASS
sizing | B5 | tt | 1.8 | 27 | evaluate_window | 00 | DEC3 | win_00_dec3_min | -9.122926e-05 | V | -0.18000000000000002 |  | PASS
sizing | B5 | tt | 1.8 | 27 | evaluate_window | 00 | DEC3 | win_00_dec3_max | 0.003956077 | V |  | 0.18000000000000002 | PASS
sizing | B5 | tt | 1.8 | 27 | evaluate_window | 00 | WL0 | win_00_wl0_min | 1.799343 | V | 1.62 |  | PASS
sizing | B5 | tt | 1.8 | 27 | evaluate_window | 00 | WL0 | win_00_wl0_max | 1.8 | V |  | 1.9800000000000002 | PASS
sizing | B5 | tt | 1.8 | 27 | evaluate_window | 00 | WL1 | win_00_wl1_min | -1.052924e-05 | V | -0.18000000000000002 |  | PASS
sizing | B5 | tt | 1.8 | 27 | evaluate_window | 00 | WL1 | win_00_wl1_max | 1.632968e-05 | V |  | 0.18000000000000002 | PASS
sizing | B5 | tt | 1.8 | 27 | evaluate_window | 00 | WL2 | win_00_wl2_min | -9.97592e-06 | V | -0.18000000000000002 |  | PASS
sizing | B5 | tt | 1.8 | 27 | evaluate_window | 00 | WL2 | win_00_wl2_max | 1.622104e-05 | V |  | 0.18000000000000002 | PASS
sizing | B5 | tt | 1.8 | 27 | evaluate_window | 00 | WL3 | win_00_wl3_min | -9.973847e-06 | V | -0.18000000000000002 |  | PASS
sizing | B5 | tt | 1.8 | 27 | evaluate_window | 00 | WL3 | win_00_wl3_max | 1.622119e-05 | V |  | 0.18000000000000002 | PASS
sizing | B5 | tt | 1.8 | 27 | crossing | 00 | PCLK | clk_0_rise | 1.0025e-08 | s | 9.999999e-09 | 1.0050001000000001e-08 | PASS
sizing | B5 | tt | 1.8 | 27 | crossing | 00 | DEC0 | t_00_dec0_rise10 | 1.01241e-08 | s | 1e-08 | 2.005e-08 | PASS
sizing | B5 | tt | 1.8 | 27 | crossing | 00 | DEC0 | t_00_dec0_rise50 | 1.01469e-08 | s | 1e-08 | 2.005e-08 | PASS
sizing | B5 | tt | 1.8 | 27 | crossing | 00 | DEC0 | t_00_dec0_rise90 | 1.0178e-08 | s | 1e-08 | 2.005e-08 | PASS
sizing | B5 | tt | 1.8 | 27 | evaluation_delay | 00 | DEC0 | delay_00_dec0_rise | 1.21852e-10 | s | 0 |  | PASS
sizing | B5 | tt | 1.8 | 27 | output_slew | 00 | DEC0 | slew_00_dec0_rise | 5.39923e-11 | s | 0 |  | PASS
sizing | B5 | tt | 1.8 | 27 | crossing | 00 | WL0 | t_00_wl0_rise10 | 1.02217e-08 | s | 1e-08 | 2.005e-08 | PASS
sizing | B5 | tt | 1.8 | 27 | crossing | 00 | WL0 | t_00_wl0_rise50 | 1.03278e-08 | s | 1e-08 | 2.005e-08 | PASS
sizing | B5 | tt | 1.8 | 27 | crossing | 00 | WL0 | t_00_wl0_rise90 | 1.05164e-08 | s | 1e-08 | 2.005e-08 | PASS
sizing | B5 | tt | 1.8 | 27 | evaluation_delay | 00 | WL0 | delay_00_wl0_rise | 3.02815e-10 | s | 0 |  | PASS
sizing | B5 | tt | 1.8 | 27 | output_slew | 00 | WL0 | slew_00_wl0_rise | 2.94724e-10 | s | 0 |  | PASS
sizing | B5 | tt | 1.8 | 27 | crossing | 00 | PCLK | clk_0_fall | 2.0075e-08 | s | 2.0049999e-08 | 2.0100001e-08 | PASS
sizing | B5 | tt | 1.8 | 27 | crossing | 00 | DEC0 | t_00_dec0_fall10 | 2.01915e-08 | s | 2.005e-08 | 3.0000000000000004e-08 | PASS
sizing | B5 | tt | 1.8 | 27 | crossing | 00 | DEC0 | t_00_dec0_fall50 | 2.01765e-08 | s | 2.005e-08 | 3.0000000000000004e-08 | PASS
sizing | B5 | tt | 1.8 | 27 | crossing | 00 | DEC0 | t_00_dec0_fall90 | 2.01602e-08 | s | 2.005e-08 | 3.0000000000000004e-08 | PASS
sizing | B5 | tt | 1.8 | 27 | precharge_delay | 00 | DEC0 | delay_00_dec0_fall | 1.16521e-10 | s | 0 |  | PASS
sizing | B5 | tt | 1.8 | 27 | output_slew | 00 | DEC0 | slew_00_dec0_fall | 3.13603e-11 | s | 0 |  | PASS
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
