leofernandesc/Open-source-sram-memory-compiler/sims/row_decoder/results/captured_phase_interface_ss_margin_fall25000_settle5500_20261014/ss_selected_wl_window_comparison.png

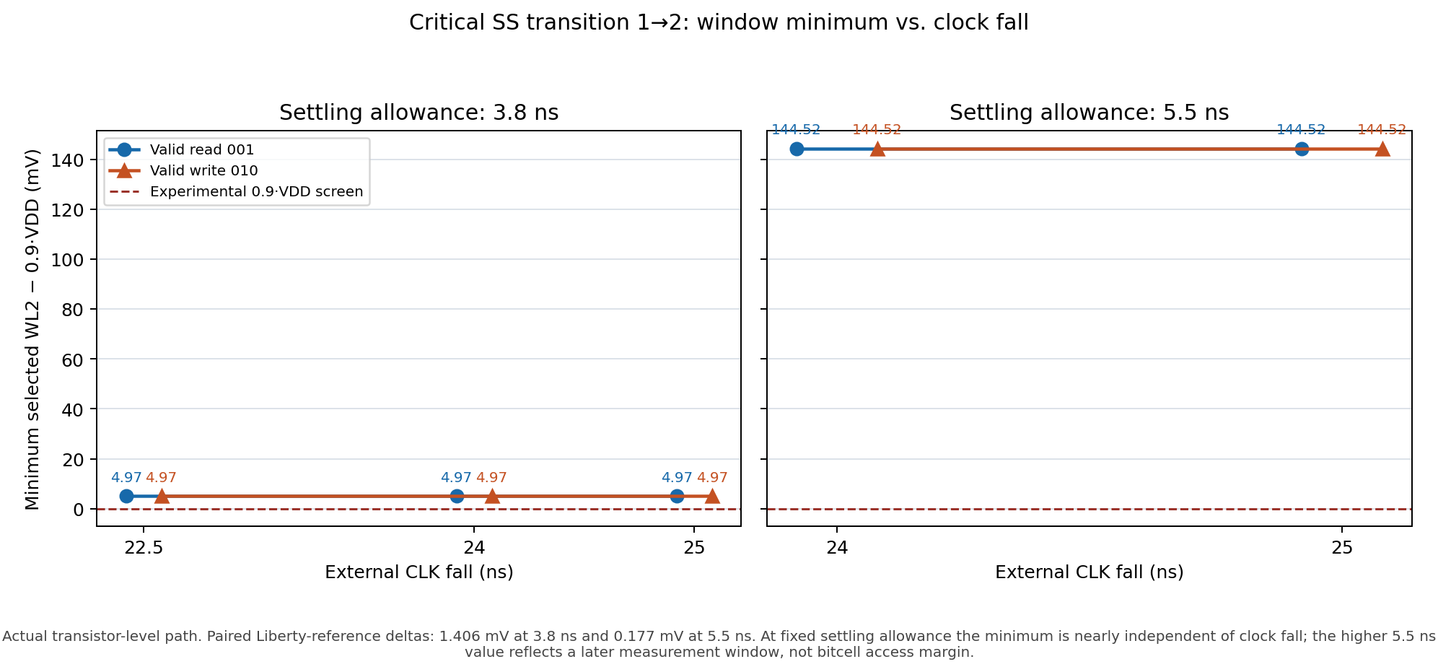
sims/row_decoder/results/captured_phase_interface_ss_margin_fall25000_settle5500_20261014/ss_selected_wl_window_comparison.png
