leofernandesc/Open-source-sram-memory-compiler/sims/row_decoder/results/row_decoder_pex_diagnostics_20261008/waveforms.pdf

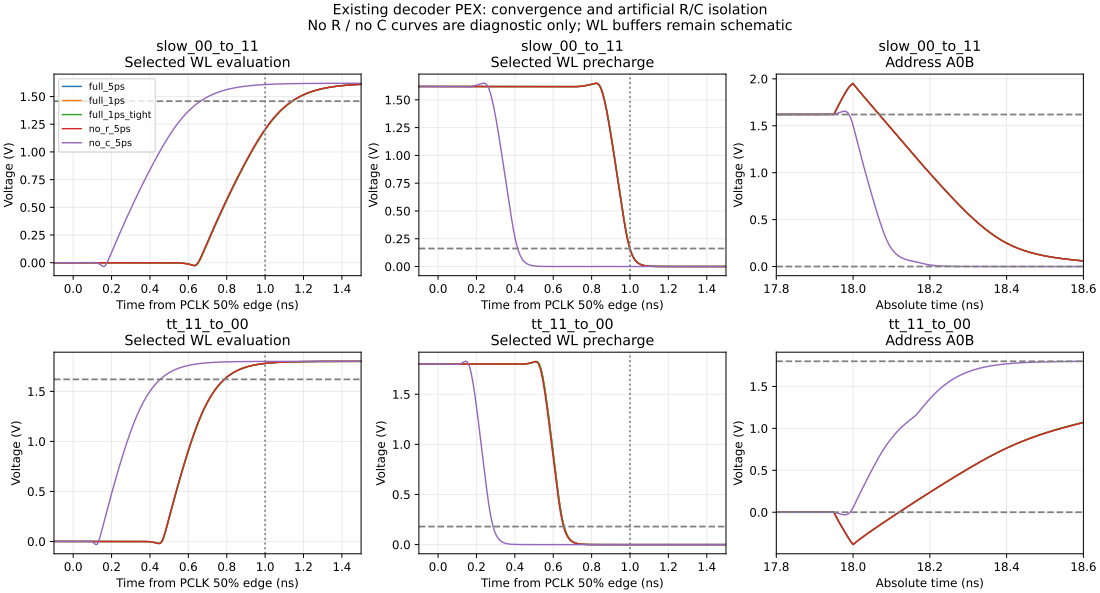
[picture p26: page 1]
Voltage (V); Absolute time (ns); slow_00_to_11 Address A0B; tt_11_to_00 Address A0B

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

slow_00_to_11
Selected WL evaluation

Selected WL precharge

full_5ps
full_1ps
full_1ps_tight
no_r_5ps no_c_5ps

Time from PCLK 50% edge (ns)

Absolute time (ns)
