leofernandesc/Open-source-sram-memory-compiler/docs/assets/row_decoder_b7_waveforms.pdf

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

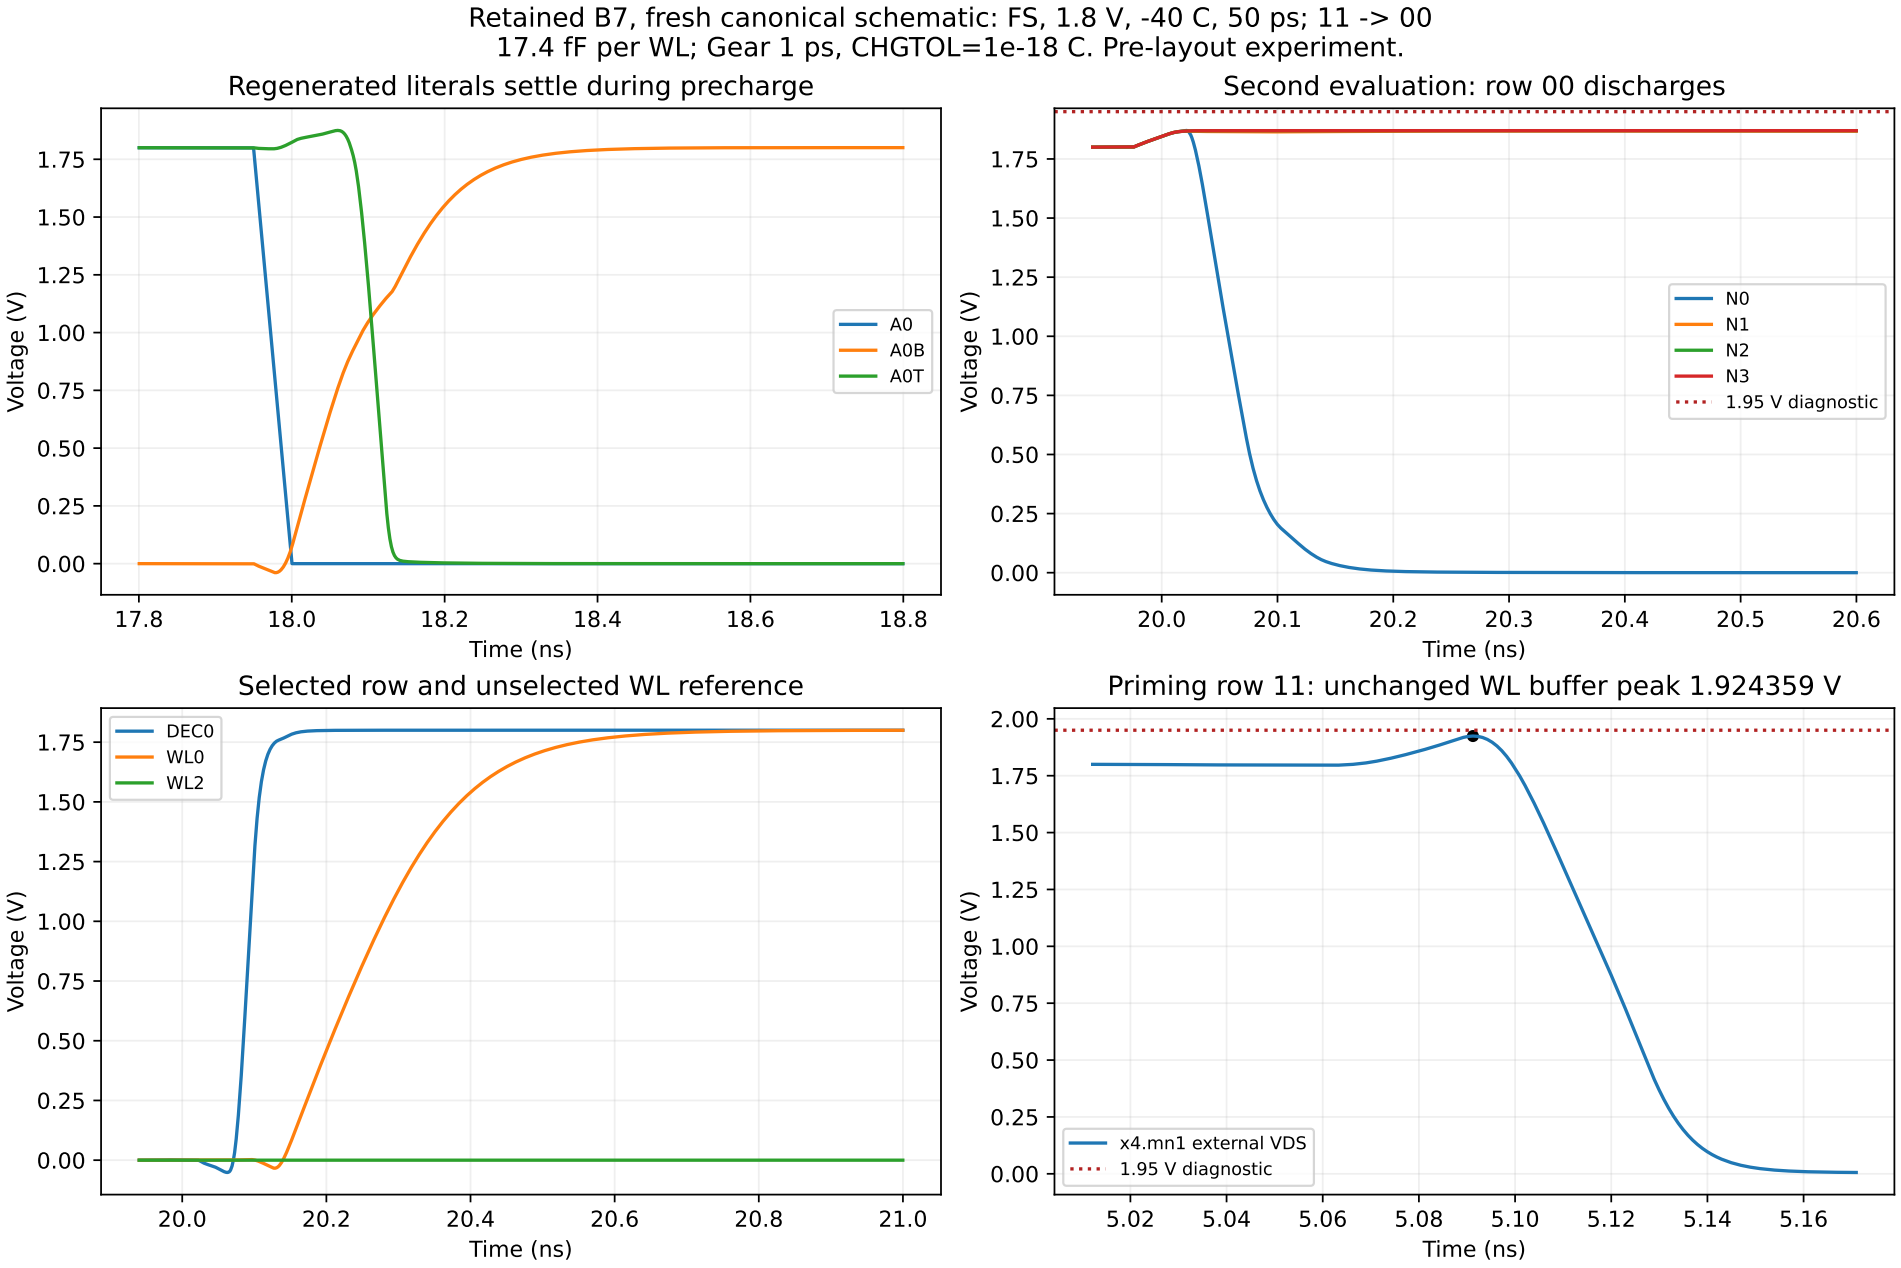
[picture p27: page 1]
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
