leofernandesc/Open-source-sram-memory-compiler/layout/row_decoder/reports/row_decoder_cap_only_unqualified.spice

* NGSPICE file created from row_decoder_flat.ext - technology: sky130A

.subckt row_decoder_flat VDD PCLK A0 A1 DEC0 DEC1 DEC3 DEC2 VSS
X0 VSS N2 DEC2 VSS sky130_fd_pr__nfet_01v8 ad=145G pd=2290k as=145G ps=2290k w=1000k l=75k
X1 VSS A1B A1T VSS sky130_fd_pr__nfet_01v8 ad=145G pd=2290k as=145G ps=2290k w=1000k l=75k
X2 VDD N2 DEC2 VDD sky130_fd_pr__pfet_01v8 ad=145G pd=2290k as=145G ps=2290k w=1000k l=75k
X3 VSS A1 A1B VSS sky130_fd_pr__nfet_01v8 ad=30.45G pd=710k as=30.45G ps=710k w=210k l=75k
X4 EVAL_GND A0T net4 VSS sky130_fd_pr__nfet_01v8 ad=72.5G pd=1290k as=72.5G ps=1290k w=500k l=75k
X5 VSS A0B A0T VSS sky130_fd_pr__nfet_01v8 ad=145G pd=2290k as=145G ps=2290k w=1000k l=75k
X6 VDD N3 DEC3 VDD sky130_fd_pr__pfet_01v8 ad=145G pd=2290k as=145G ps=2290k w=1000k l=75k
X7 VSS A0 A0B VSS sky130_fd_pr__nfet_01v8 ad=30.45G pd=710k as=30.45G ps=710k w=210k l=75k
X8 net2 A1B N1 VSS sky130_fd_pr__nfet_01v8 ad=72.5G pd=1290k as=72.5G ps=1290k w=500k l=75k
X9 net1 A1B N0 VSS sky130_fd_pr__nfet_01v8 ad=72.5G pd=1290k as=72.5G ps=1290k w=500k l=75k
X10 EVAL_GND A0B net3 VSS sky130_fd_pr__nfet_01v8 ad=72.5G pd=1290k as=72.5G ps=1290k w=500k l=75k
X11 VDD A1 A1B VDD sky130_fd_pr__pfet_01v8 ad=30.45G pd=710k as=30.45G ps=710k w=210k l=75k
X12 VDD PCLK N0 VDD sky130_fd_pr__pfet_01v8 ad=36.25G pd=790k as=36.25G ps=790k w=250k l=75k
X13 VDD PCLK N1 VDD sky130_fd_pr__pfet_01v8 ad=36.25G pd=790k as=36.25G ps=790k w=250k l=75k
X14 VDD PCLK N2 VDD sky130_fd_pr__pfet_01v8 ad=36.25G pd=790k as=36.25G ps=790k w=250k l=75k
X15 VDD A1B A1T VDD sky130_fd_pr__pfet_01v8 ad=145G pd=2290k as=145G ps=2290k w=1000k l=75k
X16 VSS PCLK EVAL_GND VSS sky130_fd_pr__nfet_01v8 ad=108.75001G pd=1790k as=108.75001G ps=1790k w=750k l=75k
X17 VDD N0 DEC0 VDD sky130_fd_pr__pfet_01v8 ad=145G pd=2290k as=145G ps=2290k w=1000k l=75k
X18 VDD N1 DEC1 VDD sky130_fd_pr__pfet_01v8 ad=145G pd=2290k as=145G ps=2290k w=1000k l=75k
X19 EVAL_GND A0T net2 VSS sky130_fd_pr__nfet_01v8 ad=72.5G pd=1290k as=72.5G ps=1290k w=500k l=75k
X20 VSS N1 DEC1 VSS sky130_fd_pr__nfet_01v8 ad=145G pd=2290k as=145G ps=2290k w=1000k l=75k
X21 net4 A1T N3 VSS sky130_fd_pr__nfet_01v8 ad=72.5G pd=1290k as=72.5G ps=1290k w=500k l=75k
X22 VDD A0 A0B VDD sky130_fd_pr__pfet_01v8 ad=30.45G pd=710k as=30.45G ps=710k w=210k l=75k
X23 VSS N3 DEC3 VSS sky130_fd_pr__nfet_01v8 ad=145G pd=2290k as=145G ps=2290k w=1000k l=75k
X24 EVAL_GND A0B net1 VSS sky130_fd_pr__nfet_01v8 ad=72.5G pd=1290k as=72.5G ps=1290k w=500k l=75k
X25 VDD PCLK N3 VDD sky130_fd_pr__pfet_01v8 ad=36.25G pd=790k as=36.25G ps=790k w=250k l=75k
X26 VDD A0B A0T VDD sky130_fd_pr__pfet_01v8 ad=145G pd=2290k as=145G ps=2290k w=1000k l=75k
X27 net3 A1T N2 VSS sky130_fd_pr__nfet_01v8 ad=72.5G pd=1290k as=72.5G ps=1290k w=500k l=75k
X28 VSS N0 DEC0 VSS sky130_fd_pr__nfet_01v8 ad=145G pd=2290k as=145G ps=2290k w=1000k l=75k
C0 net1 A1 0.11763f
C1 N2 net2 0.12388f
C2 N2 A0T 0.24467f
C3 A0 A1B 0.3807f
C4 N2 DEC3 0.12093f
C5 A0B net3 1.32126f
C6 A1T net3 2.76001f
C7 N1 net3 0.1227f
C8 A0 net1 0.11763f
C9 net1 A1B 2.61001f
C10 EVAL_GND A0B 5.1257f
C11 EVAL_GND A1T 0.30786f
C12 N1 EVAL_GND 0.30801f
C13 DEC2 VDD 1.00124f
C14 DEC2 PCLK 0.12093f
C15 A0B net4 0.11763f
C16 net4 A1T 2.76001f
C17 N1 net4 0.1227f
C18 A0B A1 10.5559f
C19 A1T A1 0.23245f
C20 N1 A1 0.24467f
C21 VDD N3 2.05114f
C22 N2 net3 0.37409f
C23 PCLK N3 0.86022f
C24 N2 EVAL_GND 0.30801f
C25 DEC2 DEC1 10.3242f
C26 A0B A0 2.15339f
C27 A1T A0 0.23245f
C28 A0B A1B 10.5816f
C29 A1T A1B 2.28205f
C30 N1 A0 0.24467f
C31 N1 A1B 1.48573f
C32 net2 VDD 0.12391f
C33 N2 net4 0.1227f
C34 VDD A0T 1.12289f
C35 DEC2 N0 0.12093f
C36 DEC2 DEC0 0.12603f
C37 N2 A1 0.24467f
C38 N3 DEC1 0.12548f
C39 VDD DEC3 1.00124f
C40 A0B net1 1.32126f
C41 net2 PCLK 0.11763f
C42 A1T net1 0.1227f
C43 PCLK A0T 0.23245f
C44 N1 net1 0.12388f
C45 PCLK DEC3 0.12093f
C46 N3 N0 0.24599f
C47 DEC0 N3 0.12596f
C48 N2 A0 0.24467f
C49 N2 A1B 0.24467f
C50 net2 DEC1 0.12548f
C51 A0T DEC1 0.12106f
C52 DEC3 DEC1 0.12603f
C53 N2 net1 0.12388f
C54 net2 N0 0.1227f
C55 net2 DEC0 0.12596f
C56 A0T N0 0.24599f
C57 DEC0 A0T 0.12141f
C58 VDD net3 0.12391f
C59 A0B A1T 0.29233f
C60 N1 A0B 0.24467f
C61 N1 A1T 0.24567f
C62 DEC3 N0 0.12093f
C63 DEC3 DEC0 0.12603f
C64 PCLK net3 0.11763f
C65 EVAL_GND VDD 0.30154f
C66 EVAL_GND PCLK 1.37774f
C67 net4 VDD 0.12391f
C68 VDD A1 1.44803f
C69 PCLK net4 0.11763f
C70 DEC1 net3 0.12548f
C71 PCLK A1 0.12127f
C72 N2 A0B 0.24479f
C73 N2 A1T 1.56073f
C74 N2 N1 10.5665f
C75 EVAL_GND DEC1 0.39232f
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
C218 net4 VSS 11.3747f
C219 net3 VSS 11.2388f
C220 net2 VSS 11.1083f
C221 EVAL_GND VSS 23.6466f
C222 net1 VSS 10.9724f
C223 A1T VSS 12.5419f
C224 A0T VSS 12.26f
C225 N3 VSS 15.2429f
C226 N2 VSS 14.8291f
C227 N1 VSS 14.5233f
C228 N0 VSS 14.262f
C229 A1B VSS 16.6099f
C230 A0B VSS 16.2598f
.ends
