leofernandesc/Open-source-sram-memory-compiler/sims/row_decoder/results/captured_address_read_row0_tt_20261010/simulation_input_netlist.spice

** sch_path: /work/sims/row_decoder/tb_row_decoder_sizing.sch
**.subckt tb_row_decoder_sizing
x1 net1 net2 net3 net4 DEC0 DEC1 DEC3 DEC2 GND row_decoder
VDD_SRC net1 GND 1.8
VPCLK net2 GND PULSE(0 1.8 10n 50p 50p 10n 20n)
VA0 net3 GND PULSE(0 1.8 22n 50p 50p 20n 40n)
VA1 net4 GND PULSE(0 1.8 42n 50p 50p 40n 80n)
x2 net1 DEC0 net5 GND wl_driver
x3 net1 DEC1 net6 GND wl_driver
x4 net1 DEC3 net8 GND wl_driver
x5 net1 DEC2 net7 GND wl_driver
C_WL0 net5 GND 17.4f m=1
C_WL1 net6 GND 17.4f m=1
C_WL2 net7 GND 17.4f m=1
C_WL3 net8 GND 17.4f m=1
**.ends

XPRECH0 net1 BL0 BLB0 PRECH GND precharge_w2p52_flat
XPRECH1 net1 BL1 BLB1 PRECH GND precharge_w2p52_flat
XPRECH2 net1 BL2 BLB2 PRECH GND precharge_w2p52_flat
XPRECH3 net1 BL3 BLB3 PRECH GND precharge_w2p52_flat
XPRECH4 net1 BL4 BLB4 PRECH GND precharge_w2p52_flat
XPRECH5 net1 BL5 BLB5 PRECH GND precharge_w2p52_flat
XPRECH6 net1 BL6 BLB6 PRECH GND precharge_w2p52_flat
XPRECH7 net1 BL7 BLB7 PRECH GND precharge_w2p52_flat

* expanding   symbol:  row_decoder.sym # of pins=9
** sym_path: /work/cells/row_decoder/row_decoder.sym
** sch_path: /work/cells/row_decoder/row_decoder.sch
.subckt row_decoder VDD PCLK A0 A1 DEC0 DEC1 DEC3 DEC2 VSS
X0 VSS.t25 PCLK.t0 EVAL_GND.t4 VSS.t24 sky130_fd_pr__nfet_01v8 ad=0.435 pd=3.58 as=0.435 ps=3.58 w=1.5 l=0.15
X1 net4.t1 A1T.t2 N3.t0 VSS.t13 sky130_fd_pr__nfet_01v8 ad=0.58 pd=4.58 as=0.58 ps=4.58 w=2 l=0.15
X2 VDD.t11 N3.t3 DEC3.t0 VDD.t10 sky130_fd_pr__pfet_01v8 ad=0.87 pd=6.58 as=0.87 ps=6.58 w=3 l=0.15
X3 net1.t1 A1B.t3 N0.t0 VSS.t8 sky130_fd_pr__nfet_01v8 ad=0.58 pd=4.58 as=0.58 ps=4.58 w=2 l=0.15
X4 VSS.t23 A0.t0 A0B.t1 VSS.t22 sky130_fd_pr__nfet_01v8 ad=0.2436 pd=2.26 as=0.2436 ps=2.26 w=0.84 l=0.15
X5 VDD.t3 N1.t3 DEC1.t1 VDD.t2 sky130_fd_pr__pfet_01v8 ad=0.87 pd=6.58 as=0.87 ps=6.58 w=3 l=0.15
X6 VSS.t17 N2.t2 DEC2.t1 VSS.t16 sky130_fd_pr__nfet_01v8 ad=0.58 pd=4.58 as=0.58 ps=4.58 w=2 l=0.15
X7 VSS.t10 A1B.t4 A1T.t0 VSS.t9 sky130_fd_pr__nfet_01v8 ad=0.58 pd=4.58 as=0.58 ps=4.58 w=2 l=0.15
X8 EVAL_GND.t1 A0B.t2 net3.t0 VSS.t1 sky130_fd_pr__nfet_01v8 ad=0.58 pd=4.58 as=0.58 ps=4.58 w=2 l=0.15
X9 VDD.t17 PCLK.t2 N2.t1 VDD.t16 sky130_fd_pr__pfet_01v8 ad=0.3625 pd=3.08 as=0.3625 ps=3.08 w=1.25 l=0.15
X10 VDD.t13 A1.t1 A1B.t0 VDD.t12 sky130_fd_pr__pfet_01v8 ad=0.2436 pd=2.26 as=0.2436 ps=2.26 w=0.84 l=0.15
X11 VDD.t7 A1B.t5 A1T.t1 VDD.t6 sky130_fd_pr__pfet_01v8 ad=0.58 pd=4.58 as=0.58 ps=4.58 w=2 l=0.15
X12 VDD.t21 PCLK.t4 N0.t1 VDD.t20 sky130_fd_pr__pfet_01v8 ad=0.3625 pd=3.08 as=0.3625 ps=3.08 w=1.25 l=0.15
X13 net3.t1 A1T.t3 N2.t0 VSS.t6 sky130_fd_pr__nfet_01v8 ad=0.58 pd=4.58 as=0.58 ps=4.58 w=2 l=0.15
X14 VDD.t15 A0.t1 A0B.t0 VDD.t14 sky130_fd_pr__pfet_01v8 ad=0.2436 pd=2.26 as=0.2436 ps=2.26 w=0.84 l=0.15
X15 VSS.t15 A0B.t4 A0T.t1 VSS.t14 sky130_fd_pr__nfet_01v8 ad=0.58 pd=4.58 as=0.58 ps=4.58 w=2 l=0.15
X16 VDD.t9 A0B.t5 A0T.t0 VDD.t8 sky130_fd_pr__pfet_01v8 ad=0.58 pd=4.58 as=0.58 ps=4.58 w=2 l=0.15
X17 VDD.t19 PCLK.t3 N1.t1 VDD.t18 sky130_fd_pr__pfet_01v8 ad=0.3625 pd=3.08 as=0.3625 ps=3.08 w=1.25 l=0.15
X18 VSS.t3 N1.t2 DEC1.t0 VSS.t2 sky130_fd_pr__nfet_01v8 ad=0.58 pd=4.58 as=0.58 ps=4.58 w=2 l=0.15
X19 net2.t0 A1B.t2 N1.t0 VSS.t7 sky130_fd_pr__nfet_01v8 ad=0.58 pd=4.58 as=0.58 ps=4.58 w=2 l=0.15
X20 VDD.t23 PCLK.t1 N3.t1 VDD.t22 sky130_fd_pr__pfet_01v8 ad=0.3625 pd=3.08 as=0.3625 ps=3.08 w=1.25 l=0.15
X21 VSS.t21 N3.t2 DEC3.t1 VSS.t20 sky130_fd_pr__nfet_01v8 ad=0.58 pd=4.58 as=0.58 ps=4.58 w=2 l=0.15
X22 EVAL_GND.t3 A0T.t3 net2.t1 VSS.t12 sky130_fd_pr__nfet_01v8 ad=0.58 pd=4.58 as=0.58 ps=4.58 w=2 l=0.15
X23 VSS.t5 N0.t2 DEC0.t0 VSS.t4 sky130_fd_pr__nfet_01v8 ad=0.58 pd=4.58 as=0.58 ps=4.58 w=2 l=0.15
X24 VDD.t5 N0.t3 DEC0.t1 VDD.t4 sky130_fd_pr__pfet_01v8 ad=0.87 pd=6.58 as=0.87 ps=6.58 w=3 l=0.15
X25 VSS.t19 A1.t0 A1B.t1 VSS.t18 sky130_fd_pr__nfet_01v8 ad=0.2436 pd=2.26 as=0.2436 ps=2.26 w=0.84 l=0.15
X26 EVAL_GND.t2 A0T.t2 net4.t0 VSS.t11 sky130_fd_pr__nfet_01v8 ad=0.58 pd=4.58 as=0.58 ps=4.58 w=2 l=0.15
X27 VDD.t1 N2.t3 DEC2.t0 VDD.t0 sky130_fd_pr__pfet_01v8 ad=0.87 pd=6.58 as=0.87 ps=6.58 w=3 l=0.15
X28 EVAL_GND.t0 A0B.t3 net1.t0 VSS.t0 sky130_fd_pr__nfet_01v8 ad=0.58 pd=4.58 as=0.58 ps=4.58 w=2 l=0.15
R0 DEC3.n0 DEC3.t0 88.9801
R1 DEC3.n0 DEC3.t1 50.6916
R2 DEC3 DEC3.n0 7.45705
R3 DEC2.n0 DEC2.t0 88.9801
R4 DEC2.n0 DEC2.t1 50.6916
R5 DEC2 DEC2.n0 7.45705
R6 DEC1.n0 DEC1.t1 88.9801
R7 DEC1.n0 DEC1.t0 50.6916
R8 DEC1 DEC1.n0 7.45705
R9 DEC0.n0 DEC0.t1 88.9801
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
R664 VSS.n76 VSS.n75 0.852767
R665 VSS.n77 VSS.n76 0.852767
R666 VSS.n82 VSS.n81 0.852767
R667 VSS.n83 VSS.n82 0.852767
R668 VSS.n86 VSS.n85 0.852767
R669 VSS.n87 VSS.n86 0.852767
R670 VSS.n218 VSS.n0 0.6491
R671 VSS.n185 VSS.n184 0.6491
R672 VSS.n183 VSS.n182 0.6491
R673 VSS.n74 VSS.n18 0.6491
R674 VSS.n78 VSS.n77 0.6491
R675 VSS.n80 VSS.n79 0.6491
R676 VSS.n84 VSS.n83 0.6491
R677 VSS.n88 VSS.n87 0.6491
R678 VSS.n219 VSS.n218 0.194767
R679 VSS.n185 VSS.n0 0.194767
R680 VSS.n184 VSS.n183 0.194767
R681 VSS.n182 VSS.n181 0.194767
R682 VSS.n75 VSS.n74 0.194767
R683 VSS.n79 VSS.n78 0.194767
R684 VSS.n81 VSS.n80 0.194767
R685 VSS.n85 VSS.n84 0.194767
R686 net4.n0 net4.t1 43.6291
R687 net4.n0 net4.t0 42.0666
R688 net4 net4.n0 14.7632
R689 net3.n0 net3.t1 43.6291
R690 net3.n0 net3.t0 42.0666
R691 net3 net3.n0 14.7632
R692 net2.n0 net2.t0 43.6291
R693 net2.n0 net2.t1 42.0666
R694 net2 net2.n0 14.7632
R695 EVAL_GND.n1 EVAL_GND.t4 70.7982
R696 EVAL_GND.n0 EVAL_GND.t2 54.5897
R697 EVAL_GND.n2 EVAL_GND.t3 52.0141
R698 EVAL_GND.n0 EVAL_GND.t1 52.0141
R699 EVAL_GND EVAL_GND.t0 52.0141
R700 EVAL_GND EVAL_GND.n2 2.5761
R701 EVAL_GND.n1 EVAL_GND.n0 2.18443
R702 EVAL_GND.n2 EVAL_GND.n1 1.24443
R703 net1.n0 net1.t1 43.6291
R704 net1.n0 net1.t0 42.0666
R705 net1 net1.n0 14.7632
R706 N3.n0 N3.t3 366.336
R707 N3.n0 N3.t2 282.827
R708 N3.n1 N3.t1 226.13
R709 N3.n1 N3.t0 50.6916
R710 N3 N3.n1 5.448
R711 N3 N3.n0 1.83193
R712 N2.n0 N2.t3 366.336
R713 N2.n0 N2.t2 282.827
R714 N2.n1 N2.t1 226.13
R715 N2.n1 N2.t0 50.6916
R716 N2 N2.n1 5.448
R717 N2 N2.n0 1.83193
R718 N1.n0 N1.t3 366.336
R719 N1.n0 N1.t2 282.827
R720 N1.n1 N1.t1 226.13
R721 N1.n1 N1.t0 50.6916
R722 N1 N1.n1 5.448
R723 N1 N1.n0 1.83193
R724 N0.n0 N0.t3 366.336
R725 N0.n0 N0.t2 282.827
R726 N0.n1 N0.t1 226.13
R727 N0.n1 N0.t0 50.6916
R728 N0 N0.n1 5.448
R729 N0 N0.n0 1.83193
R730 A1T.n0 A1T.t2 292.902
R731 A1T.n0 A1T.t3 290.327
R732 A1T.n1 A1T.t1 118.816
R733 A1T.n1 A1T.t0 50.6916
R734 A1T A1T.n1 12.948
R735 A1T A1T.n0 7.00193
R736 A1B.n3 A1B.t0 336.339
R737 A1B.n1 A1B.t5 290.88
R738 A1B.n0 A1B.t2 290.402
R739 A1B.n0 A1B.t3 287.827
R740 A1B.n2 A1B.t4 287.827
R741 A1B.n3 A1B.t1 127.172
R742 A1B A1B.n3 10.448
R743 A1B A1B.n2 0.970267
R744 A1B.n1 A1B.n0 0.617767
R745 A1B.n2 A1B.n1 0.2261
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
C1 PCLK net3 0.04024f
C2 net4 m1_160_n1740# 0.00615f
C3 PCLK net2 0.0402f
C4 VDD A0T 0.63817f
C5 DEC2 PCLK 0.06771f
C6 A0B A1 0.15515f
C7 DEC1 PCLK 0.08569f
C8 A1B A1 0.55817f
C9 DEC3 EVAL_GND 0.04421f
C10 m1_160_n1740# A0T 4.21801f
C11 net4 A0T 0.76077f
C12 A0B net3 0.76081f
C13 N3 PCLK 0.11923f
C14 A1T A1 0.05911f
C15 A0B A0 0.51553f
C16 net3 EVAL_GND 0.24542f
C17 A1T net3 0.09048f
C18 A0B net2 0
C19 A1B net2 0.09048f
C20 VDD DEC3 0.599f
C21 DEC2 A0B 0.06914f
C22 DEC1 A0B 0
C23 DEC0 N1 0.0012f
C24 VDD A1 0.78278f
C25 m1_160_n1740# DEC3 0.04282f
C26 net4 DEC3 0
C27 net2 EVAL_GND 0.24542f
C28 PCLK N2 0.23665f
C29 DEC2 EVAL_GND 0.11185f
C30 m1_160_n1740# A1 0.00456f
C31 DEC1 EVAL_GND 0.11187f
C32 VDD net3 0.1317f
C33 A1T DEC2 0.01841f
C34 A1T DEC1 0
C35 m1_160_n1740# net3 0
C36 N3 EVAL_GND 0.06895f
C37 VDD A0 0.5738f
C38 PCLK N1 0.19891f
C39 N3 A1T 0.83934f
C40 m1_160_n1740# A0 0.00794f
C41 DEC3 A0T 0.06914f
C42 VDD net2 0.13178f
C43 VDD DEC2 0.60061f
C44 A1 A0T 0.0717f
C45 VDD DEC1 0.60141f
C46 m1_160_n1740# net2 0
C47 A0B N2 0.06555f
C48 PCLK DEC0 0.06771f
C49 DEC2 m1_160_n1740# 0
C50 DEC1 m1_160_n1740# 0
C51 VDD N3 1.74036f
C52 EVAL_GND N2 0.14383f
C53 A1T N2 0.8449f
C54 N3 m1_160_n1740# 0.03493f
C55 A0 A0T 0.06275f
C56 N0 N1 0.06254f
C57 N3 net4 0.2514f
C58 A1B N1 0.83934f
C59 N1 EVAL_GND 0.161f
C60 net2 A0T 0.76077f
C61 DEC2 A0T 0
C62 DEC1 A0T 0.06914f
C63 N0 DEC0 0.99369f
C64 A0B DEC0 0.0692f
C65 VDD N2 1.67206f
C66 A1B DEC0 0.01841f
C67 N3 A0T 0.06583f
C68 m1_160_n1740# N2 0
C69 DEC0 EVAL_GND 0.11185f
C70 A0 A1 0.21908f
C71 VDD N1 1.74036f
C72 N0 PCLK 0.16365f
C73 A0B PCLK 0.38093f
C74 A1B PCLK 0.76415f
C75 m1_160_n1740# N1 0
C76 DEC0 net1 0
C77 PCLK EVAL_GND 0.43002f
C78 A1T PCLK 0.66526f
C79 VDD DEC0 0.60061f
C80 N3 DEC3 0.99369f
C81 m1_160_n1740# DEC0 0
C82 DEC2 net3 0
C83 PCLK net1 0.0402f
C84 N0 A0B 0.06555f
C85 N1 A0T 0.06555f
C86 N0 A1B 0.90223f
C87 A1B A0B 0.44394f
C88 VDD PCLK 3.22314f
C89 N0 EVAL_GND 0.0757f
C90 A0B EVAL_GND 0.30343f
C91 m1_160_n1740# PCLK 1.93989f
C92 net4 PCLK 0.032f
C93 DEC1 net2 0
C94 A1B EVAL_GND 0.06861f
C95 N0 A1T 0
C96 A1T A0B 0.13727f
C97 A1T A1B 1.37238f
C98 DEC0 A0T 0
C99 A1T EVAL_GND 0.13715f
C100 N3 DEC2 0.0012f
C101 N0 net1 0.2514f
C102 A0B net1 0.76081f
C103 A1B net1 0.09048f
C104 net3 N2 0.2514f
C105 VDD N0 1.74673f
C106 net1 EVAL_GND 0.17565f
C107 VDD A0B 1.41632f
C108 PCLK A0T 0.18488f
C109 VDD A1B 1.6531f
C110 N0 m1_160_n1740# 0
C111 m1_160_n1740# A0B 3.54674f
C112 m1_160_n1740# A1B 1.94209f
C113 VDD EVAL_GND 0.10507f
C114 VDD A1T 0.80047f
C115 DEC2 N2 0.99369f
C116 net4 EVAL_GND 0.24542f
C117 A1T m1_160_n1740# 2.19149f
C118 A1T net4 0.09048f
C119 N3 N2 0.06254f
C120 VDD net1 0.13177f
C121 net2 N1 0.2514f
C122 m1_160_n1740# net1 0
C123 DEC1 N1 0.99369f
C124 A0B A0T 1.32151f
C125 A1B A0T 0.04768f
C126 VDD m1_160_n1740# 0.06508f
C127 EVAL_GND A0T 0.36987f
C128 VDD net4 0.13178f
C129 DEC3 VSS 1.94483f
C130 DEC2 VSS 1.88892f
C131 DEC1 VSS 1.88971f
C132 DEC0 VSS 1.88893f
C133 PCLK VSS 7.19133f
C134 A1 VSS 2.27951f
C135 A0 VSS 1.55459f
C136 VDD VSS 27.24516f
C137 m1_160_n1740# VSS 13.3375f ; **FLOATING
C138 net4 VSS 1.88133f
C139 net3 VSS 1.87812f
C140 net2 VSS 1.87814f
C141 EVAL_GND VSS 7.58353f
C142 net1 VSS 1.85494f
C143 N3 VSS 3.15544f
C144 N2 VSS 3.0694f
C145 N1 VSS 3.01477f
C146 N0 VSS 2.98667f
C147 A1T VSS 10.71547f
C148 A1B VSS 7.67092f
C149 A0T VSS 8.56598f
C150 A0B VSS 8.06175f
C151 A0B.n0 VSS 4.99996f
C152 A0B.n1 VSS 1.42999f
C153 A0B.n2 VSS 1.54102f
C154 A0B.t1 VSS 0.07827f
C155 A0B.t0 VSS 0.06358f
C156 A0B.n3 VSS 1.17047f
C157 A0T.n0 VSS 5.79935f
C158 A0T.t1 VSS 0.17805f
C159 A0T.t0 VSS 0.12494f
C160 A0T.n1 VSS 1.39758f
C161 A1B.n0 VSS 3.81621f
C162 A1B.n1 VSS 1.16086f
C163 A1B.n2 VSS 1.65659f
C164 A1B.t1 VSS 0.07793f
C165 A1B.t0 VSS 0.06069f
C166 A1B.n3 VSS 1.23511f
C167 A1T.n0 VSS 4.52919f
C168 A1T.t0 VSS 0.16429f
C169 A1T.t1 VSS 0.11579f
C170 A1T.n1 VSS 1.28101f
C171 N0.n0 VSS 2.24328f
C172 N0.t0 VSS 0.21491f
C173 N0.t1 VSS 0.10081f
C174 N0.n1 VSS 1.19171f
C175 N1.n0 VSS 2.27086f
C176 N1.t0 VSS 0.22527f
C177 N1.t1 VSS 0.10166f
C178 N1.n1 VSS 1.20637f
C179 N2.n0 VSS 2.24803f
C180 N2.t0 VSS 0.21532f
C181 N2.t1 VSS 0.10096f
C182 N2.n1 VSS 1.19424f
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
