leofernandesc/Open-source-sram-memory-compiler/(list of files, drawings)

Other design files:
sims/row_decoder/results/buffered_b7_candidate/schematic_equivalence.json
