leofernandesc/Open-source-sram-memory-compiler/(commit log)

2026-09-21 docs: add git flow documentation and workflow
2026-09-21 feat: Add SKY130 6T SRAM cell schematic
    Adiciona o esquemático inicial da célula SRAM 6T no Xschem com dispositivos SKY130, nós Q/QB, sinais BL/BLB/WL e conexões de alimentação.
    [sram_6t.sch]
2026-09-21 docs: Document initial 6T SRAM cell specification
    Documenta a topologia, o inventário de transistores, os parâmetros iniciais e os critérios de validação da célula SRAM 6T.
2026-09-21 chore: Track SRAM schematic design state
    Registra o estado atual da execução do fluxo de desenvolvimento da célula SRAM 6T.
2026-09-24 feat: define SKY130A SRAM 6T leaf cells
    Define a topologia da bitcell SRAM 6T, o sizing inicial e o contrato de pinos das células periféricas para o fluxo SKY130A.
    [bitcell_6t.sch, precharge.sch, sense_amp.sch, sram_6t.sch, wl_driver.sch, write_driver.sch]
2026-09-24 test: automate SKY130A bitcell read sweep
    Adiciona testbenches ngspice para retenção, escrita e leitura, além da varredura automatizada de capacitância, estados armazenados e corners SKY130A.
    [bitcell_read_sweep.csv]
2026-09-24 docs: document SRAM 6T validation flow
    Documenta o desenvolvimento manual, os testes ngspice, os erros encontrados, a automação e as limitações atuais da validação da bitcell SRAM 6T.
2026-09-24 feat: add hierarchical SRAM bitcell testbench
    Adiciona o símbolo hierárquico da bitcell 6T, o testbench visual de leitura e a fonte de estímulo reconhecida pelo ERC do Xschem.
    [tb_bitcell_6t_read.sch]
2026-09-24 chore: remove obsolete simulation placeholder
    Remove o arquivo placeholder do diretório de simulações, que já contém os decks e scripts do projeto.
2026-09-24 chore: ignore generated simulation artifacts
    Ignora caches Python, logs, arquivos RAW do ngspice, resultados temporários das skills e backups de editores.
2026-09-24 fix: enable Xschem bitcell simulation
    Parametriza o sizing da bitcell, adiciona o smoke test isolado, corrige a pré-carga e permite simular a célula e o testbench hierárquico com os modelos SKY130A.
    [bitcell_6t.sch, tb_bitcell_6t_read.sch]
2026-09-24 test: update bitcell read margin sweep
    Mede o diferencial das bitlines em 21 ns, corrige o critério de leitura e registra os resultados dos 40 casos nos cinco corners.
    [bitcell_read_sweep.csv]
2026-09-25 feat: add draft dynamic 2-to-4 row decoder
    [row_decoder.sch]
2026-09-25 refactor: organize leaf cells and simulation assets
    [bitcell_6t.sch, bitcell_read_sweep.csv, precharge.sch, sense_amp.sch, sram_6t.sch, tb_bitcell_6t_read.sch, wl_driver.sch, write_driver.sch]
2026-10-06 feat: add peripheral driver layouts
    [wl_driver.sch, write_driver.sch]
2026-10-06 test: add peripheral characterization evidence
    [bitcell_write_driver_60ff_ff_1p8_125.csv, bitcell_write_driver_60ff_ss_1p62_m40.csv, bitcell_write_driver_60ff_tt.csv, bitcell_write_driver_65ff_pvt.csv, bitcell_write_driver_65ff_ss_1p62_m40_final_10ps.csv, bitcell_write_driver_exploratory.csv, bitcell_write_driver_timing_1p62.csv, bitcell_write_driver_timing_nominal.csv]
2026-10-06 test: add dynamic row decoder TT screening
    [row_decoder.sch, row_decoder_tt.csv, tb_row_decoder.sch]
2026-10-06 fix: isolate dynamic decoder evaluation rail
    [row_decoder.sch, row_decoder_tt.csv]
2026-10-06 test: record loaded row decoder sizing baseline
    [tb_row_decoder_sizing.sch]
2026-10-06 test: compare dynamic decoder evaluation sizing
    [row_decoder.sch]
2026-10-06 test: compare shared footer sizing in row decoder
    [row_decoder.sch]
2026-10-06 test: record row decoder footer sweep at 1.25um
    [row_decoder.sch]
2026-10-06 test: record decoder footer sizing at 0.75um
    [row_decoder.sch]
2026-10-06 test: record row decoder footer sizing at 0.50um
    [row_decoder.sch]
2026-10-07 fix: restore decoder simulation and document sizing campaign
    [b5_review_tt_clock250_samples.csv, b5_review_tt_clock250_samples_metrics.csv, b5_review_tt_samples.csv, b5_review_tt_samples_metrics.csv, b5_review_tt_trap5_samples.csv, b5_review_tt_trap5_samples_metrics.csv]
2026-10-07 test: record decoder gear 5ps sensitivity
    [b5_review_tt_gear5_samples.csv, b5_review_tt_gear5_samples_metrics.csv]
2026-10-07 fix: reduce dynamic decoder precharge and address feedthrough
    [b6_functional_tt_samples.csv, b6_functional_tt_samples_metrics.csv, b6_ss_m40_samples.csv, b6_ss_m40_samples_metrics.csv, b6_tt_samples.csv, b6_tt_samples_metrics.csv, metrics.csv, node_peaks.csv]
2026-10-07 test: characterize dynamic decoder histories and electrical margins
    [address_peak_samples.csv, boundary_grid.csv, campaign_totals.csv, checks.csv, fast_address_complement_transfer.csv, fast_decoder_output_transfer.csv, fast_wl_first_transfer.csv, fast_wl_second_transfer.csv]
2026-10-07 fix: retain buffered dynamic decoder with measured voltage margin
    [b7_current_tt_samples.csv, b7_current_tt_samples_metrics.csv, boundary_grid.csv, campaign_totals.csv, checks.csv, original_b6.sch, plot_samples.csv, robustness_candidates.csv]
2026-10-07 docs: close decoder capture-to-PCLK timing budget
    [checks.csv, summary.csv, terminals.csv]
2026-10-07 test: add peripheral simulation artifacts
    [bitcell_write_driver_60ff_pvt.csv, leaf_peripheral_ss_1p62_m40.csv, wl_driver_smoke_tt.csv]
2026-10-07 feat: publish row decoder RC PEX results
    [checks.csv, summary.csv, terminals.csv]
2026-10-07 fix: reject row decoder PEX with negative capacitance
2026-10-07 test: record row decoder extracted PEX results
    [checks.csv, comparison.csv, row_decoder.sch, summary.csv, terminals.csv]
2026-10-07 fix: close decoder RC timing and voltage screens
    [checks.csv, comparison.csv, row_decoder.sch, summary.csv, terminals.csv]
2026-10-08 layout: compact decoder and prepare remote RC extraction
    [capacitance_by_node.csv, checks.csv, failed_checks.csv, plot_samples.csv, sizing_history.csv, summary.csv, terminal_warnings.csv, terminals.csv]
2026-10-08 feat: complete dynamic decoder RC PEX validation
    [checks.csv, comparison.csv, summary.csv, terminals.csv]
2026-10-08 test: extend compact decoder checks to FF hot
    [checks.csv, comparison.csv, summary.csv, terminals.csv]
2026-10-08 test: record full TT decoder address-pair matrix
    [checks.csv, comparison.csv, summary.csv, terminals.csv]
2026-10-08 test: add full FF decoder address-pair matrix
    [checks.csv, comparison.csv, summary.csv, terminals.csv]
2026-10-08 test: complete SS decoder matrix and energy review
    [checks.csv, comparison.csv, summary.csv, terminals.csv]
2026-10-08 test: audit decoder signed bias and op-point startup
    [checks.csv, comparison.csv, signed_device_domain_audit.csv, signed_domain_audit.csv, summary.csv, terminals.csv]
2026-10-09 test: complete decoder operating-point matrices
    [checks.csv, comparison.csv, signed_domain_audit.csv, summary.csv, terminals.csv]
2026-10-09 docs: review decoder bias scope and characterization plan
    [external_intrinsic_bias.csv]
2026-10-09 test: requalify decoder timing with extracted row load
    [checks.csv, row_8_wl_pex_capacitance_latch_t0_requal_20261008.csv, summary.csv, terminals.csv]
2026-10-09 feat: characterize combined decoder and WL PEX timing
    [checks.csv, summary.csv, terminals.csv]
2026-10-09 fix: correct WL testbench pin ordering
    Requalify the wordline driver against its declared Xschem terminal order, document the maximum row-Ceff stress, and record current decoder hold, charge-injection, and phase-duration screens.
    [checks.csv, summary.csv, terminals.csv, wl_driver_pex_smoke_3corner_pvt_pinorderfix_20261009.csv, wl_driver_pex_smoke_full_row_ss_20261009.csv, wl_driver_smoke_3corner_pvt_pinorderfix_20261009.csv, wl_driver_smoke_full_row_ss_20261009.csv]
2026-10-09 test: screen decoder with distributed row PEX
    [checks.csv, row_taps.csv, summary.csv, terminals.csv]
2026-10-09 test: complete decoder physical-row and access screens
    [checks.csv, row_taps.csv, summary.csv, terminals.csv]
2026-10-09 fix(sram): align decoder row Ceff provenance
    [run_row_decoder_capture_timing.py, run_row_decoder_distributed_row.py]
2026-10-09 feat(sram): screen decoder with Danilo precharge PEX
    [checks.csv, summary.csv, terminals.csv]
2026-10-09 test(sram): screen selected 2.10ns phase candidate
    [checks.csv, summary.csv, terminals.csv]
2026-10-09 fix(sram): correct precharge release timing in phase screen
    [checks.csv, summary.csv, terminals.csv]
2026-10-09 feat(sram): screen transistor phase-chain candidate
    [checks.csv, summary.csv, terminals.csv]
2026-10-09 feat(peripherals): add Xschem PCLK phase source screen
    [checks.csv, pclk_phase_source.sch, phase_and3.sch, phase_delay_inv.sch, phase_or2.sch, summary.csv, terminals.csv]
2026-10-09 feat(sram): screen PCLK phase-chain sizing
    [checks.csv, phase_delay_inv.sch, summary.csv, terminals.csv]
2026-10-09 fix(sram): enforce PCLK release guard and screen qualifier skew
    [checks.csv, summary.csv, terminals.csv]
2026-10-09 feat: model captured decoder qualifier with Liberty timing
    [checks.csv, summary.csv, terminals.csv]
2026-10-09 feat: add captured decoder access qualifier
    [captured_pclk_phase_source.sch, valid_access_capture.sch, vectors.csv]
2026-10-09 test: characterize captured access qualifier in SPICE
    [checks.csv]
2026-10-09 test: integrate captured qualifier with phase path
    [actual_representative.csv, checks.csv, liberty_reference_representative.csv, matched_comparison.csv, summary.csv]
2026-10-10 feat: capture row address for decoder integration
    [actual_representative.csv, captured_row_decoder_control.sch, checks.csv, liberty_reference_representative.csv, matched_comparison.csv, row_address_capture.sch, summary.csv]
2026-10-10 test: characterize row address setup and hold
    [checks.csv]
2026-10-10 test: screen captured valid write path
    [checks.csv, matched_comparison.csv, summary.csv]
2026-10-10 test: cover all captured read row targets
    [checks.csv, matched_comparison.csv, summary.csv]
